lnminh1411/ESP32-PC-Control-System/host/pc_stats/README.md

# ESP32-Helper

Windows service that collects configured PC stats (hardware sensors from [PcHwCtl](#pchwctl-sensors-monitors-process-lasso)'s sensor feed) and streams them to the ESP32-S3 carrier board over a WinUSB bulk pipe (with vendor HID and CDC serial fallbacks).

## Two processes, one exe

`ESP32-Helper.exe` runs as two processes, each with its own worker threads:
- **Service** (`ESP32PcStats`, SYSTEM, session 0): stats, the USB link (WinUSB/HID/serial), the relays to PcHwCtl and LocalAIHost (power actions, screenshots, presence, RGB/fans, monitors, night mode, local AI), shutdown announcements, `@source` and `@claude` polling, text rendering, cover-art streaming. It runs before sign-in and after sign-out, at High CPU priority so the board's frames and replies stay on time while the PC is busy (the user-session half stays Normal).
- **User-session half** (`ESP32-Helper.exe --user`): Antigravity quota, Claude Code token refresh, media session and cover art, input idle and the foreground app. Windows keeps session 0 away from the desktop and the user's media sessions, so this part has to run in the user's session. The service starts it there with the signed-in user's token (normal user rights, not elevated) once someone signs in. It restarts the half if it dies (after 2 s, or 30 s if it died within 15 s of starting) and moves it on a user switch. In `--console` mode it starts the half as the current user (`--no-user` skips it).

The two talk over a pair of anonymous pipes (UTF-8 lines):

| Direction | Line | Meaning |
|---|---|---|
| user half to service | `F <feed> <n>` + n `key=value` lines | feed `agy`, `media` or `idle`, read by `@source <name> helper:<feed> <ms>` |
| user half to service | `A <base64>` | cover art, 144x144 RGB565 big-endian (41,472 bytes) |
| user half to service | `L <text>` | log line, written to `log.txt` as `user: <text>` |

Nothing travels from the service to the user half; that pipe only tells the half the service is alive. The user half exits as soon as the pipes break, so it never outlives the service. A `helper:` source counts as up while the user half is connected.

## Transport

`auto` (the default) tries three links in order, on the ESP32-S3 (Espressif VID `303A`):

1. **WinUSB bulk pipe** (interface 3, endpoints `0x04` OUT / `0x84` IN, device interface GUID `{39531AD1-55E5-4933-869D-123B4E7D172C}`). The board's MS OS 2.0 descriptors make Windows bind WinUSB by itself, with no INF and no driver install. Full-speed bulk moves about 1 MB/s against HID's 63 bytes per 1 ms frame: a cover (41 KB of base64) arrives in 115 ms instead of 690 ms. The board's parser is now the limit, not the wire. The board sends its lines (`!auth`, `!txt`, `!art`, `!power`, `!hw`, `!ai`, `!mon`, `!night`, `!shot`, `!pres`) back on this pipe while the service has sent on it within 3 s, else over HID. The service ignores what it reads in the first 500 ms after opening the pipe: an old request left in the board's buffer is never acted on.
2. **Vendor HID** (UsagePage `0xFF00`, Usage `0x01`, report length 64 bytes): Windows' in-box HID driver.
3. **Serial**: the USB CDC COM port (`@s`, `@t`, `@e` lines), or `--transport serial`.

`--transport winusb` or `--transport hid` uses only that link. With either of the first two, the CDC COM port stays free for flashing and consoles.

**Link challenge**: when `LINK_KEY` is set, the service sends `@auth <nonce>` on each new link and sends no stats and acts on no board line until the board answers `!auth <hex>` (first 16 bytes of HMAC-SHA256(`LINK_KEY`, `esp32-link <nonce>`)). An empty `LINK_KEY` means no challenge. See [docs/helper.md](../../docs/helper.md).

## Build

Run `build.cmd` from Command Prompt:
```cmd
host\pc_stats\build.cmd
```
First `gen_settings.ps1` writes `Settings.g.cs` (gitignored) from the `HOST_*` keys of `firmware\main\settings.h` (defaults in `settings_or_example.h`, `settings_example.h` when there is no `settings.h`), plus the two secrets the helper needs: `LINK_KEY` and `DISCORD_SHOT_WEBHOOK` (as `SHOT_WEBHOOK`). It reads no other key. Because the exe carries those two, `install.ps1` locks the install folder to SYSTEM and Administrators. Then it runs `dotnet publish` on `ESP32-Helper.csproj` and leaves one self-contained, single-file `build\ESP32-Helper.exe` (~56 MB, .NET 10 runtime included, nothing to install on the PC that runs it). Building needs the .NET 10 SDK; packages come from nuget.org through the repo's `nuget.config`.

Hardware sensors come from PcHwCtl (`E:\PC Hardware Controller`, service `PcHwCtl`), the only LibreHardwareMonitor reader on the PC; the helper has no LibreHardwareMonitor or PawnIO dependency of its own. `--list` shows what the feed carries.

## Installation & Removal

Run PowerShell as Administrator:
- **Install**: `.\install.ps1` (or `.\install.ps1 -ForceConfig` to overwrite existing `stats.ini`). An installed `stats.ini` that still has LibreHardwareMonitor rules (`key = Cpu | Temperature | ...`, `@every`) is replaced anyway, the old one kept as `stats.ini.old`.
  Installs files to `C:\Program Files\ESP32 PC Controller\pc_stats\` (ACL: SYSTEM and Administrators only), copies the `HOST_FONT_REGULAR` / `HOST_FONT_BOLD` font files into its `fonts\` folder, and creates/starts service `ESP32PcStats` with automatic restart on failure. Over an install from before the merge, it points the existing service at `ESP32-Helper.exe` and removes the old `ESP32 AGY Quota` scheduled task, the old `esp32-pcstats.exe` / `esp32-agyquota.exe`, and the files they used to pass data through in `C:\ProgramData\ESP32PcStats` (`media.txt`, `media_art.bin`, `shot_request.txt`).
- **Uninstall**: `.\uninstall.ps1`
  Stops and deletes the service and removes the installation directory (preserving `C:\ProgramData\ESP32PcStats\log.txt`). The log rotates at 4 MB into `log.old.txt`, so the two stay under 8 MB together.

## Command-Line Usage

```cmd
ESP32-Helper.exe                     # Run as Windows Service
ESP32-Helper.exe --console           # Run interactively, printing stats each tick (starts the user half too)
ESP32-Helper.exe --console --no-user # Same, without the user half
                                     # (in --console, typed lines starting with ! act as board lines,
                                     #  e.g. "!mon 1 bright all 50", "!night 0")
ESP32-Helper.exe --list              # Print one PcHwCtl sensor feed snapshot and exit
ESP32-Helper.exe --transport auto    # Transport mode: auto (default), winusb, hid, or serial
ESP32-Helper.exe --port COM4         # Manually specify COM port instead of VID_303A auto-detect
ESP32-Helper.exe --claude <dir>      # Test Claude live fetch & local token totals and exit
ESP32-Helper.exe --going             # Print PcHwCtl's `power status` (going, last down, wake, updates) and exit
ESP32-Helper.exe --agy-once          # Poll Antigravity quota once, print the keys and exit
ESP32-Helper.exe --agy-usage         # Run `agy /usage` once, print the panel text and the parsed Gemini windows
ESP32-Helper.exe --media             # Sample media sessions for 5 s, print the keys and exit
ESP32-Helper.exe --render-text <px> <bold> <out.png> <text...>  # Test non-ASCII GDI text rendering
ESP32-Helper.exe --user <in> <out>   # The user-session half (started by the service, not by hand)
```

## stats.ini Format

`stats.ini` lives alongside `ESP32-Helper.exe` and is monitored for changes every tick (hot-reloaded on write):
```ini
# Comments with '#', blank lines allowed. Keys: [a-z0-9_.] max 23 chars.
key = @feed [<feed key>]                     (PcHwCtl sensor feed key, default the same key)
key = @ram load|used|free                    (physical memory: used %, GB, via GlobalMemoryStatusEx)
key = @net down|up <adapter,...>             (bytes/s summed over adapters by name, '*' wildcards)
key = @uptime                                (PC uptime in seconds via GetTickCount64)
key = @drive <letter>: used|free|total|load  (GB, load = used %, via DriveInfo)
key = @cpu_mhz                               (Task Manager's CPU speed, free)
key = @ecore_load                            (average % Processor Time on E-cores)
key = @proc_mb <name>                        (summed WorkingSet64 in MB, 0 if none)
key = @counter <category> | <counter> | <instance> [| scale]   (Windows perf counter)
@interval <ms>                               (sample interval, 200-10000, default 500)
@source <name> <url> <ms>                    (poll HTTP key=value stream on background thread)
@claude <claude_dir> <live_ms>              (poll Claude live usage & scan local token spend)
```
- `@feed`: a key of PcHwCtl's sensor feed (see [below](#pchwctl-sensors-monitors-process-lasso)). Which LibreHardwareMonitor sensor feeds it, and how often, is PcHwCtl's config (`feed.keys`, `feed.every`). A key with no reading, or the feed down, goes out empty (NaN on the board). The old `<hardware> | <sensor type> | <sensor name>` rules and `@every` are gone; such lines are logged and skipped.
- `@net`: the change in the adapters' byte counters (`NetworkInterface.GetIPStatistics`) since the last tick, as LibreHardwareMonitor's Throughput sensors did. Empty on the first tick.
- `@ecore_load`: Average "% Processor Time" across E-core logical processors identified via `GetSystemCpuSetInformation` (lowest `EfficiencyClass` on hybrid CPUs; falls back to overall CPU load on non-hybrid CPUs). Counters created once at startup.
- `@proc_mb <name>`: Summed working set (`WorkingSet64`) in MB across all running processes matching `<name>` (e.g. `@proc_mb llama-server`), or `0` if none are running.
- `@source <name> <url> <ms>`: Spawns a background thread to poll an HTTP or `file:///` endpoint returning `key=value` lines, or a `helper:<feed>` feed from the user-session half (e.g. `@source media helper:media 250`). `file:///` URLs ending in `ESP32PcStats/agy_quota.txt` or `ESP32PcStats/media.txt` (stats.ini from before the merge) are read as `helper:agy` / `helper:media`. Numeric values join the `@s` stream; text values stream as `@t` lines. Generates `<name>.ok` (1 if updated within 3 x interval, 0 on timeout/error, dropping other source keys when down).
- Run `ESP32-Helper.exe --list` to see the feed's keys and current values.

## Claude Usage

The service can stream Claude Code live utilization and local spend totals to the ESP32. Configure it in `stats.ini`:
```ini
@claude <claude_dir> <live_ms>
# e.g.:
@claude C:\Users\lnminh1411\.claude 120000
```

### What It Reads
- **Live Usage**: Reads the OAuth access token from `<claude_dir>\.credentials.json` (`claudeAiOauth.accessToken`) and polls Anthropic's OAuth usage API (`https://api.anthropic.com/api/oauth/usage`). The service only reads the access token (it never refreshes it and never writes the credentials file). If the token is expired (`claudeAiOauth.expiresAt`), polling pauses with error `token_expired`. The user-session half prevents that: when less than 10 minutes are left it refreshes the token itself with the same request Claude Code makes (`https://platform.claude.com/v1/oauth/token`, Claude Code's public client id) and writes only the token fields back into the user's `.claude\.credentials.json` (if another process refreshed meanwhile, that token wins). It waits for the network before trying, retries a lost answer within seconds and other failures after 5 minutes, and logs (`user: claude: ...` in `log.txt`) when the refresh token itself nears expiry (then run `claude auth login`).
- **Local Spend & Token Totals**: Incrementally scans session transcripts in `<claude_dir>\projects\**\*.jsonl` modified in the last 31 days using an in-memory per-file byte cache. Tokens are calculated as `input_tokens + output_tokens + cache_creation_input_tokens + cache_read_input_tokens`, de-duplicated by `message.id`. Cost is estimated at standard list rates (Opus, Sonnet, Haiku).

### Keys Streamed
- **Numeric stats (`@s`)**:
  - `claude.ok`: `1` if live data is fresh (fetched within 3 x `live_ms`), else `0`
  - `claude.stale`: `1` if showing last-known live values after an error
  - `claude.s_pct`: Session (5h) utilization %
  - `claude.s_reset_s`: Seconds until session (5h) window resets
  - `claude.s_pace`: Projected % at session reset (omitted if window too new)
  - `claude.w_pct`: Weekly (7d) utilization %
  - `claude.w_reset_s`: Seconds until weekly reset
  - `claude.w_pace`: Projected weekly % at reset
  - `claude.w_<model>_pct`: Per-model weekly limit % (e.g. `claude.w_sonnet_pct`)
  - `claude.x_pct`: Extra usage % (when enabled)
  - `claude.tok_5h`: Tokens used in the last 5 hours (local logs)
  - `claude.tok_today`: Tokens used since local midnight
  - `claude.tok_7d`: Tokens used in the last 7 days
  - `claude.tok_30d`: Tokens used in the last 30 days
  - `claude.usd_today`: Estimated cost ($) since local midnight
  - `claude.usd_30d`: Estimated cost ($) in the last 30 days
- **Text stats (`@t`)**:
  - `claude.plan`: Subscription / tier plan name (`Claude Pro`, `Claude Max`, `Claude Ultra`; from `subscriptionType`)
  - `claude.s_reset_at`: Local time of session reset (`HH:mm`)
  - `claude.w_reset_at`: Local weekly reset (`ddd dd MMM HH:mm`, InvariantCulture)
  - `claude.s_pace_v`: Session pace verdict (`ok`, `tight`, `over`)
  - `claude.w_pace_v`: Weekly pace verdict (`ok`, `tight`, `over`)
  - `claude.err`: Error status (`""` when fine, else `token_expired`, `not_logged_in`, `rate_limited`, `request_failed`, `no_credentials`)

Usage logic ported from aiusage (MIT, Ahsan Habib Akik).

## Antigravity Quota

The user-session half queries the local language server exposed by running Antigravity clients (the IDE, or an `agy` CLI session for another account) over Connect-JSON API on `127.0.0.1`. It sends quota metrics to the service as the `agy` feed, which the service forwards via directive:
```ini
@source agy helper:agy 5000
```
It also keeps the last values in `C:\ProgramData\ESP32PcStats\agy_quota.txt` (the `output` setting in `agy_quota.ini`) and reloads them on start, so a client that closed keeps its numbers.

### How It Works
- **Running Client Required:** The helper cannot retrieve credentials directly from LocalSystem service context; it discovers running `language_server.exe` (IDE) and `agy.exe` (CLI) processes via WMI, finds their listening localhost TCP ports via `GetExtendedTcpTable`, and queries `GetUserStatus` with the CSRF token extracted from the process command line (tokens are never logged or written). A running Antigravity client logged into an account is required to refresh that account's quota. When a client closes, its last-known quota values are preserved while `age_s` increments.
- **Accounts & Slots:** Mapped in `agy_quota.ini` (`accounts = ...`) to slots `agy1`, `agy2`, etc. Defaults to accounts in `%USERPROFILE%\.gemini\antigravity-cli\accounts\`.
- **Model Families & Regexes:** Models are classified by label (case-insensitive) using regexes configured in `agy_quota.ini`:
  - `exclude = claude|gpt|oss`
  - `flash = flash`
  - `pro = \bpro\b|argon|ultra`
  For each family, the lowest remaining quota fraction and earliest reset time among active models are tracked. A family without quota models omits numeric keys and sends only its display name (e.g. disabled Argon).
- **Who runs it:** the service starts the user-session half in whoever is signed in at the console (see "Two processes, one exe").

### Keys Streamed
- **Global:**
  - `agy.live`: Count of active language server clients answering the poll
  - `agy.updated`: Unix timestamp (seconds) of the poll
  - `agy.active`: Account(s) signed in on a running client right now, comma list, or `none` (`@t`)
- **Per-Slot (`agy1`, `agy2`, ...):**
  - `agyN.email`: Account email address (`@t`)
  - `agyN.plan`: Plan name (e.g. `Pro`) (`@t`)
  - `agyN.live`: `1` while a running client is signed in to this account, else `0`
  - `agyN.age_s`: Elapsed seconds since account data was fetched
  - `agyN.flash_pct`: Remaining Flash quota percentage (`0.0` - `100.0`, 1 decimal)
  - `agyN.flash_reset_s`: Seconds until Flash quota reset (`>= 0`)
  - `agyN.flash_reset_at`: Local time of Flash reset (`ddd HH:mm`, InvariantCulture) (`@t`)
  - `agyN.flash_name`: Flash family display name (`@t`)
  - `agyN.pro_pct`, `agyN.pro_reset_s`, `agyN.pro_reset_at`, `agyN.pro_name`: Same metrics for Pro family
  - `agyN.flash_5h_pct`, `agyN.flash_5h_reset_at` (`HH:mm`), `agyN.flash_5h_reset_ts` (unix s): Gemini 5-hour window, from Google's quota API with agy's stored login (the access token is renewed in memory only)
  - `agyN.flash_wk_pct`, `agyN.flash_wk_reset_at` (`ddd HH:mm`), `agyN.flash_wk_reset_ts`: Gemini weekly window; the weekly figure is overridden by what `agy /usage` shows (read in a ConPTY every 10 min, 1 min after a failed read)

## Media Playback & Cover Art

The user-session half polls `GlobalSystemMediaTransportControlsSessionManager` every 250 ms to read active media sessions (Spotify, browsers, media players). It sends the keys as the `media` feed and the cover art as an `A` line, the art before the feed that names its id.

The service reads the feed via:
```ini
@source media helper:media 250
```

### Keys Streamed
- **Numeric stats (`@s`)**:
  - `media.ok`: `1` if an active media session exists, else `0` (other media keys omitted when `0`)
  - `media.playing`: `1` if playback is active, `0` if paused or stopped
  - `media.pos_s`: Playback position in seconds (extrapolated from `TimelineProperties.LastUpdatedTime` while playing)
  - `media.len_s`: Track duration in seconds
  - `media.art_id`: CRC32 of the 144x144 RGB565 cover art (as the user half sends it) as an unsigned decimal (`0` = no art)
- **Text stats (`@t`)**:
  - `media.title`: Track title (one line, <= 80 chars)
  - `media.artist`: Artist name (one line, <= 80 chars)
  - `media.album`: Album name (one line, <= 80 chars)
  - `media.source`: Friendly app name (`Spotify`, `Chrome`, `Edge`, `Firefox`, `Brave`, `Opera`, `Vivaldi`, `VLC`, `foobar2000`, or executable / AUMID tail)

### Cover Art Push Protocol (`@a`)
When `media.art_id` transitions to a non-zero value and the latest art from the user-session half has a matching CRC32:
1. The user half center-crops the cover to a square, bicubic-scales it to 144x144 and sends it as RGB565 big-endian (41,472 bytes). The panels are 12-bit, so the service packs it to RGB444 (2 pixels in 3 bytes, 31,104 bytes) and Base64-encodes that (41,472 characters).
2. The service streams art across sample ticks:
   - Header: `@a begin <id> 144 144 444`
   - Data lines: `@a d <base64>` in lines of at most 160 base64 chars
   - Terminator: `@a end <id> <crc32 of the packed RGB444 bytes as 8 hex digits>`
3. Chunks are appended after the `@e` line, so regular sensor streaming never stalls. Each tick carries up to 48,000 base64 chars of `@x` text and `@a` art together, text first (up to 12,000).
4. If the ESP32 carrier board requests art retransmission via `!art <id>` (received over whichever link is active), the service immediately restarts streaming that art from the beginning.

### Console Testing
Run `ESP32-Helper.exe --media` to sample media sessions for 5 seconds, print the keys to the console, and save the current cover art decoded back from the RGB565 buffer to `K:\scratch\media_art.png`.

## Wire Protocol

ASCII lines streamed every `@interval` ms (default 500):
```
@s key=value key=value ...
@t key text
@e <seq>
```
- `@s`: Space-separated `key=value` numeric tokens, split into lines of at most 300 characters. Value formatted as float `G7` (InvariantCulture), or empty if no reading (e.g. `gpu1_fan=`).
- `@t <key> <text>`: Text stats encoded in UTF-8 without BOM (rest of line up to 120 UTF-8 bytes, never splitting a character or surrogate pair; newlines/tabs converted to spaces, e.g. for track titles, artist, or system status).
- `@e <seq>`: End of sample packet with an incrementing sequence number.

When transported over the vendor HID interface:
Each packet is chunked into 63-byte pieces; each report starts with Report ID `0x06` followed by up to 63 payload bytes, zero-padded to 64 bytes total. The firmware discards zero bytes and reassembles lines identically.

### Non-ASCII Text Bitmap Push Protocol (`@x`)

When the ESP32 carrier board needs to display a text value containing non-ASCII characters (e.g. Japanese, CJK, Thai, accented characters, emoji) that its built-in ASCII font cannot display, it requests a rendered grayscale bitmap from the host.

#### 1. Inbound Board Request (`!txt`)
Sent from the carrier board over the active link (WinUSB bulk IN, HID INPUT report 6, or serial):
```
!txt <id> <px> <bold> <key> [<base64 text>]
```
- `<id>`: Decimal uint32 CRC32 of the UTF-8 bytes of the text value.
- `<px>`: Font pixel size (em height), integer in range `8`..`64`.
- `<bold>`: `1` for bold, `0` for regular.
- `<key>`: Text metric key (e.g. `media.title`).
- `<base64 text>`: optional; the text itself, when the board has it from somewhere other than an `@t` stat (e.g. the weather place name). The CRC still has to match.

Without it, the host validates the request against its dictionary of last-sent `@t` values under a lock:
- If `<key>` is not found or its CRC32 does not match `<id>`, the request is ignored (the board will ask again with the updated id).
- Requests identical to one served within the last 5 seconds are ignored to avoid duplicate rendering spikes.
- At most 4 pending renders are queued at a time (additional requests dropped when full).
- Each request served or rejected is logged (key, id, w x h; the text itself is never logged for privacy).

#### 2. Host GDI Rendering
- **Fonts**: Looks for `HOST_FONT_REGULAR` and `HOST_FONT_BOLD` (default `ComicShannsMonoNerdFontPropo-Regular.otf` / `-Bold.otf`) in `C:\Windows\Fonts`, then in `<install dir>\fonts\` (where `install.ps1` copies them, so the SYSTEM service never parses a font from a user-writable folder). Loaded once via Win32 `AddFontResourceEx` (`FR_PRIVATE = 0x10`). If unavailable, falls back to `HOST_FONT_FALLBACK` (`Segoe UI`, logged once).
- **Fallback Font Linking**: Rendered using Win32 GDI `CreateFontW` (`ANTIALIASED_QUALITY = 4`, grayscale, no ClearType) and `DrawTextW` on a memory DC, enabling automatic Uniscribe font fallback for non-Latin scripts (Japanese, CJK, etc.).
- **Measurement**: `w = measured width + 2` (capped at 1600), `h = tmHeight` from `GetTextMetricsW`, `ascent = tmAscent`.
- **Drawing**: Rendered white text (`SetTextColor 0xFFFFFF`, `SetBkMode TRANSPARENT`) onto a black, top-down 32-bpp DIB section (`CreateDIBSection`) at `x = 1`, `y = 0` (`DT_SINGLELINE | DT_NOPREFIX | DT_NOCLIP`).
- **Packed 4-Bit Alpha Format**: Alpha of each pixel is `max(R, G, B) >> 4` (0..15). Packed rows top-to-bottom with stride `(w + 1) / 2` bytes (2 pixels per byte, HIGH nibble = left pixel, LOW nibble = right pixel). All GDI objects are freed immediately.

#### 3. Outbound Streaming Protocol (`@x`)
- Header: `@x begin <id> <px> <bold> <w> <h> <ascent>`
- Data lines: `@x d <base64>` in lines of at most 160 base64 chars
- Terminator: `@x end <id> <crc32 of packed bytes as 8 lowercase hex digits>`

Text transfers go first in each tick, up to 12,000 base64 characters; cover art (`@a`) gets the rest of the 48,000-character budget. Only one text transfer runs at a time, completing fully before the next queued transfer begins.

#### 4. Test Mode
Inspect font rendering and Uniscribe fallback directly from the command line:
```cmd
ESP32-Helper.exe --render-text <px> <bold> <out.png> <text...>
```
Example:
```cmd
ESP32-Helper.exe --render-text 20 1 K:\scratch\t.png "Atena ア テ ナ"
```
Renders the text using the identical GDI pipeline, exports a 4x nearest-neighbor scaled PNG with alpha mapped to brightness for visual inspection, and prints:
```
<w> <h> <ascent> <packed_bytes>
```

## Power Control and Wake-on-LAN

The service supports bidirectional power management with the carrier board:

### Protocol
- **Device -> Host (Power Requests)**: Sent on the WinUSB bulk IN pipe, or as HID INPUT reports on report ID 6 (63-byte ASCII payload, zero-padded, `\n`-terminated; also accepted over serial CDC fallback). Format:
  ```
  !power <action> <nonce>
  ```
  where `<action>` is strictly allowlisted to `sleep`, `hibernate`, `restart`, `shutdown`, or `lock`, and `<nonce>` is 1-8 hex digits. Any command not matching this exact format is logged and ignored without acking. Duplicate nonces within 60 seconds are discarded to prevent repeated executions.
- **Who acts**: PcHwCtl, nothing in the helper. The helper sends `power do <action> <delayMs>` on PcHwCtl's pipe (E:\PC Hardware Controller, docs/ipc.md#power-actions-and-events); PcHwCtl accepts or declines at once and carries the action out after the delay, so the ack reaches the board first. The delay is 1500 ms for `restart`, `shutdown` and `lock`. For `sleep` and `hibernate` it is 8000 ms and the helper turns the monitors on first (`display wake`, `display power all on`): a monitor that night mode powered off over DDC/CI would otherwise stay dark after the wake until PcHwCtl's agent is back. A displays-off that arrives before the PC is down is skipped.
- **Host -> Device (Ack)**: Sent in the regular sample stream as a text stat for 10 seconds: `@t power.ack <action> <nonce>` (e.g. `@t power.ack sleep 3f2a`) when PcHwCtl accepted, `@t power.ack error <nonce> <reason>` when it declined, with PcHwCtl's reason (`Hibernation is off.`, `Windows is installing updates.`, `A shutdown is already under way (by X.exe).`, ...). PcHwCtl not running gives `error <nonce> PcHwCtl offline, use Reset`: nothing on the PC can act then, and the board's Reset button (behind its confirm) is the way left. The board posts the reason to Discord.
- **Wake-on-LAN Target**: The host discovers and continuously advertises its primary network adapter MAC address and interface name in every sample:
  ```
  @t pc.mac AA:BB:CC:DD:EE:FF
  @t pc.mac_if Ethernet
  ```
  The adapter is chosen by priority: (1) operational wired Ethernet adapter with an IPv4 gateway, (2) any Ethernet adapter, (3) any up adapter with a gateway (skipping virtual adapters such as Hyper-V, VirtualBox, VMware, TAP, Loopback, Bluetooth, WAN Miniport). Refreshed every 30 seconds.

### Hardware Fallback
When the helper sends no stats, the board's `power sleep` and `power shutdown` fall back to its USB HID System Control keys (Windows applies its own power and sleep button settings). For a hung PC the board pulses the motherboard Reset header through an optocoupler (the Reset button behind its confirm). There is no power-button opto: the board wakes the PC or powers it on with USB remote wakeup and Wake-on-LAN.

### Wake-on-LAN Prerequisites
To wake the PC from sleep or powered-off state (S5) using Magic Packets:
1. **NIC Configuration**: In Windows Device Manager, open the Ethernet adapter Properties -> *Power Management* tab (or *Advanced* tab) and enable **Wake on Magic Packet** and allow the device to wake the computer.
2. **BIOS / UEFI Settings**: Disable **ErP Ready** / **Deep Sleep** (or set to Disabled) and enable **Wake on LAN** / **Power On By PCI-E Device**. If ErP is enabled, the motherboard cuts standby power (+5VSB) to the Ethernet controller when shutdown, preventing the NIC from receiving magic packets.

## Restart / Update Detection

PcHwCtl watches the System event log (1074, Kernel-Power 41/42/109, EventLog 6008, Power-Troubleshooter 1) and the update registry keys; see its docs/ipc.md#power-actions-and-events for every key and how it is derived. The helper carries PcHwCtl's state-file keys to the board under the names the board reads:

- `hw.going`, `hw.going_by`, `hw.going_why`, `hw.going_code`, `hw.going_user`, `hw.going_id` -> `pc.going*` (kinds `restart`, `shutdown`, `update_restart`, `update_shutdown`, `sleep`, `hibernate`, `none`; a new `pc.going_id` is a new announcement).
- `hw.last_down`, `hw.last_down_at`, `hw.last_down_by`, `hw.last_down_why` -> `pc.last_down*` (also `bluescreen`, `power_button`, `unexpected`, `unknown`).
- `hw.update_pending`, `hw.update_pending_by` -> `pc.update_pending*`; `hw.update_running` -> `pc.update` (installing right now).
- `hw.wake_from`, `hw.wake_at`, `hw.wake_by` -> `pc.wake_*`; `hw.power_do`, `hw.power_do_at` -> `pc.power_do*`.

While PcHwCtl is down (`hw.ok=0`) the helper sends `pc.going none`, `pc.going_id=0`, `pc.update_pending=0`, `pc.update=0` and `pc.last_down unknown`, so the board holds no stale announcement.

When Windows suspends (`OnPowerEvent(Suspend)`) or stops the service at shutdown (`OnShutdown()`), the helper re-reads PcHwCtl's state file at once (up to 1.2 s / 1 s, until `hw.going` is set) and pushes a sample before USB goes away.

### Console Verification

```cmd
ESP32-Helper.exe --going
```
Prints PcHwCtl's `power status` JSON (going, last down, wake, updates, last `power do`).

## PcHwCtl: sensors, monitors, Process Lasso

PcHwCtl (`E:\PC Hardware Controller`, github.com/lnminh1411/PC-Hardware-Control-Service) is the PC's fan, RGB, monitor and Process Lasso service. The helper talks to it on its named pipe `\\.\pipe\PcHwCtl` (`HOST_HWCTL_PIPE`; protocol in its `docs/ipc.md`) and reads its state file through `@source hw file:///C:/ProgramData/PcHwCtl/state.txt 1000`.

**Sensor feed** (`Feed.cs`): the service sends `subscribe sensors` and keeps the newest pushed block (`seq=`, `ts=`, then `key=value` lines, an empty line ends it, about every 500 ms). `@feed` rules read from it. No block for 3 s or a broken pipe: every `@feed` key goes out empty, as when a sensor fails, and the reader reconnects with a 1 s back-off doubling to 30 s. The log says `feed: 21 sensors from PcHwCtl` on (re)connect and the reason once per outage.

**Monitors**: the board's `!mon <id> bright <n|all> <0-100>` becomes `display bright <n|all> <pct>`; `!mon <id> power <n|all> off` becomes `display power <n|all> off`, plus `display sleep` (Windows' display off) for `all`; `power ... on` becomes `display wake` (for `all`) then `display power <n|all> on`. PcHwCtl's user-session agent does the DDC/CI, with each model's power method (DDC power for the DELLs, an input switch for the MSI). The answer reaches the board as `monctl.reply` (`<id> ok` or `<id> err <why>`, 30 s). The monitors' state comes from the state file as `hw.mon.*` and goes to the board renamed to `mon.count`, `mon.<n>.name`, `.main`, `.bright`, `.power`, the keys the board's PC Monitor Control panel reads.

**Presence** (`Presence.cs`): the board's `!pres <seconds>` (every 30 s, `0` or 90 s of silence stops) and `!pres now` run PcHwCtl's `presence` on one thread, so checks never overlap. Each answer goes to the board as the text stat `pc.present`, `<n> <yes|no|unknown> <why> <conf %> <zone>` (zone: `desk`, `near`, `room` or `-`), one text so its fields can't arrive apart; `why` is PcHwCtl's, or `pipe` with PcHwCtl unreachable. The rules are the board's (docs/power-and-night.md).

**Screenshots**: the board sends only `!shot <nonce>`. The helper adds its compiled webhook (`DISCORD_SHOT_WEBHOOK`, which never crosses USB) and sends `screenshot <nonce> <webhook>` to PcHwCtl (15 s timeout); its agent captures, shows the border, uploads and later deletes. The helper logs only the outcome (`captured` / `declined: <why>`), never the webhook.

**Night mode** (`Night.cs`): the board decides and owns the sleep / hibernate timers; the helper carries it out. `!night 1` sends `lasso save day` (the normal `prolasso.ini` kept as PcHwCtl profile `day`), then `aff set <exe> <HOST_NIGHT_CORES>` (E-cores 14-17) and `eco on <exe>` (Windows efficiency mode; PcHwCtl sweeps new instances) for every running process and every whole-exe rule outside the keep list: `HOST_NIGHT_KEEP` plus Process Lasso's ProBalance exclusions (`OocExclusions`, read from the ini, since PcHwCtl has no command for them). PcHwCtl writes each rule and pins the running processes at once. Last, `power plan night` switches to PcHwCtl's night power plan. Names with spaces and rules not ending in `.exe` are skipped (`aff set` takes one word ending in `.exe`). Heavy exes are left alone: every 10 s the helper asks PcHwCtl for `proc top 50` (cores per exe, 1.0 = one core busy, summed over instances); an exe averaging `HOST_NIGHT_HEAVY_CORES` (0.8) for `HOST_NIGHT_HEAVY_S` (120 s) is heavy until it averages under `HOST_NIGHT_CALM_CORES` (0.3) for `HOST_NIGHT_CALM_S` (300 s). This runs all night: a pinned exe that turns heavy gets its day rule back (`aff set` with the day's CPUs, else `aff clear`) and `eco off`; a calm one gets pinned. The foreground full-screen app (`pc.fg_full`, `pc.fg_exe` from the user half) is left alone the same way. Exes in `HOST_NIGHT_ALWAYS` stay pinned even while heavy. New process names are pinned within 10 s. `pc.heavy` (how many exes are heavy, kept ones included, `HOST_NIGHT_HEAVY_IGNORE` left out: `svchost` and `msmpeng` by default, since a service host summed over dozens of instances never calms down and real work holds sleep through a power request) and `pc.heavy_by` (the busiest) go to the board all day; it won't sleep or hibernate the PC while `pc.heavy >= 1`. `!night 0` sends `lasso load day` (the normal ini back, every process on its own rule or every CPU; retried every 10 s if it fails), `eco off all` and `power plan day`. Once a minute the helper also asks PcHwCtl for `power caps` and sends `pc.hib` (0 when hibernation is off), which the board uses to hide Hibernate. `night.on` in `C:\ProgramData\ESP32PcStats` marks night engaged and lists the exes pinned and the day's rules, so a restart mid-night restores rather than saving the night config as `day`. After `HOST_NIGHT_NO_WORD_MIN` (5) min without the board's 30 s repeat, the helper sends `lasso load day` itself. A `prolasso.ini.esp32-night` left by the helper's older night code blocks night mode (logged once) until it is copied back over `prolasso.ini` by hand. `pc.disp_req` / `pc.disp_req_by` (a process holds the display awake, so the board holds night mode off), `pc.sys_req` and `pc.exec_req` (each with `_by`; they hold the board's night sleep) are PcHwCtl's `hw.*_req*`, renamed.

The user half still sends the `idle` feed every second (`Idle.cs`, `@source idle helper:idle 1000`): `pc.idle_s`, seconds since the last keyboard or mouse input in the session (`GetLastInputInfo`), for the board's night mode, plus `pc.in_px` (mouse travel) and `pc.in_press` (key and button presses), counters the board uses to tell a real return from a bumped mouse. XInput gamepads count too (Windows' idle time ignores them): a button or trigger is a press, a stick past its dead zone 20 px per 100 ms. `pc.fg_full` = 1 while the foreground app runs full screen (`SHQueryUserNotificationState`), `pc.fg_exe` names the foreground app.

## USB COM Port Notice

When connected over the WinUSB pipe or the vendor HID interface (`auto` uses one of them), the ESP32-S3's USB CDC COM port is completely unused by the service. Firmware can be flashed and serial consoles opened without stopping the service.

If the serial fallback is in use (or forced with `--transport serial` or `--port`), the service holds an open handle on the CDC COM port. In that case, stop the service before flashing:
```cmd
sc.exe stop ESP32PcStats
```
After flashing:
```cmd
sc.exe start ESP32PcStats
```
