lnminh1411/ESP32-PC-Control-System/Scripts.md

# Scripts Summary

### board_config.py
Shared configuration for the board build scripts including revisions, dates, net classes, and tool paths. Used across the KiCad automation chain. Located at `scripts/board_config.py`.

### make_blank_pcb.py
Creates a blank 2-layer KiCad board file with title block metadata. Used to start the board layout from scratch. Located at `scripts/make_blank_pcb.py`.

### sync_netlist_to_board.py
Imports atopile netlists directly into the KiCad PCB file via the pcbnew API. Assigns footprints and pad nets without requiring the GUI. Located at `scripts/sync_netlist_to_board.py`.

### layout_board.py
Places footprints based on measured geometry, creates board outlines, mounting holes, and silkscreen labels. Must be executed on a blank board. Located at `scripts/layout_board.py`.

### add_pours.py
Pours ground planes on bottom copper and sets antenna keepout zones on all copper layers. Ensures keepouts exist before routing. Located at `scripts/add_pours.py`.

### route_spi.py
Hand-routes critical nets including SPI display daisy chains, control lines, power rails, and optocoupler channels. Minimizes layer transitions and avoids T-junctions. Located at `scripts/route_spi.py`.

### route_board.py
Autoroutes remaining signals using Freerouting via Specctra DSN export and SES import. Serves as a fallback for routes not handled by `route_spi.py`. Located at `scripts/route_board.py`.

### chamfer_corners.py
Replaces 90-degree track bends with 45-degree diagonal chamfers while avoiding copper collisions. Improves signal integrity and manufacturing yield. Located at `scripts/chamfer_corners.py`.

### check_spi_topology.py
Verifies SPI display traces remain on top copper with daisy-chain ordering MCU -> display 1 -> 2 -> 3. Ensures no unwanted vias or T-junctions exist. Located at `scripts/check_spi_topology.py`.

### render_board.py
Generates 2D copper/silkscreen renders and slanted 3D perspective previews of the PCB layout. Outputs rendered images to `pcb/build/renders/`. Located at `scripts/render_board.py`.

### export_gerbers.py
Generates manufacturing Gerber files, Excellon drill files, and job definitions packaged in a ZIP archive. Saves output to the configured artifacts directory. Located at `scripts/export_gerbers.py`.

### make_fit_models.py
Generates VRML 3D fit-check models for the boost converter and microcontroller envelopes. Enables visual clearance checking in 3D renders. Located at `scripts/make_fit_models.py`.

### check_pins.py
Validates firmware GPIO definitions against the atopile hardware pin map. Helps catch pin assignment mismatches before flashing. Located at `scripts/check_pins.py`.

### gif_pack.py
Builds `firmware/main/gifs.bin`, the GIF pack for the board's `gifs` partition, from `firmware/gifs/gifs.json` and the GIFs it lists. Run `python scripts/gif_pack.py` after changing them, then flash; it prints the pack and PSRAM sizes. Located at `scripts/gif_pack.py`.

### idf_flash.py
Builds and flashes `firmware` over the native USB port hands-off: stops the ESP32PcStats service (no UAC prompt when it is already stopped), does a 1200-baud touch on COM12, waits for the ROM downloader port, compares each image's MD5 on the board and writes only the changed ones (`--full` = `idf.py flash`). Run it with the ESP-IDF Python (`C:\Espressif\python_env\idf5.5_py3.12_env\Scripts\python.exe scripts\idf_flash.py [--no-build]`). Located at `scripts/idf_flash.py`.

### make_vlw.py
Converts a TTF/OTF font into an anti-aliased LovyanGFX VLW font as a C array (`font_*.cpp` in firmware/main). Usage: `python scripts/make_vlw.py FONT.otf SIZE NAME OUT.cpp [--extra U+F2C9]`. Located at `scripts/make_vlw.py`.
### layout_upload.py
Uploads a dashboard layout JSON (format in docs/layouts.md) to the board without reflashing: serial in base64 chunks (`--port COM12`) or HTTP `PUT /layout` (`--host esp32-pc-control.local`, password from the `OTA_PASS` environment variable, else settings.h). Usage: `python scripts/layout_upload.py FILE.json --port COM12`; the board rejects invalid JSON and keeps the old layout. Located at `scripts/layout_upload.py`.
### settings_doc.py
Regenerates `docs/settings-reference.md` from `firmware/main/settings_or_example.h`: every non-secret key with its default and note, one table per section. Run it after adding or changing a setting: `python scripts/settings_doc.py`. Located at `scripts/settings_doc.py`.

### panel_shot.py
Saves one panel as a PNG: sends `shot <n>` on the board's CDC console and decodes the RGB565 canvas it streams back (GIF faces include the current frame). Usage: `python scripts/panel_shot.py 1 out.png [--port COM12] [--scale 2]`. Located at `scripts/panel_shot.py`.

### readme_shots.py
Captures every face for `docs/images/screens.png` from an elevated shell: stops the helper service, feeds the board made-up stats, cover art and a rendered title, forces each face and grabs it with `shot`, then restores the faces and the service (`--real-media` keeps the playing track). Located at `scripts/readme_shots.py`.
