lnminh1411/ESP32-PC-Control-System/docs/power-and-night.md

# Power control and night mode

How the board turns the PC on and off, and the night mode it runs on its own.
The console side is in [console.md](console.md), the buttons in
[discord.md](discord.md#control-panel).

## Power control

| Action | Path |
|---|---|
| Power on from shutdown, wake from sleep | `wake`: USB remote wakeup when the USB link is suspended, plus a Wake-on-LAN magic packet on the home network when Wi-Fi is up; either one counts. There is no power-button opto |
| Shutdown / sleep / hibernate / restart / lock | `power <sleep\|hibernate\|restart\|shutdown\|lock>`: the board sends `!power <action> <nonce>` over the USB link, the PC helper hands it to PcHwCtl, which accepts or declines at once and acts 1.5 s later (8 s for sleep and hibernate, see [Sleep and hibernate](#sleep-and-hibernate)). With no answer from the helper in 3 s, sleep and shutdown fall back to HID System Control keys |
| Hard reset of a hung PC | RST opto (`reset` command: this resets the PC, not the board) |
| Power cut | BIOS "Always Power On after AC loss" boots the PC when power returns |

What the PC needs for this:
- BIOS: Wake-on-LAN enabled, "Restore on AC power loss" = Power On. The
  ErP / deep-sleep option must be off, or the network card loses power at
  shutdown and WoL cannot work.
- Windows: Fast Startup off (it can stop WoL from working after a shutdown), and the network
  adapter's "Wake on Magic Packet" enabled. Updates sometimes reset these.
- Wired Ethernet: most WiFi adapters can't wake from shutdown.

If the ESP32 itself gets stuck, flipping the PSU switch power-cycles it, and
the AC-loss setting brings the PC back up. See
[recovery-and-physical-access.md](recovery-and-physical-access.md).

Every power action (sleep, hibernate, restart, shutdown, lock) is PcHwCtl's
job: the PC service only forwards it (`power do <action> 1500`, or 8000 for
sleep and hibernate) and acks the board. PcHwCtl can decline ("Hibernation is off.", "Windows is installing
updates.", ...), and the board posts the reason to Discord. With PcHwCtl not
running the answer is "PcHwCtl offline, use Reset": nothing on the PC can act
then, and PC reset (behind its confirm) is what is left. Lock needs this path
too: the board has no keyboard to send Win+L.

## Night mode

**Night mode** (PC Control, console `night`) engages between 22:00 and 06:00
once the PC has had no keyboard or mouse input for 5 minutes (the service's
user-session half reads Windows' idle counter, stat `pc.idle_s`). It sets the
PC's RGB LEDs to 10 %, the board's panels to 10 % on their PC-off screens, and
caps the status LED at 20 %. Past those 5 minutes the camera decides how it goes
([Presence at the desk](#presence-at-the-desk)). It also turns the PC's displays off, and back on when
it ends (or interrupted): a PC asleep or hibernated then gets them on as soon as
it is back, retried every 30 s until the PC service says ok. Input on the
PC puts everything back, and 5 more idle minutes engage it again. At 06:00 the
board side goes back at once, and the LEDs go back as soon as the PC and
PcHwCtl answer. Each change is posted to #pc-announcement. "Night auto" is the
automatic engage; "Start night now" engages it at once, at any hour, until
input on the PC or "End night now".

Both night mode and Low power mode also switch Windows to PcHwCtl's "PcHwCtl
Night" power plan (5 % processor cap, half the cores parked; PcHwCtl
`docs/ipc.md`, "The PcHwCtl Night plan"), and back to PcHwCtl's day plan
(High performance) when they end. The PC Control tab shows the active plan.

## Low power mode

**Low power mode** (PC Control button "Low power", console `night low on|off`)
is the night's power side by hand, at any hour, until turned off: Process
Lasso's night config (E-cores in efficiency mode, heavy exes left alone, the
same `!night 1` night mode sends), PC LEDs 10 %, board panels 10 % with their
normal faces, status LED capped at 20 %. Displays stay on, the PC never sleeps,
and input does not end it. It survives a board restart. On and off are posted
to #pc-announcement and Pushover; a night that ends while it is on leaves it on.

## Evening dim

From 21:00 (`MON_DIM_START_HOUR`) until the night window closes (06:00,
`NIGHT_END_HOUR`), every PC monitor that is on goes 1 % darker each minute
(`MON_DIM_STEP_PCT`), from the brightness it reports over DDC/CI, down to 0.
Raised by hand, it goes down again from there. At 06:00 all of them go to 20 %
(`MON_MORNING_PCT`), once after each evening that dimmed them: owed in NVS
until PcHwCtl answers ok, so a PC that is off or asleep at 06:00 gets it when
it is back, and a board restart later in the day changes nothing.
`MON_DIM_ENABLED 0` turns both off. It runs whether night mode is on or not.

## Guards against false triggers

- **Wake check.** Input during the night ends it at once: the PC's displays
  come back on, with everything else. If the next 10 s show no real return
  (more than 50 px of mouse travel, or 3 key / mouse button presses;
  `pc.in_px`, `pc.in_press` from the user-session half, gamepad buttons and
  sticks count too), a bumped mouse, the night comes straight back, with no
  post, and its sleep clock carries on. A real return keeps it off and posts
  "Back to normal". The wake asks for a camera check at once: someone at the
  desk is a real return whatever the input, and nobody there overrules real
  input (a cat on the keyboard). The camera can only do that once per 2 min
  (`NIGHT_GUARD_VETO_MS`), because a dim room can miss you and you would
  never get the night off. A check that can't tell leaves it to the input.
- **Video.** No automatic start while a process keeps the display on (a video
  playing, a presentation): PcHwCtl reads `powercfg /requests` every 10 s and
  the PC service passes it on (`pc.disp_req`, `pc.disp_req_by`). The PC
  Control tab shows who holds it.

## The night pass on the PC

While engaged, the PC service has PcHwCtl move every non-critical
background process to four E-cores (14-17 on the Core Ultra 7 265K) in Process
Lasso's config (`C:\ProgramData\ProcessLasso\config\prolasso.ini`), pin the
running ones at once and put them in Windows' efficiency mode (`lasso save
day`, then `aff set` and `eco on` per exe; PcHwCtl puts new instances in
efficiency mode too). The kernel and session processes, the desktop shell,
audio, this stack, Process Lasso and its ProBalance exclusions are left alone.
So is a heavy exe: one averaging 0.8 cores or more (1.0 = one core busy,
summed over its instances) for 2 minutes, such as a render or a long
calculation, and the foreground full-screen app (a game can be light on CPU).
The check runs all night: a pinned exe that turns heavy gets its day rule back
and leaves efficiency mode, and an exe left alone is pinned once it stays
under 0.3 cores for 5 minutes. When the night ends, `lasso load day` puts the
normal config back and `eco off all` lifts efficiency mode (a failed `lasso
load day` is retried every 10 s). The PC service only reads `prolasso.ini`
(for the ProBalance exclusions); PcHwCtl writes the rules. If the board stops
confirming the night for 5 minutes, the service does that by itself.

## Presence at the desk

PcHwCtl answers "is someone at the PC?" (`presence`, its `docs/ipc.md`): the
user-session agent opens the camera for 1-2 s, runs YOLO11n on the NPU, and
answers in about 3.5 s. The frame stays in its memory and is zeroed after
inference. The board sets the pace with `!pres <seconds>`, the helper runs the
checks one at a time and reports `pc.present` ("<n> <yes|no|unknown> <why>
<conf %> <zone>"), and `presence.cpp` holds the rules. A check can answer `unknown`:
`dark` (luma under 10, nobody seen), `camera` (in use, unplugged, privacy off),
`agent` (nobody signed in), `pipe` (PcHwCtl down). Unknown never triggers
anything, and never counts as nobody. The PC Control tab shows the last answer
in its Presence field.

`zone` is PcHwCtl's distance class for the person seen, from its depth model:
`desk` (in the chair or right behind it, ~0.5-0.8 m), `near` (~0.8-1.6 m),
`room` (further), `-` (nobody, or too dim to judge the distance). Someone seen
only in `room` counts as **nobody at the desk** for every rule: walking past or
lying in bed doesn't keep the displays on by day, hold the night off, or start
the intruder rule. `desk`, `near` and `-` count as someone, as before. The
status reads `someone in the room, not at the desk`; `presence seen room`
fakes one. A helper without the zone field still works (four fields).

**Presence on/off** (PC Control button, console `presence on|off`, kept in NVS,
on by default) stops the camera checks. While off no answer counts: night mode
goes by input alone, and the desk and intruder rules rest. The phone-away
displays-off doesn't use the camera and still applies.

| When | Check | Rule |
|---|---|---|
| Night window, Night auto on, 5 idle minutes over | every 10 s | Someone there: the night holds off, displays on. After 30 min (`NIGHT_DESK_HOLD_S`), still idle and nothing blocking sleep: night engages, displays off. Nobody (two checks in a row): night engages and the PC sleeps at once, or only the displays go off while something blocks sleep, and it sleeps when that clears. Can't tell: the night engages as it always did, sleep 1 h after the last input |
| Phone beyond 200 m (`PRESENCE_AWAY_KM`) | every 10 s | Someone there: see below |
| At home, Night auto off or outside its window | every 10 s (`PRESENCE_DAY_S`); every 2 s while the displays are off (`PRESENCE_BACK_S`; PcHwCtl's `presence.minIntervalS` must be 2 or less) | Nobody seen at the first check (`PRESENCE_DAY_OFF_S` 0) and no input for 10 s (`PRESENCE_DAY_IDLE_S`), nothing keeping the display on (a playing video's wake lock holds it): Windows' own display off (`display sleep`, no DDC/CI: the monitors keep their power). After 5 min of nobody (`PRESENCE_DAY_LOW_S`; each switch moves every process, too much for a short trip), low power mode on, PC only (Process Lasso night config; PC LEDs, board panels and status LED unchanged; button reads "Low power: PC only", pressing it makes it the full mode), unless something holds sleep (tried again at each check). It stays on while the phone is away. The board panels switch to their PC-off faces and the clock chip reads "AFK" (also while the phone is away and the displays are off). Someone seen, input, the PC going off or the phone coming home: displays on, and low power mode off if this turned it on (one turned on by hand stays) |

The phone going beyond 200 m turns the displays off, at any hour; back within
180 m (`PRESENCE_HOME_KM`, a margin so a fix on the line doesn't flap) turns
them on, unless night mode wants them off. A fix vaguer than 150 m
(`PRESENCE_ACC_M`) switches neither way, and no valid fix counts as home. Input
on the PC while away gives the displays back until 5 min pass without input
(`PRESENCE_AWAY_IDLE_S`): a dead phone must not leave you at a dark screen.

Someone using the PC while the phone is away: two `yes` in a row (the second
is the next 10 s check; PcHwCtl answers a call within 10 s of a check with that
same check) with input on the PC in the last 30 s (`PRESENCE_USE_S`) lock the
PC (again at every further `yes`, so unlocking it doesn't last) and send a red
"Someone at your PC" post to #pc-announcement and
a Pushover emergency alert, which repeats every 60 s for an hour or until
acknowledged. Someone in the room who leaves the PC alone gets nothing (logged
once). After the first alert, staying at the desk is enough: the alert repeats
every 10 min while someone stays (`PRESENCE_ALERT_REPEAT_S`). A phone fix older than 2 min could be you, home
already, so the board first asks the phone for its location
(`reportLocation`) and waits up to 30 s; a fix inside the line cancels the
alert, the lock has already happened.

`presence dry on` (console, not saved) logs the lock, the alert, night posts,
display changes and sleep instead of doing them; `presence away on|off|auto`
fakes the phone and `presence seen yes|no|unknown` fakes a check.

Limits: the camera sees nothing in a dark room with the monitors off, so at
night with the lights out rule one is the old timer and an intruder in the dark
is not detected. The check at the desk can't tell you from anyone else. No
screenshot goes with the alert.

## Sleep and hibernate

Sleep (Windows' own timers off; the board keeps it, in the night window only):
1 hour after the last real input on the PC (false wakes don't count) the board
sleeps the PC, or at once with nobody at the desk (not in a night started by
hand). There is no timed hibernate. It waits, with the displays off,
while an exe is heavy (`pc.heavy`, kept ones included except
`HOST_NIGHT_HEAVY_IGNORE`: `svchost` and `msmpeng` by default, since a service
host summed over dozens of instances never calms down; they are still left
off the E-cores while heavy), a power request keeps the PC up (`pc.disp_req`,
`pc.sys_req`, `pc.exec_req`, minus `NIGHT_REQ_IGNORE`: `claude.exe` always
holds one) or the network averages more than 1 MB/s either way. Real work
still holds sleep through its power request, which the board checks on its
own.

Monitors go back on before the PC sleeps or hibernates. A monitor powered off
over DDC/CI stays off after the wake until PcHwCtl's user-session agent is
back, 20-30 s into the sign-in screen. So for every sleep or hibernate the
helper asks PcHwCtl to act 8 s later instead of 1.5 s, turns the monitors on in
the meantime (`display wake`, `display power all on`), and they come back with
the signal on the wake. The helper log shows `power: monitors on before sleep ->
ok in <n> ms`. Night mode can send its displays-off in the same second as the
sleep (nobody at the desk): the monitors-on runs after it, and a displays-off
that arrives while the sleep is pending is skipped (`mon: ... off skipped, PC
going to sleep`).

Hibernate happens when you leave home: the phone (OwnTracks, the weather
phone engine's location) goes from within 1 km of home to beyond it
(`NIGHT_LEAVE_KM`), at any hour, with Night auto on. A PC night mode put to
sleep is woken and hibernated; a PC that is on is hibernated only if nobody
used it for 5 min (`NIGHT_LEAVE_IDLE_S`), else a post says it was left on. A PC
that is off for another reason is left alone. It needs a home (`weather home`)
and a valid phone fix (12 h, `OWNTRACKS_MAX_AGE_S`). A hibernated PC stays so until it is powered
on. When the PC comes back the board sends its night state at once,
so the day config is back right after power-on. Night mode posts its own
sleep, wake and hibernate messages; for 3.5 min after each of its requests the
generic ones ("wake PC", "PC accepted hibernate", "PC is asleep or off", "PC is
on") are left out of Discord and Pushover.

## Power-on brownout

Some motherboards drag the USB 5 V rail down while the PC powers on from
shutdown: the board browns out and restarts (`boot: last reset: brownout` in
the log). Every wake therefore turns the backlights off while the WoL / USB
wake goes out and for 200 ms after it (`POWER_WAKE_DIM_MS` in settings.h). It
used to be a switch; it is always on since the brownout came back on
2026-10-27 (the author suspects capacitance on the motherboard bleeding off).
Seen on the author's board, both with Wake PC and with the PC's own power
button; waking from sleep is not affected.

It does not cover a power-on from the PC's own power button, which never goes
through the board. The real fix is a supply that the PC's power-on cannot pull
down. The ESP32 board's second USB port is not that supply: its 5 V in and out
are bridged, so feeding 5 V there while the PC's USB also powers the board would
damage it. What would work is an 18650 cell with a 5 V boost converter feeding
the board, plus some way to charge the cell; not worth it on the author's setup,
but an option if your board browns out on every power-on.

The same sag also flipped bits in PSRAM; what the firmware does about that
(PSRAM at 40 MHz with ECC, a second restart after a brownout boot) is in
[firmware.md](firmware.md#psram-hardening).
