lnminh1411/ESP32-PC-Control-System/docs/settings-reference.md

# Settings reference

Generated by `python scripts/settings_doc.py` from
[firmware/main/settings_or_example.h](../firmware/main/settings_or_example.h);
don't edit by hand. Each of these 206 keys can be overridden in `settings.h`.
The secrets are described in [settings.md](settings.md).

## Board pins (rev 3.1 carrier; scripts/check_pins.py checks them against pcb/main.ato)

| Key | Default | Note |
|---|---|---|
| `PIN_SCK` | `12` | panels' shared SCK, via 33R (FSPI IO_MUX pin) |
| `PIN_MOSI` | `11` | panels' shared MOSI, via 33R (FSPI IO_MUX pin) |
| `PIN_DC` | `9` | panels' shared DC |
| `PIN_CS_LIST` | `{8, 18, 17}` | CS of panels 1-3 |
| `PIN_RST_LIST` | `{10, 16, 15}` | RST of panels 1-3 |
| `PIN_BL_LIST` | `{3, 6, 5}` | backlight PWM of panels 1-3 |
| `PIN_DOOR_LIST` | `{39, 40, 41, 42}` | keyfob B1-B4 (opto rows 1-4) |
| `PIN_MOBO_RST` | `1` | motherboard RST header (opto row 5) |
| `PIN_LED` | `2` | status LED (PWM) |
| `ONBOARD_RGB_GPIO` | `48` | the module's own WS2812 (not on the carrier; YD-style boards need the "RGB" jumper bridged), held off |
| `UART_BAUD` | `3000000` | host UART (CH343): console |

## Panels

| Key | Default | Note |
|---|---|---|
| `N_PANELS` | `3` | ST7789 panels on the bus |
| `TFT_W` | `240` | panel width, px |
| `TFT_H` | `320` | panel height, px |
| `SPI_HZ` | `40000000` | shared SPI clock; 80 MHz gave blank panels on the carrier bus |
| `PANEL_MADCTL_LIST` | `{0, 0, 0}` | ST7789 MADCTL (rotation / RGB order) of panels 1-3 |
| `PANEL_INVERT_LIST` | `{true, true, true}` | colour inversion (IPS panels) of panels 1-3 |
| `PANEL_DEFAULT_VIEW_LIST` | `{VIEW_METRICS, VIEW_METRICS, VIEW_METRICS}` | view of panels 1-3 until one is saved (enum View, display.h) |

## Status LED

| Key | Default | Note |
|---|---|---|
| `LED_DUTY_CEIL` | `0.35f` | green LED glares above ~35 % duty; brightness 100 maps here |
| `LED_GAMMA` | `2.2f` | brightness % is perceptual, not linear duty |

## Status LED patterns

| Key | Default | Note |
|---|---|---|
| `LED_RESTART_BLINK_MS` | `400` | PC restarting / updating: blink period (half on) |
| `LED_LOADING_BLINK_MS` | `200` | board booting / stats not fresh: blink period (half on) |
| `LED_BREATHE_MS` | `3000` | PC asleep / off: breathing period |

## Door keyfob and PC reset (optos)

| Key | Default | Note |
|---|---|---|
| `DOOR_PRESS_MS` | `500` | keyfob button press length |
| `DOOR_GAP_MS` | `500` | gap between two presses |
| `MOBO_RST_MS` | `200` | PC reset pulse length |

## PC power state

| Key | Default | Note |
|---|---|---|
| `USB_GUARD_MS` | `30000` | after the USB link comes up, suspends are ignored this long |
| `POWER_ACK_TIMEOUT_MS` | `3000` | wait for the PC helper's power.ack |
| `POWER_WAKE_DIM_MS` | `200` | backlights off this long while the PC powers on (its inrush browns out the board) |

## Network

| Key | Default | Note |
|---|---|---|
| `NET_HOSTNAME` | `"esp32-pc-control"` | Wi-Fi hostname, mDNS name (<name>.local), Discord device name |
| `NET_NTP_SERVER` | `"pool.ntp.org"` | SNTP server |
| `NET_WIFI_PS` | `WIFI_PS_NONE` | Wi-Fi modem power save (esp_wifi_set_ps) |
| `NET_WIFI_TX_DBM` | `8` | Wi-Fi transmit power cap, dBm (2-20); the router sits ~30 cm away, less TX current on the board's supply |

## Wake-on-LAN

| Key | Default | Note |
|---|---|---|
| `WOL_PORT` | `9` | magic packet UDP port |
| `WOL_PORT_ALT` | `7` | second UDP port for the subnet broadcast |
| `WOL_BURSTS` | `3` | magic packet rounds per wake |
| `WOL_BURST_GAP_MS` | `100` | gap between rounds |

## PC stats link

| Key | Default | Note |
|---|---|---|
| `PCSTATS_FRESH_MS` | `3000` | a sample newer than this counts as "PC helper talking" |
| `PCSTATS_STALE_MS` | `5000` | values older than this read as missing (NAN / "") |
| `CONTROL_PANEL_REFRESH_MS` | `5000` | #control panel: edited this often while live (below), when something on it changed |
| `CONTROL_PANEL_LIVE_MS` | `(3 * 60 * 1000)` | live this long after any interaction with the bot; else every 10 min |
| `CONTROL_PANEL_CONFIRM_MS` | `60000` | a confirm button on the panel is left alone this long (no refresh edits) |

## PC warnings (pcwarn.cpp; `pcwarn set` overrides per metric in NVS)

| Key | Default | Note |
|---|---|---|
| `PCWARN_AVG_MS` | `2000` | averaging window before a level triggers |
| `PCWARN_RAM_LOAD_HIGH` | `80.0f` | RAM load %, yellow |
| `PCWARN_RAM_LOAD_CRIT` | `90.0f` | RAM load %, red |
| `PCWARN_CPU_LOAD_HIGH` | `90.0f` | CPU load %, yellow |
| `PCWARN_GPU1_LOAD_HIGH` | `90.0f` | GPU1 (RX 6600) load %, yellow |
| `PCWARN_GPU2_LOAD_HIGH` | `90.0f` | GPU2 (RTX 3050) load %, yellow |
| `PCWARN_GPU1_VRAM_HIGH` | `90.0f` | GPU1 VRAM used %, yellow |
| `PCWARN_CPU_TEMP_CRIT` | `80.0f` | CPU temp C, red |
| `PCWARN_GPU1_TEMP_CRIT` | `80.0f` | GPU1 temp C, red |
| `PCWARN_GPU2_TEMP_CRIT` | `75.0f` | GPU2 temp C, red |
| `PCWARN_RAM_TEMP_CRIT` | `75.0f` | DIMM temp C, red |
| `PCWARN_VRM_TEMP_CRIT` | `75.0f` | VRM temp C, red |

## PC hardware shown on the board

| Key | Default | Note |
|---|---|---|
| `PC_GPU1_LABEL` | `"RX 6600"` | GPU card 1 (stat keys gpu1_*: stats.ini maps them to a sensor) |
| `PC_GPU2_LABEL` | `"RTX 3050"` | GPU card 2 (gpu2_*) |
| `PC_DRIVE_LABEL` | `"C:"` | drive card (c_used / c_total) |
| `PC_DRIVE_WARN_PCT` | `85.0` | drive used %, yellow |
| `PC_DRIVE_BAD_PCT` | `95.0` | drive used %, red |
| `LOCAL_AI_MODEL_NAME` | `"Occamy-1.0"` | local model name on the Local AI face |
| `LOCAL_AI_MODEL_FULL` | `"Occamy-1.0 35B-A3B"` | the same, full, on the working face |

## PC case RGB and fans (PcHwCtl names, Discord RGB / Fan tabs)

| Key | Default | Note |
|---|---|---|
| `HW_RGB_GROUPS` | `{"all", "All"}, {"main", "Motherboard"}, {"ram", "RAM"}` | PcHwCtl RGB groups: {name, label}, ... |
| `HW_FAN_TARGETS` | `{"all", "All fans"}, {"case", "Case fans"}, {"cpu-fans", "CPU fans"}, {"rear-fan", "Rear fan"}, {"front-fans", "Front fans"}, {"gpu-amd", "RX 6600 fan"}, {"gpu-nvidia", "RTX 3050 fan"}` | fan targets {PcHwCtl key, label}; "all" and "case" are PcHwCtl's / the board's groups, gpu-* get a Zero RPM menu |
| `HW_FAN_CASE_KEYS` | `"cpu-fans", "rear-fan", "front-fans"` | what "case" means: one command per key |
| `HW_FAN_SHOWN` | `{"cpu_fans", "CPU fans"}, {"rear_fan", "Rear fan"}, {"front_fans", "Front fans"}, {"water_pump", "Water pump"}, {"gpu_amd", "RX 6600"}, {"gpu_nvidia", "RTX 3050"}` | Fan tab embed rows {state.txt key (_ for -), label} |
| `HW_FAN_HOLD_MIN` | `5, 15, 60` | hold times a manual fan speed cycles through, min |

## Local AI (LocalAIHost)

| Key | Default | Note |
|---|---|---|
| `LOCAL_AI_IDLE_MIN` | `20` | auto-unload minutes the Local Agent tab restores after "off" |

## Quota faces (Claude, Antigravity)

| Key | Default | Note |
|---|---|---|
| `QUOTA_SESSION_WARN_PCT` | `75.0` | 5 h window used %, yellow |
| `QUOTA_SESSION_BAD_PCT` | `90.0` | 5 h window used %, red |
| `QUOTA_WEEKLY_WARN_PCT` | `80.0` | weekly used %, yellow |
| `QUOTA_WEEKLY_BAD_PCT` | `95.0` | weekly used %, red |

## Screens and frame rate

| Key | Default | Note |
|---|---|---|
| `SCREEN_MARQUEE_PX_S` | `30.0f` | media title scroll speed, px/s |
| `SCREEN_MARQUEE_PAUSE_S` | `1.5f` | pause at each end of the title |
| `VIEW_BUS_BUDGET_PCT` | `95` | share of the SPI bus the panels may use (`fps budget` changes it) |
| `VIEW_MIN_FRAME_MS` | `50` | canvas faces: at most 20 fps |
| `VIEW_GIF_MIN_FRAME_MS` | `16` | GIF face: at most ~60 fps (GIF frame times still apply) |
| `GIF_SWITCH_S` | `30` | firmware/gifs/gifs.json with several GIFs: each loops this long, in random order, no GIF twice in a row |
| `VIEW_METRICS_PAGE_MS` | `5000` | metrics face pages through overflow cards this often |

## PC shutdown / restart announcements (pc_going.cpp)

| Key | Default | Note |
|---|---|---|
| `PCGOING_PREOFF_MS` | `(120 * 1000)` | after "restart/shut down" is announced, wait this long for the PC to go off |
| `PCGOING_PREOFF_UPDATE_MS` | `(60 * 60 * 1000)` | same, for an update restart / shutdown |
| `PCGOING_BACK_MS` | `(10 * 60 * 1000)` | after it went off, screens wait this long for it to come back |
| `PCGOING_BACK_UPDATE_MS` | `(2 * 60 * 60 * 1000)` | same, for an update restart (several reboots) |

## Night mode (board side; night.cpp)

| Key | Default | Note |
|---|---|---|
| `NIGHT_START_HOUR` | `22` | local hour the night window opens |
| `NIGHT_END_HOUR` | `6` | local hour it closes |
| `MON_DIM_ENABLED` | `1` | PC monitors dim in the evening, back up at NIGHT_END_HOUR (0 = off) |
| `MON_DIM_START_HOUR` | `21` | local hour the evening dim starts |
| `MON_DIM_STEP_PCT` | `1` | brightness points off each monitor every minute, down to 0 |
| `MON_MORNING_PCT` | `20` | brightness of every monitor at NIGHT_END_HOUR, once a day |
| `NIGHT_IDLE_ENGAGE_S` | `(5 * 60)` | s without keyboard/mouse input on the PC before it engages in the window |
| `NIGHT_PANEL_PCT` | `10` | board panel backlight % while engaged |
| `NIGHT_STATUS_LED_PCT` | `20` | status LED cap % while engaged |
| `NIGHT_RGB_PCT` | `10` | PC case RGB % while engaged (PcHwCtl) |
| `NIGHT_GUARD_MS` | `10000` | input during the night only ends it if this window shows a real return: |
| `NIGHT_GUARD_PX` | `50` | mouse moved more than this many px, |
| `NIGHT_GUARD_PRESSES` | `3` | or this many key / button presses |
| `NIGHT_LASSO_REPEAT_MS` | `30000` | !night state resent to the PC this often (Process Lasso profile) |
| `NIGHT_SLEEP_S` | `(60 * 60)` | s without real input on the PC (false wakes don't count) before night mode sleeps it |
| `NIGHT_LEAVE_KM` | `1.0` | the phone (OwnTracks) going beyond this from home hibernates the PC (woken first if night mode put it to sleep) |
| `NIGHT_LEAVE_IDLE_S` | `(5 * 60)` | ...but a PC that is on only if nobody used it for this long |
| `NIGHT_NET_HOLD_BPS` | `1000000` | sleep / hibernate wait while net_down or net_up averages more than this (bytes/s, ~1 min) |
| `NIGHT_REQ_IGNORE` | `"claude.exe"` | power request holders that don't hold sleep (comma list; claude.exe always holds EXECUTION) |

## Presence at the desk (presence.cpp; camera check in PcHwCtl)

| Key | Default | Note |
|---|---|---|
| `PRESENCE_FAST_S` | `10` | s between checks while you are away and around the night's start |
| `PRESENCE_DAY_S` | `10` | s between checks otherwise |
| `PRESENCE_BACK_S` | `2` | ...and while the desk rule has the displays off, to give them back (PcHwCtl's presence.minIntervalS must allow it) |
| `PRESENCE_AWAY_KM` | `0.20` | phone beyond this from home = you are away |
| `PRESENCE_HOME_KM` | `0.18` | ...and back only under this (a margin: no flapping at the line) |
| `PRESENCE_ACC_M` | `150` | a fix vaguer than this (m) doesn't switch away / back |
| `PRESENCE_FIX_FRESH_S` | `120` | someone at the desk with a fix older than this: ask the phone before alerting |
| `PRESENCE_ASK_WAIT_S` | `30` | ...and alert anyway after this long without an answer |
| `PRESENCE_USE_S` | `30` | away: someone seen alerts only with input on the PC this recent (s) |
| `PRESENCE_ALERT_REPEAT_S` | `(10 * 60)` | alert again this often while someone stays at the desk |
| `PRESENCE_DAY_OFF_S` | `0` | by day: nobody seen this long = displays off (Windows), AFK faces; 0 = at the first check |
| `PRESENCE_DAY_IDLE_S` | `10` | ...and no input this long (someone typing is in the chair, whatever the camera says) |
| `PRESENCE_DAY_LOW_S` | `(5 * 60)` | ...and low power mode (PC only) after nobody this long: each switch moves every process |
| `PRESENCE_AWAY_IDLE_S` | `(5 * 60)` | input while away gives the displays back until this long without input |
| `NIGHT_DESK_HOLD_S` | `(30 * 60)` | someone at the desk past the idle timer holds the night off this long |
| `NIGHT_GUARD_VETO_MS` | `120000` | the camera can overrule real input once this often (a dim room can miss you) |
| `PUSHOVER_EMERGENCY_RETRY_S` | `60` | emergency priority: Pushover repeats the alert this often (minimum 30) |
| `PUSHOVER_EMERGENCY_EXPIRE_S` | `3600` | ...for this long, or until acknowledged |

## Weather (board)

| Key | Default | Note |
|---|---|---|
| `WEATHER_HOME_NAME` | `"Home"` | place name until WEATHER_HOME or `weather home` gives one |
| `WEATHER_RAIN_URGENT_MIN` | `20` | rain ETA at or under this: red banner / red Discord post |
| `WEATHER_ALERT_PRIO` | `1` | Pushover priority of weather warnings (rain, typhoon, OpenWeather alerts); 1 = high, rings through quiet hours |
| `WEATHER_RAIN_SURE_MIN` | `30` | rain one source alone sees: a warning at this ETA or closer (else a quiet watch) |
| `WEATHER_OM_RADAR_KM` | `20` | Open-Meteo alone warns only with a radar echo within 5 km, or moving in within this; else a watch |
| `WEATHER_RAIN_SURE_MMH` | `2.0f` | ...or at this mm/h and up, whatever the other source says |
| `OWM_RAIN_SOLID_MMH` | `0.8f` | OpenWeather alone: needs this peak mm/h... |
| `OWM_RAIN_SOLID_MIN` | `3` | ...or this many rain minutes in a row to be more than a watch |
| `WEATHER_SHOWER_MIN` | `20` | a shower usually lasts this many minutes... |
| `WEATHER_SHOWER_MAX` | `60` | ...to this many (shown when no source has an end) |
| `WEATHER_TSTORM_MIN` | `30` | a thunderstorm's rain: this many minutes... |
| `WEATHER_TSTORM_MAX` | `90` | ...to this many |
| `WEATHER_UPWIND_POLL_MS` | `(10 * 60 * 1000)` | upwind probe (8 Open-Meteo calls) this often while rain is coming or falling at home |
| `WEATHER_TYPHOON_NEAR_S` | `(6 * 3600)` | a typhoon arriving within this shows on the screens and gets per-minute posts |
| `WEATHER_AQI_MODERATE` | `50` | air quality index above this: Moderate |
| `WEATHER_AQI_HIGH` | `100` | above this: High |
| `WEATHER_AQI_DANGEROUS` | `200` | above this: Dangerous |
| `WEATHER_TYPHOON_IMMINENT_S` | `(20 * 60)` | under this: typhoon posts turn red |
| `WEATHER_STORM_GUST_KMH` | `62` | forecast gust at or over this (km/h, Beaufort 8) makes the hour a storm |
| `WEATHER_LIGHT_RAIN_MMH` | `0.5f` | rain under this mm/h is drizzle (its own tier, warned like the rest) |
| `WEATHER_HEAVY_SHOWER_MMH` | `7.6f` | rain at or over this mm/h is a heavy shower |
| `WEATHER_SUMMARY_FIRST_HOUR` | `4` | two-hourly #weather summary from this hour... |
| `WEATHER_SUMMARY_LAST_HOUR` | `20` | ...to this one (even hours) |
| `WEATHER_MORNING_HOUR` | `4` | the 3-day forecast post goes out at this hour |
| `WEATHER_FORECAST_POLL_MS` | `(15 * 60 * 1000)` | Open-Meteo forecast poll (its data changes hourly) |
| `WEATHER_AQI_POLL_MS` | `(30 * 60 * 1000)` | air quality poll |
| `WEATHER_CYCLONE_POLL_MS` | `(30 * 60 * 1000)` | GDACS cyclone list poll |

## Rain nowcast (Open-Meteo 15-min grid, nowcast.cpp)

| Key | Default | Note |
|---|---|---|
| `NOWCAST_RING1_KM` | `10.0f` | inner sample ring radius |
| `NOWCAST_RING2_KM` | `25.0f` | outer sample ring radius |
| `NOWCAST_RAIN_MMH` | `0.3f` | over this mm/h counts as rain (drizzle too: Open-Meteo's smallest step, 0.1 mm per 15 min, is 0.4 mm/h) |
| `NOWCAST_RAIN_END_MMH` | `0.1f` | rain ends under this (hysteresis) |
| `NOWCAST_ALERT_ETA_MIN` | `60` | warn when rain arrives within this |
| `NOWCAST_POLL_RAIN_MS` | `(5 * 60 * 1000)` | poll while warned or raining |
| `NOWCAST_POLL_NEAR_MS` | `(10 * 60 * 1000)` | poll while rain is in the grid |
| `NOWCAST_POLL_DRY_MS` | `(30 * 60 * 1000)` | poll while the grid is dry (hourly model data underneath) |

## OpenWeather One Call 4.0 (owm.cpp; key: OWM_API_KEY)

| Key | Default | Note |
|---|---|---|
| `OWM_CALLS_PER_DAY` | `960` | daily call budget (set the account's own cap to 1000) |
| `OWM_RAIN_MMH` | `0.3f` | minutely precipitation over this counts as rain (drizzle too) |
| `OWM_POLL_RAIN_MS` | `(90 * 1000)` | poll while warned, raining or under an alert |
| `OWM_POLL_MS` | `(120 * 1000)` | poll otherwise |

## Tomorrow.io (tomorrow.cpp; key: TOMORROW_API_KEY)

| Key | Default | Note |
|---|---|---|
| `TOMORROW_CALLS_PER_DAY` | `480` | daily call budget (free tier: 500, and 25 an hour; the board stops at 20) |
| `TOMORROW_RAIN_MMH` | `0.3f` | minutely precipitation over this counts as rain |
| `TOMORROW_POLL_RAIN_MS` | `(3 * 60 * 1000)` | poll while rain is warned, watched, falling or an echo is within 30 km |
| `TOMORROW_POLL_MS` | `(6 * 60 * 1000)` | poll otherwise |

## RainViewer radar (radar.cpp; free, no key)

| Key | Default | Note |
|---|---|---|
| `RADAR_ENABLED` | `1` | 0 = off |
| `RADAR_RAIN_DBZ` | `15` | echo this strong counts as rain (15 dBZ ~ 0.3 mm/h) |
| `RADAR_HERE_KM` | `2.5f` | "at the place": within this radius... |
| `RADAR_HERE_MIN_PX` | `3` | ...on this many pixels (~1.1 km each), not one stray |
| `RADAR_MAX_AGE_S` | `(25 * 60)` | a frame older than this says nothing (they come ~10 min late) |
| `RADAR_POLL_MS` | `(5 * 60 * 1000)` | poll while an echo is within 30 km or rain is warned |
| `RADAR_POLL_DRY_MS` | `(10 * 60 * 1000)` | poll otherwise (a new frame every 10 min) |

## Tropical cyclones (GDACS, cyclone.cpp)

| Key | Default | Note |
|---|---|---|
| `CYCLONE_HOME_KM` | `300.0f` | centre within this distance = "at home" |
| `CYCLONE_FETCH_KM` | `3000.0f` | storms further away are not fetched |

## Phone location (OwnTracks over MQTT; broker in MQTT_URI)

| Key | Default | Note |
|---|---|---|
| `OWNTRACKS_MAX_AGE_S` | `(12 * 3600)` | a fix older than this is ignored (the phone reports on movement: silence = same place) |
| `OWNTRACKS_ASK_AFTER_S` | `(2 * 60 * 60)` | no fix for this long: ask the phone (OwnTracks reportLocation), again as often |
| `OWNTRACKS_HOME_KM` | `1.0` | phone within this of home = at home (one weather engine) |
| `OWNTRACKS_AWAY_KM` | `1.5` | ...and away only past this (a margin: no flapping at the line) |
| `OWNTRACKS_SWITCH_ACC_M` | `500` | a fix vaguer than this (m) doesn't switch home / away |

## PC helper (ESP32-Helper.exe; build.cmd turns HOST_* into C#, the sensor map stays in stats.ini)

| Key | Default | Note |
|---|---|---|
| `HOST_LASSO_INI` | `"C:\\ProgramData\\ProcessLasso\\config\\prolasso.ini"` | Process Lasso config the night profile rewrites (original kept as .esp32-night) |
| `HOST_NIGHT_CORES` | `"14-17"` | cores night mode pins processes to, in efficiency mode (Core Ultra 7 265K E-cores are 2-5, 10-17) |
| `HOST_NIGHT_KEEP` | `"system,idle,registry,secure system,memory compression,smss,csrss,wininit,winlogon,services,lsass,lsaiso,fontdrvhost,dwm,audiodg,explorer,sihost,ctfmon,textinputhost,searchhost,startmenuexperiencehost,shellexperiencehost,logonui,lockapp,esp32-helper,pchwctl,localaihost,llama-server,processgovernor,processlasso,bitsumsessionagent,msmpeng,mpdefendercoreservice"` | processes night mode never pins (comma list) |
| `HOST_NIGHT_NO_WORD_MIN` | `5` | no !night from the board this long: the Process Lasso config goes back |
| `HOST_NIGHT_HEAVY_CORES` | `0.8` | an exe averaging this many cores (1.0 = one core, summed over instances) ... |
| `HOST_NIGHT_HEAVY_S` | `120` | ... for this long is heavy: night mode leaves it unpinned, and the board won't sleep the PC |
| `HOST_NIGHT_CALM_CORES` | `0.3` | a heavy exe averaging less than this ... |
| `HOST_NIGHT_CALM_S` | `300` | ... for this long is calm again (pinned again at night) |
| `HOST_NIGHT_ALWAYS` | `""` | exes night mode keeps pinned even while heavy (comma list, e.g. searchindexer,tiworker); they still hold sleep |
| `HOST_NIGHT_HEAVY_IGNORE` | `"svchost,msmpeng,pchwctl,msedgewebview2"` | heavy exes that don't hold sleep (comma list): service hosts summed over dozens of instances never calm down, PcHwCtl (its camera checks) and WebView2 hosts are always busy; real work holds through a power request |
| `HOST_HWCTL_PIPE` | `"PcHwCtl"` | named pipe of the RGB / fan service (!hw) |
| `HOST_HWCTL_TIMEOUT_MS` | `2000` | its reply timeout |
| `HOST_LOCALAI_PIPE` | `"LocalAIHost"` | named pipe of the local model service (!ai) |
| `HOST_LOCALAI_TIMEOUT_MS` | `20000` | its reply timeout (a forced unload takes ~8 s) |
| `HOST_NIC_SKIP` | `"hyper-v,virtualbox,vmware,tap-,loopback,bluetooth,wan miniport"` | adapters whose description contains one of these are not the PC's MAC for Wake-on-LAN |
| `HOST_LHM_CPU` | `true` | LibreHardwareMonitor hardware groups to open |
| `HOST_LHM_GPU` | `true` | (as above) |
| `HOST_LHM_MEMORY` | `true` | (as above) |
| `HOST_LHM_MOTHERBOARD` | `true` | (as above) |
| `HOST_LHM_STORAGE` | `true` | (as above) |
| `HOST_LHM_NETWORK` | `true` | (as above) |
| `HOST_LHM_CONTROLLER` | `true` | (as above) |
| `HOST_LHM_PSU` | `true` | (as above) |
| `HOST_LHM_BATTERY` | `true` | (as above) |
| `HOST_FONT_REGULAR` | `"ComicShannsMonoNerdFontPropo-Regular.otf"` | font file for text the board can't draw (Windows or per-user Fonts folder) |
| `HOST_FONT_BOLD` | `"ComicShannsMonoNerdFontPropo-Bold.otf"` | (as above) |
| `HOST_FONT_FALLBACK` | `"Segoe UI"` | family when those files are missing |
| `HOST_MON_POLL_MS` | `5000` | monitor DDC/CI state feed (mon.*) period |
| `HOST_MON_DDC_POWER_MODELS` | `"DELL E1715S"` | monitor models (DDC name, comma list) that also get DDC/CI power on/off; the rest only get Windows' display off |
| `HOST_MON_DDC_POWER_OFF` | `4` | VCP 0xD6 value for off on those (4 = DPM off: still answers DDC, wakes on input) |
