lnminh1411/ESP32-PC-Control-System/Scripts/Scripts.md

# Scripts

The `pcbnew` scripts run under KiCad's own bundled Python (has the `pcbnew` module; the system Python doesn't):
`"C:\Program Files\KiCad\10.0\bin\python.exe" <script>`. `make_fit_models.py` and `render_board.py` run under the system Python.

Every script finds the board relative to its own location (`ROOT` = the folder above `Scripts/`), so running the chain from a git worktree only touches that worktree's board, never the main checkout's.

Full rebuild (from the repo root; each step needs the previous one's output):

```bash
cd pcb && PYTHONIOENCODING=utf-8 ato build && cd ..
"C:\Program Files\KiCad\10.0\bin\python.exe" Scripts/make_blank_pcb.py
"C:\Program Files\KiCad\10.0\bin\python.exe" Scripts/sync_netlist_to_board.py
"C:\Program Files\KiCad\10.0\bin\python.exe" Scripts/layout_board.py
"C:\Program Files\KiCad\10.0\bin\python.exe" Scripts/add_pours.py
"C:\Program Files\KiCad\10.0\bin\python.exe" Scripts/route_spi.py
"C:\Program Files\KiCad\10.0\bin\python.exe" Scripts/route_board.py
"C:\Program Files\KiCad\10.0\bin\python.exe" Scripts/chamfer_corners.py
"C:\Program Files\KiCad\10.0\bin\python.exe" Scripts/check_spi_topology.py
"C:\Program Files\KiCad\10.0\bin\kicad-cli.exe" pcb drc --severity-all -o K:/scratch/drc.rpt pcb/layouts/default/default.kicad_pcb
python Scripts/render_board.py
```

## board_config.py

Shared build settings imported by the layout chain: `COPPER_LAYERS` (2 = rev 2.4b/3.0; 4 = the rev 2.4 stackup -- the rev 3 hand routes assume 2), `REVISION`, `DATE`, `TITLE`, and the Power net class values (`POWER_NETS`, track/via sizes -- keep equal to `pcb/layouts/default/default.kicad_pro`). Changing `COPPER_LAYERS` means rebuilding the whole chain from `make_blank_pcb.py`. Not run directly.

## make_blank_pcb.py

Creates a blank `pcb/layouts/default/default.kicad_pcb` with `board_config.COPPER_LAYERS` copper layers (4: inner planes named `GND_Plane`/`Power_Planes`; 2: F.Cu/B.Cu only) and the title block (revision/date/title from `board_config.py`). **Overwrites unconditionally** — only run once before the board exists, or deliberately to start the layout over. Never re-run after real placement/routing has begun.

## sync_netlist_to_board.py

Syncs `pcb/build/default.net` (from `ato build`) onto the real KiCad board file: loads/places every component's real footprint and assigns every pad to its correct net, using only `pcbnew`'s Python API — no GUI automation. Idempotent: re-running it keeps existing footprints' positions (only refreshes their net assignments) and grid-places any newly-added component in open space below whatever's already there. A component removed from `main.ato` is left on the board with a warning, not silently deleted. Run this after every `ato build` that changes `main.ato`'s parts or nets:

```bash
cd pcb && PYTHONIOENCODING=utf-8 ato build && cd ..
"C:\Program Files\KiCad\10.0\bin\python.exe" Scripts/sync_netlist_to_board.py
```

Custom footprints live in `pcb/footprints/ESP32PCC.pretty` (lib name `ESP32PCC` in `main.ato`); the script maps that lib via `LOCAL_LIBS`, everything else loads from KiCad's stock library. Part values (270R/10k/33R) are set from instance names via `INSTANCE_VALUES`, since atopile 0.2 drops `value` and merges identical classes' descriptions.

**Board references are derived from atopile instance names** (`REF_BY_INSTANCE` / `board_ref()`): `mcu.left`=J1, `mcu.right`=J2, `display1-3`=J3-J5, `rst_out`=J6, `keyfob`=J7, `boost`=PS1, `optoN`=UN, `rN`=RN, `led1`=D1. atopile's own refs are declaration-order U-numbers, so removing one part renumbered everything after it (and broke every ref-keyed placement/route downstream). A new instance with no mapping stops the script with an error -- add it to `REF_BY_INSTANCE`.

Exists because neither atopile's own `ato build` nor `kicad-cli` (KiCad's official CLI) nor `kicad_cli` (the third-party pierrechevalier83 GUI-automation tool) actually imports a netlist into a board file — atopile only produces the netlist text, `kicad-cli` has no import command, and `kicad_cli` only runs ERC/DRC on a project that already exists. This script is the missing piece.

## layout_board.py

Real (non-grid) component placement: positions every footprint from real measured geometry (courtyard bounding boxes read live via `pcbnew`, not assumed), fixes the axial resistor footprint's pad pitch to the real measured 8.128mm (stock library part is 10.16mm), handles footprint rotation for the right-angle edge-mounted connectors, places the rev-2.4 layout (module rotated 180° with USB-C at the top edge, boost/optos/axial resistors under the module, RST pair + keyfob + status LED on the west edge, the two 33R bus resistors in the top-right corner (MOSI's on the top row), display column 6.25 mm east of the module, 1x8 sockets at 51.9 mm pitch down the east edge), draws the L-shaped board outline (west RA sockets flush +0.4mm, display sockets overhanging the east edge 1mm with their silk clipped to the board, 0.3mm courtyard margin elsewhere, east strip for displays 2/3) and 4 mounting holes at fixed spots (collision-checked against courtyards, the module body and the L-shape), trims the resistor silkscreen to the shortened pitch, swaps the resistor 3D model to the stock P7.62mm STEP stretched in X to 8.128mm (a shifted P10.16 model left both leads outside their holes), adds per-pin silkscreen labels on every connector, and the assembly markings (module ANTENNA/USB-C ends + 3V3/GND pin 1s, resistor values inside the bodies, PC817 pin-1 dot replacing the notch). Rev 3.0: no west strip -- J6 (RST pair, west edge) and J7 (keyfob, turned 90 deg to face the bottom edge) plus R6/D1 sit below the module past the antenna keepout, J7's face sets the main body's bottom edge, J6's pin column sets the west edge (a 4.4 mm routing channel beside J2), mounting holes top-right + bottom-left. On 2 layers it also turns the optos 180 deg, arranges the resistor bank for planar drive/pull-down/anode lines (east column at XL+14.3) and widens the display strip. Never `fp.Remove()` footprint graphics here — it corrupts later footprints' SWIG wrappers; move items to another layer instead. Run after `sync_netlist_to_board.py`.

**Not idempotent in place** — re-running it on its own output corrupts other live `pcbnew` SWIG object references (same class of bug as the `NETINFO_ITEM` removal issue below). Always rebuild from a fresh blank+synced board first:

```bash
"C:\Program Files\KiCad\10.0\bin\python.exe" "E:\ESP32 PC Controller\Scripts\make_blank_pcb.py"
"C:\Program Files\KiCad\10.0\bin\python.exe" "E:\ESP32 PC Controller\Scripts\sync_netlist_to_board.py"
"C:\Program Files\KiCad\10.0\bin\python.exe" "E:\ESP32 PC Controller\Scripts\layout_board.py"
```

Full chain order: `make_blank_pcb` → `sync_netlist_to_board` → `layout_board` → `add_pours` → `route_spi` → `route_board` → `chamfer_corners` → `check_spi_topology` + `kicad-cli pcb drc` → `render_board`.

## add_pours.py

Pours the planes per `COPPER_LAYERS`: 4 layers -> GND on `In1` (net `gnd`) and 5V on `In2` (net `v5`); 2 layers -> one GND pour on `B.Cu` (0.3 mm pad clearance), 5V routed as a track. Also adds the antenna keepout rule area (all copper layers, no tracks/vias/fill) under the module's PCB antenna; it must exist before `route_board.py` so Freerouting routes around it. Since every component on this board is through-hole, THT pad copper already exists on every layer by default, so these two pours alone fully connect every GND/5V pad with zero explicit traces or vias. Run after `layout_board.py`.

## make_fit_models.py

Writes simple VRML fit-check models into `pcb/footprints/ESP32PCC.3dshapes/`: the BS01 boost on its 4 single male pins (referenced by the `Boost_CKCS_BS01` footprint) and an envelope of the plugged-in ESP32 DevKit at its real height on the sockets (attached to J2 by `layout_board.py`), so renders show what has to fit under the module. Prints the stack heights and clearance. Re-run after changing `BOOST_H`.

```bash
python "E:\ESP32 PC Controller\Scripts\make_fit_models.py"
```

## route_spi.py

Hand-routes the display nets (SCK, MOSI, DC, RST1, CS1-3, plus the two module-to-series-resistor risers) on F.Cu as **locked** tracks: shared lines as a true daisy chain MCU -> display1 -> display2 -> display3 (each segment ends on a pad, no T-junctions, no vias), CS1-3 and RST1 point-to-point, all in 8 lanes at 0.5mm pitch between J1 and the display column. RST2/RST3 are left to Freerouting on 4 layers; on 2 layers this script hand-routes **everything else too** (rev 3): RST2/RST3, BL1-3, display/boost 5V, the 12V collector bus inside the opto corridor, the opto outputs + 12V + LED drive down the west channel into J6/J7/R6/D1, and the resistor bank (GPIO drive, pull-downs, LED anodes) -- all F.Cu except 5 locked short B.Cu jumpers (via + 3.8-8 mm hop). Positions mirror `layout_board.py` constants; change both together. Routes are computed from placement constants (`XL`, `XR`, `XD`, `PITCH`, `C1`, `R33_X`/`R8_Y`/`R9_Y`) that must match `layout_board.py` -- change both together. Freerouting would build trees with mid-trace T-joins and drop most of the bus onto B.Cu. Run after `add_pours.py`, before `route_board.py`.

```bash
"C:\Program Files\KiCad\10.0\bin\python.exe" "E:\ESP32 PC Controller\Scripts\route_spi.py"
```

## chamfer_corners.py

Removes every 90-degree (and sharper) track corner on the board, hand-routed bus and Freerouting tracks alike: both legs are cut back 0.5mm and joined by a 45-degree diagonal. Each diagonal is collision-checked against other-net pads/tracks/vias (pcbnew shape `Collide`, 0.21mm) and halved down to 0.12mm if needed; corners on a pad/via are skipped. Freerouting's nm-long segments at bends are reused as the diagonal rather than deleted (`board.Remove()` corrupts the other SWIG wrappers, and a second `LoadBoard` in the same process fails too). Run after `route_board.py`.

```bash
"C:\Program Files\KiCad\10.0\bin\python.exe" "E:\ESP32 PC Controller\Scripts\chamfer_corners.py"
```

## check_spi_topology.py

Verifies the display bus after routing: F.Cu only, 0 vias, no node with 3+ track ends (T/star), and the chain order MCU -> display 1 -> 2 -> 3 per shared net (SCK, MOSI, DC; RST1 and CS1-3 point-to-point). Run after `route_board.py` or any manual edit to those nets.

## route_board.py

Auto-routes the remaining (low-speed) signal nets around the locked display bus (max 60 passes) with [Freerouting](https://github.com/freerouting/freerouting) (external tool — neither `kicad-cli` nor `pcbnew` include an autorouter; KiCad dropped its own years ago). Cached at `K:\cache\freerouting\freerouting-2.4.1.jar`, not committed to this repo. Pipeline: export Specctra DSN (`pcbnew.ExportSpecctraDSN`) → run Freerouting headless, restricted to `F.Cu`/`B.Cu` (the plane layers are marked non-routable); on 2 layers it runs **two passes** -- F.Cu only, lock the result, then F.Cu+B.Cu for whatever is left (Freerouting ignores per-layer costs in the DSN, so this is what keeps B.Cu to short jumpers; since rev 3 `route_spi.py` routes every net, so this is only a safety net -- Freerouting still prints a few phantom "unrouted" items, trust KiCad's DRC) → import the routed SES back (`pcbnew.ImportSpecctraSES`) → **re-fill the copper zones** (zones filled before routing don't know about the vias routing just added, which DRC catches as a zone/via clearance violation until re-filled).

**Only run against a fresh, unrouted board** (straight out of `add_pours.py`) — re-running it on a board it already routed left a net unrouted in practice (Freerouting tried to reuse existing traces as fixed obstacles and got stuck), where routing fresh hit 0 unrouted both times tried. To reroute after a layout change, rebuild the whole chain from `make_blank_pcb.py` again rather than routing on top of existing traces.

## render_board.py

Refreshes `pcb/build/renders/` (every image carries the board measurements in mm/cm/in, read from Edge.Cuts: the overall size as a caption, dimension lines for main body width/length, strip width and strip length below the main body on the 2D views, a caption box on the 3D view): one PNG per copper layer (F.Cu, In1 GND + In2 5V on 4-layer boards only, B.Cu), top silkscreen over F.Cu, and the slanted 3D overview (also copied to `pcb/build/board_preview.png`) via `kicad-cli` SVG export + pymupdf. Runs under the system Python (needs pymupdf + Pillow); intermediates go to `K:\scratch\pdf`. Run after the full routing chain + DRC pass.

```bash
python "E:\ESP32 PC Controller\Scripts\render_board.py"
```

## gif_stream.py

Streams a GIF to `firmware/s3_gif_stream_test` over the ESP32's USB-UART (3 Mbaud, default COM15) as raw big-endian RGB565: every original frame, scaled to fit 240x320, with a checksum per frame and resend on mismatch. The sketch draws each frame as it arrives, stores it in PSRAM, saves the set to its FAT partition (so it replays on every boot without the PC), then loops the whole GIF at its own frame timing (raw esp_lcd DMA push, ~15 ms/frame at 80 MHz); the script prints the device's FPS / push-time log for `--watch` seconds. Runs under the system Python (needs pyserial, numpy, Pillow).

```bash
python "E:\ESP32 PC Controller\Scripts\gif_stream.py" K:\scratch\neuro_source.gif --port COM15 --watch 15
```

## export_gerbers.py

Writes the fab package to `K:\artifacts\<TITLE>_rev<REVISION>_gerbers\` plus a `.zip` beside it (`TITLE`/`REVISION` from `board_config.py`): Gerbers for copper, mask, paste, silkscreen and Edge.Cuts, Excellon drills split PTH/NPTH with Gerber X2 drill maps, and the `.gbrjob`. Files are renamed from KiCad's `default-*` to `<TITLE>-*` (e.g. `ESP32_PC_Control_System-F_Cu.gtl`), with the `.gbrjob` file list and each Gerber's X2 project id rewritten to match. It plots the zone fill already stored in the board (the one DRC checked) and clears the output folder on every run. Runs under the system Python; run it after the routing chain + DRC pass.

```bash
python "E:\ESP32 PC Controller\Scripts\export_gerbers.py"
```
