lnminh1411/ESP32-PC-Control-System/diagrams/circuit_image.png

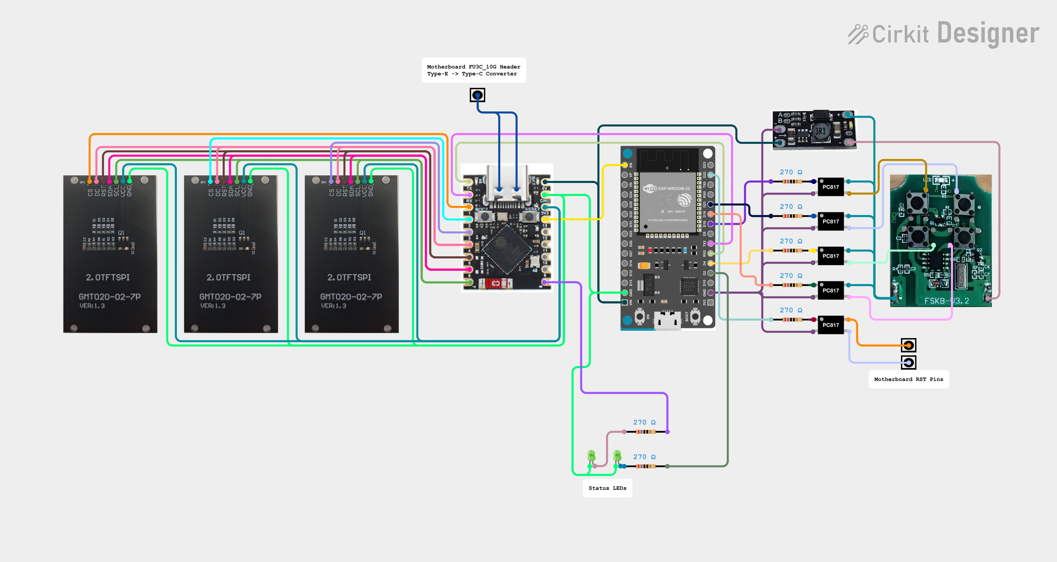
diagrams/circuit_image.png
