lnminh1411/ESP32-PC-Control-System/enclosure/renders/01_iso.png

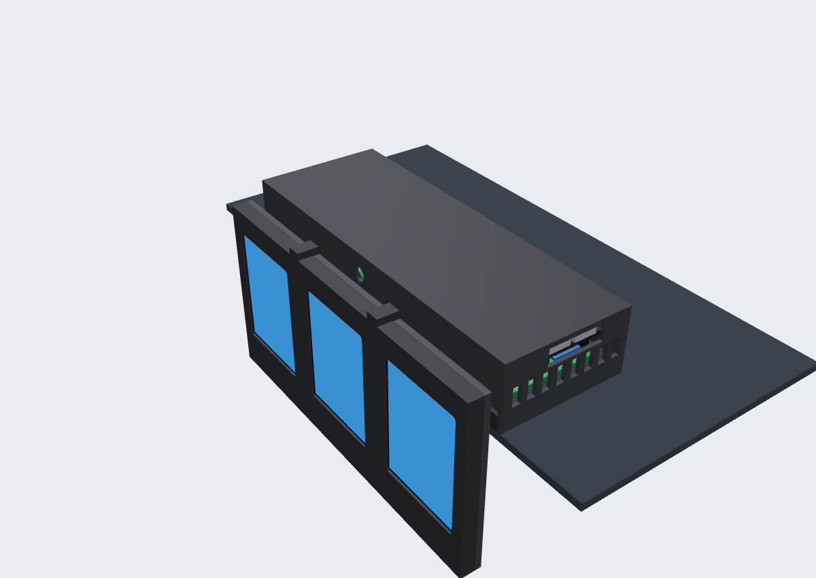
enclosure/renders/01_iso.png
