lnminh1411/ESP32-PC-Control-System/enclosure/renders/02_exploded.png

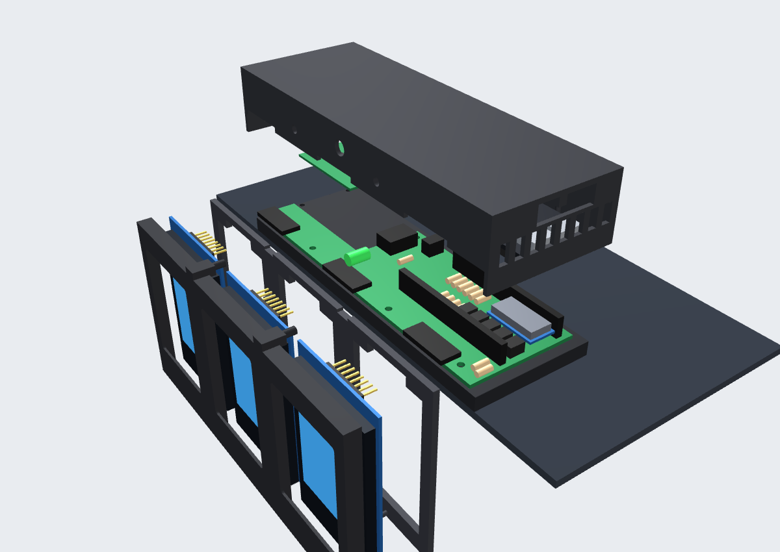
enclosure/renders/02_exploded.png
