lnminh1411/ESP32-PC-Control-System/enclosure/renders/03_glass_side.png

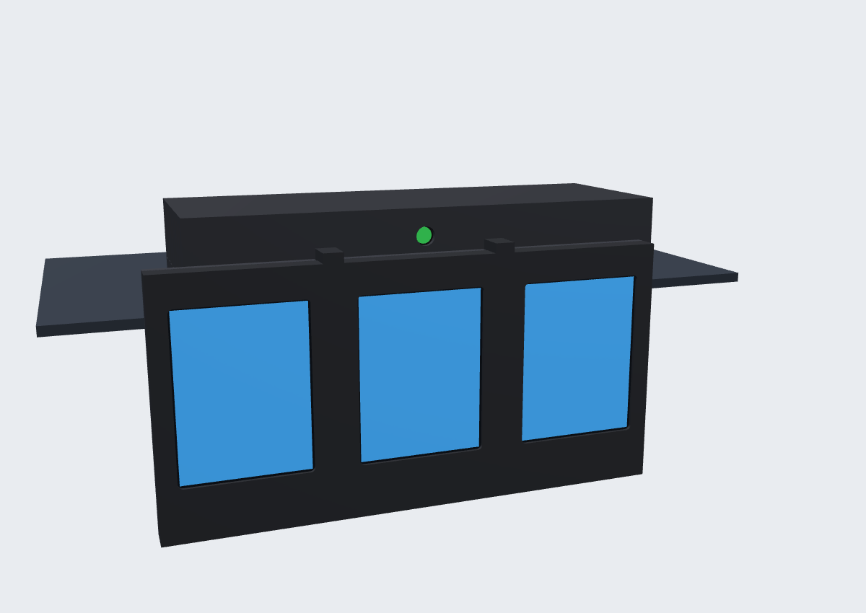
enclosure/renders/03_glass_side.png
