lnminh1411/ESP32-PC-Control-System/enclosure/renders/04_top.png

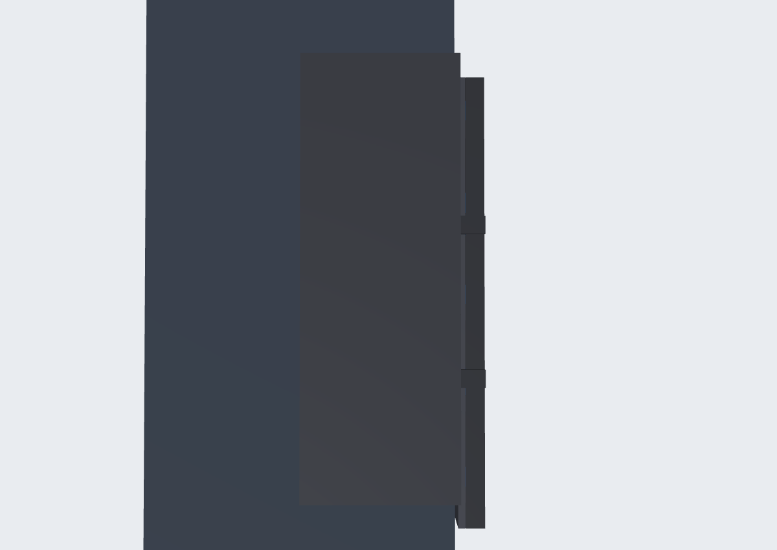
enclosure/renders/04_top.png
