lnminh1411/ESP32-PC-Control-System/enclosure/renders/05_lid_seethrough.png

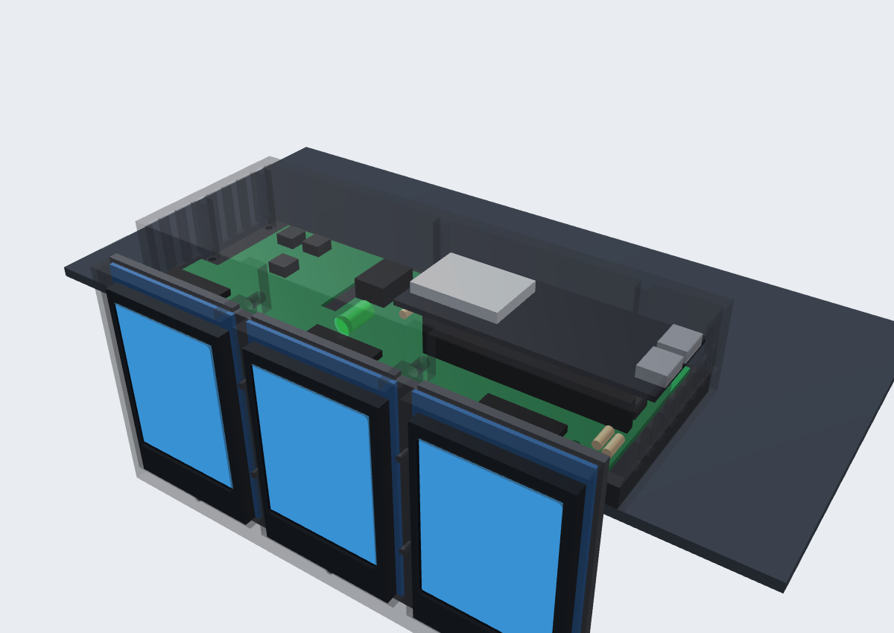
enclosure/renders/05_lid_seethrough.png
