lnminh1411/ESP32-PC-Control-System/enclosure/renders/06_block_only.png

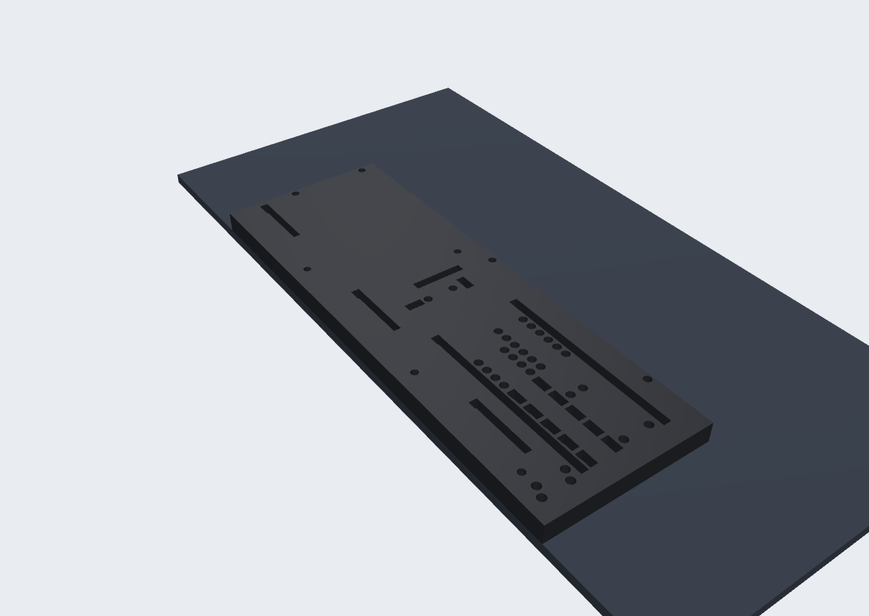
enclosure/renders/06_block_only.png
