lnminh1411/ESP32-PC-Control-System/enclosure/renders/08_usb_end.png

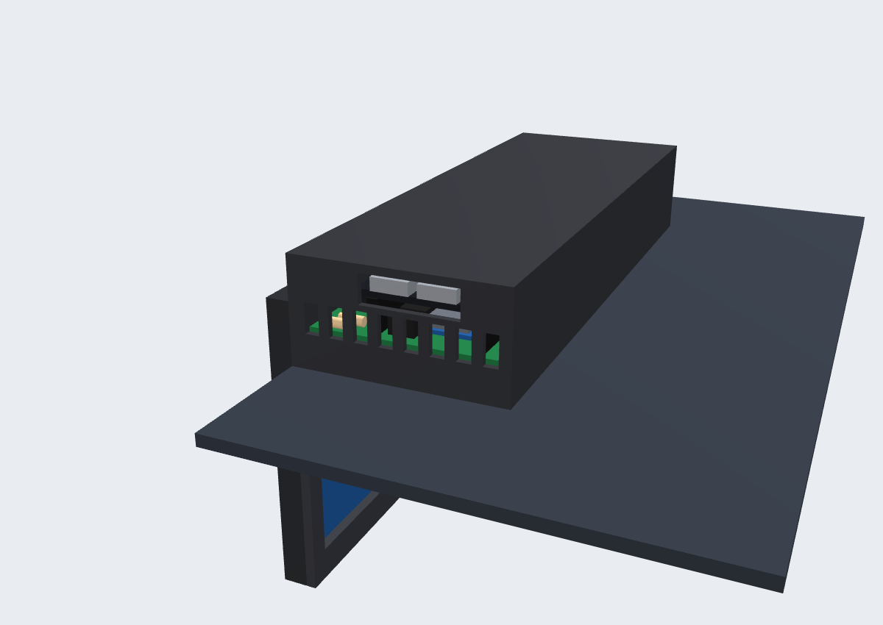
enclosure/renders/08_usb_end.png
