lnminh1411/ESP32-PC-Control-System/enclosure/renders/09_led_closeup.png

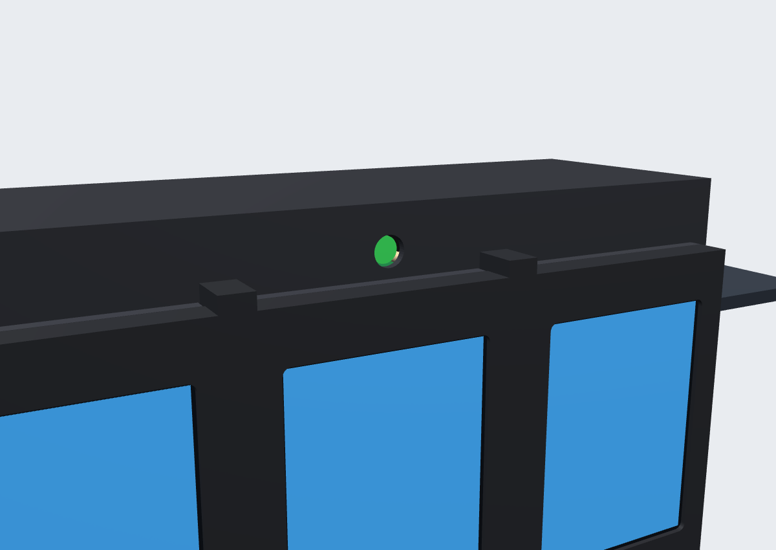
enclosure/renders/09_led_closeup.png
