lnminh1411/ESP32-PC-Control-System/enclosure/renders/10_mask_back.png

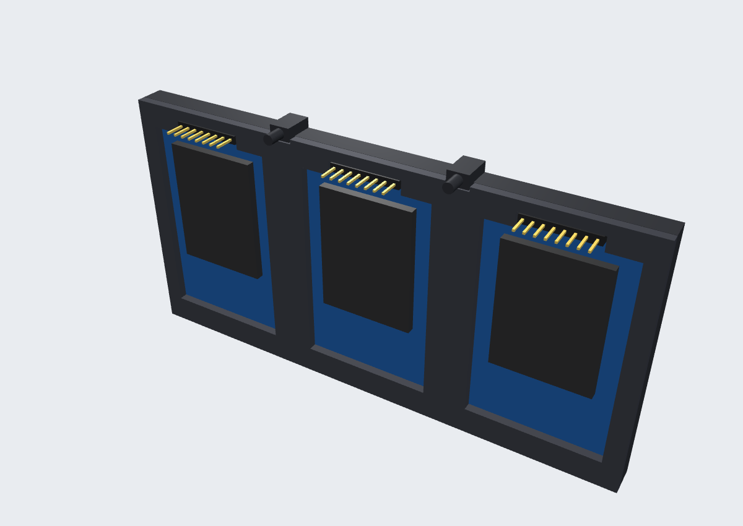
enclosure/renders/10_mask_back.png
