lnminh1411/ESP32-PC-Control-System/enclosure/renders/11_lid_underside.png

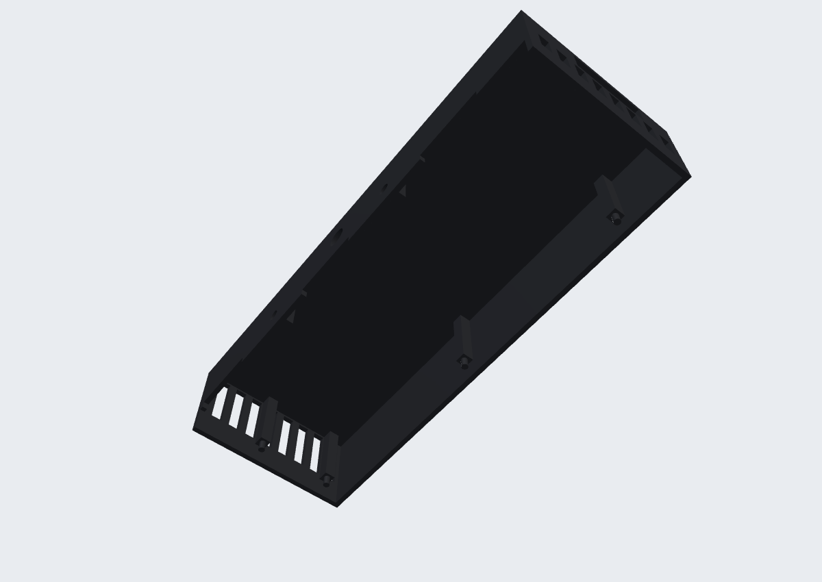
enclosure/renders/11_lid_underside.png
