lnminh1411/ESP32-PC-Control-System/enclosure/renders/12_top_open.png

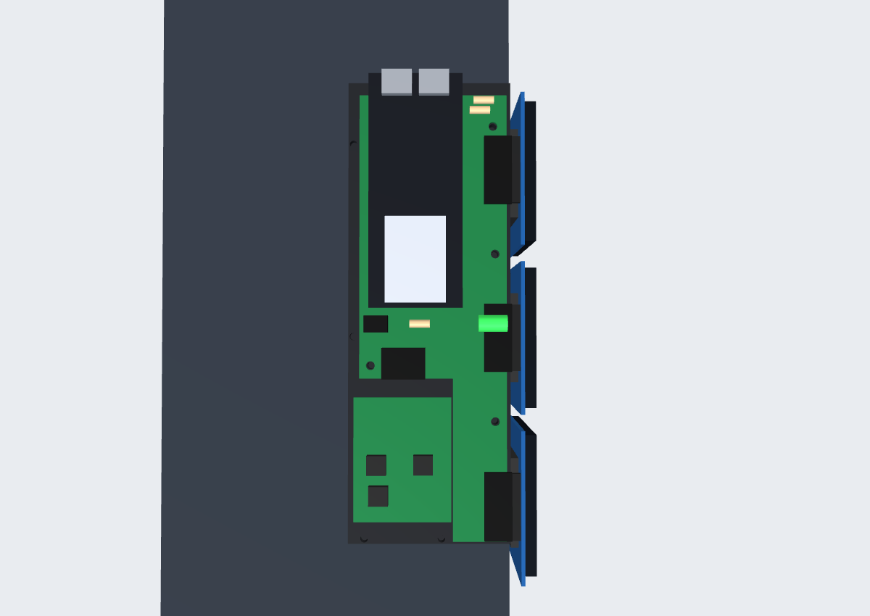
enclosure/renders/12_top_open.png
