lnminh1411/ESP32-PC-Control-System/enclosure/renders/13_screen_stack.png

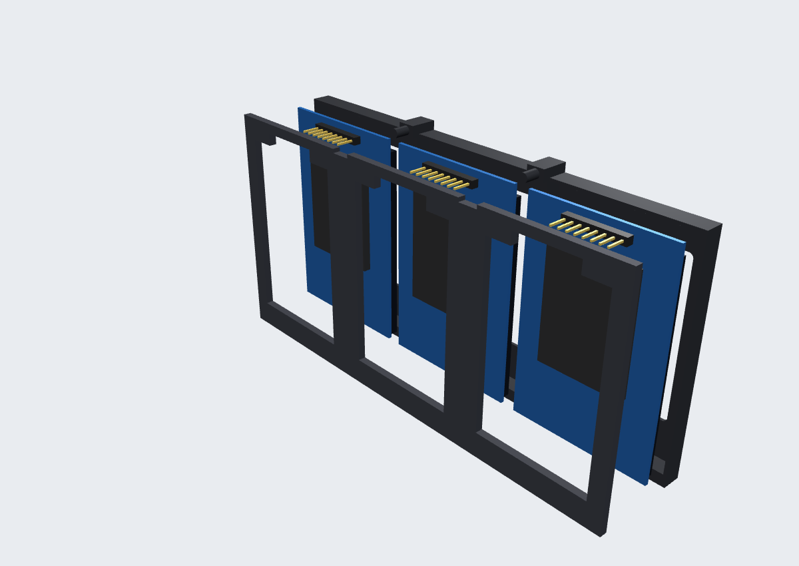
enclosure/renders/13_screen_stack.png
