lnminh1411/ESP32-PC-Control-System/firmware/gifs/bocchi.gif

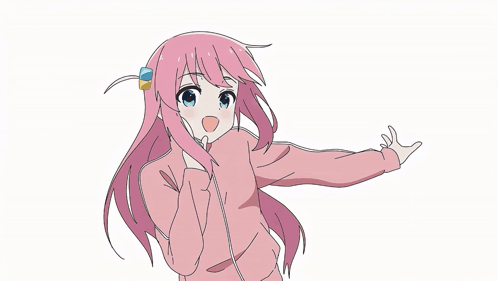
firmware/gifs/bocchi.gif
