lnminh1411/ESP32-PC-Control-System/firmware/gifs/bocchi_20fps.gif

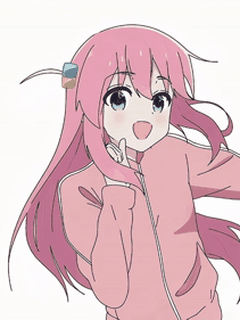
firmware/gifs/bocchi_20fps.gif
