lnminh1411/ESP32-PC-Control-System/firmware/gifs/evil_neuro.gif

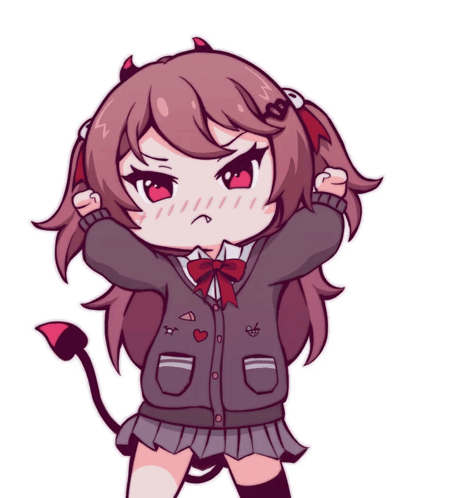
firmware/gifs/evil_neuro.gif
