lnminh1411/ESP32-PC-Control-System/firmware/gifs/filian.gif

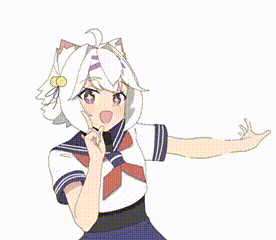
firmware/gifs/filian.gif
