lnminh1411/ESP32-PC-Control-System/firmware/gifs/filian_20fps.gif

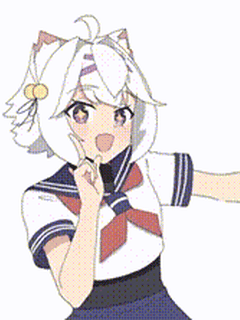
firmware/gifs/filian_20fps.gif
