lnminh1411/ESP32-PC-Control-System/firmware/gifs/firefly2.gif

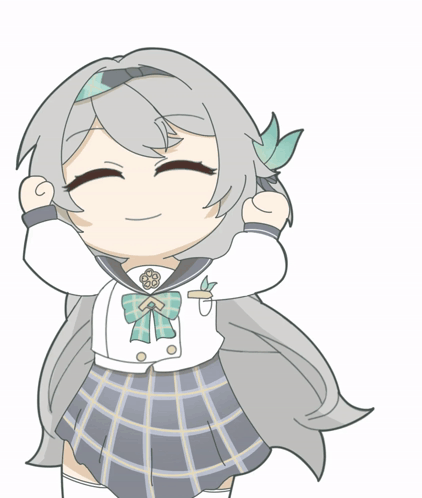
firmware/gifs/firefly2.gif
