lnminh1411/ESP32-PC-Control-System/firmware/gifs/firefly2_20fps.gif

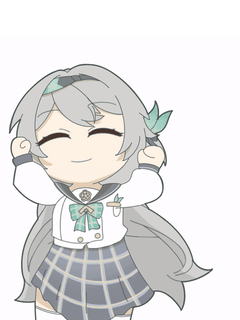
firmware/gifs/firefly2_20fps.gif
