lnminh1411/ESP32-PC-Control-System/firmware/gifs/firefly.gif

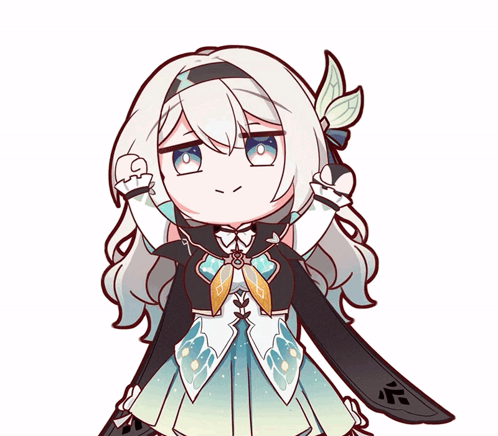
firmware/gifs/firefly.gif
