lnminh1411/ESP32-PC-Control-System/firmware/gifs/herta.gif

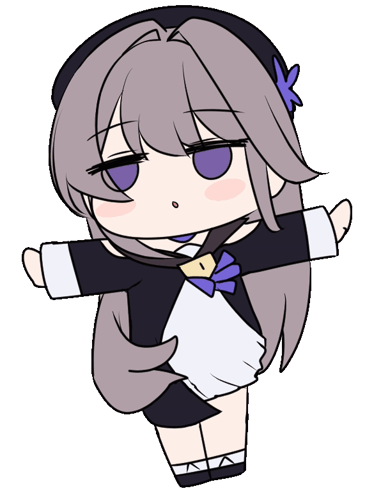
firmware/gifs/herta.gif
