lnminh1411/ESP32-PC-Control-System/firmware/gifs/herta_20fps.gif

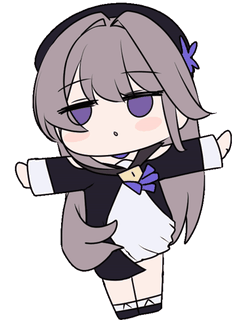
firmware/gifs/herta_20fps.gif
