lnminh1411/ESP32-PC-Control-System/firmware/gifs/kita.gif

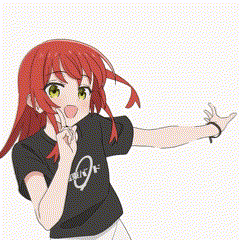
firmware/gifs/kita.gif
