lnminh1411/ESP32-PC-Control-System/firmware/gifs/kita_20fps.gif

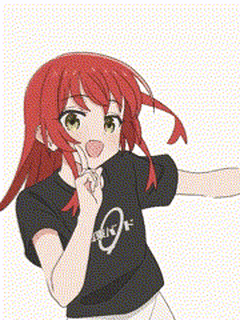
firmware/gifs/kita_20fps.gif
