lnminh1411/ESP32-PC-Control-System/firmware/gifs/march7.gif

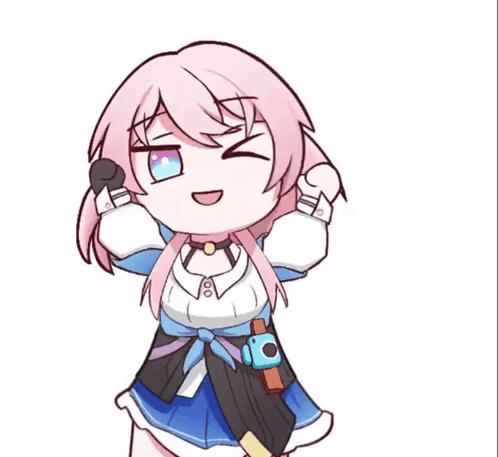
firmware/gifs/march7.gif
