lnminh1411/ESP32-PC-Control-System/firmware/gifs/miku.gif

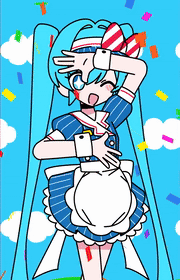
firmware/gifs/miku.gif
