lnminh1411/ESP32-PC-Control-System/firmware/gifs/miku_20fps.gif

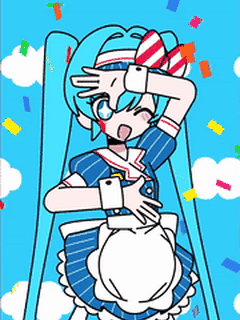
firmware/gifs/miku_20fps.gif
