lnminh1411/ESP32-PC-Control-System/firmware/gifs/miku_player_20fps.gif

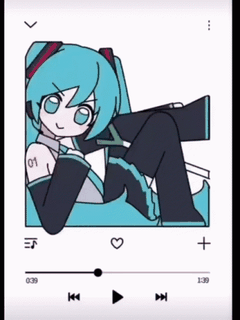
firmware/gifs/miku_player_20fps.gif
