lnminh1411/ESP32-PC-Control-System/firmware/gifs/neuro.gif

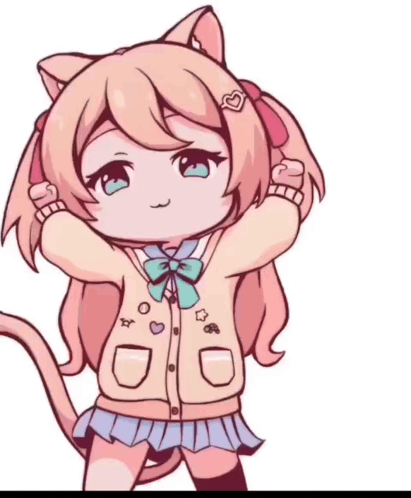
firmware/gifs/neuro.gif
