lnminh1411/ESP32-PC-Control-System/firmware/gifs/teto.gif

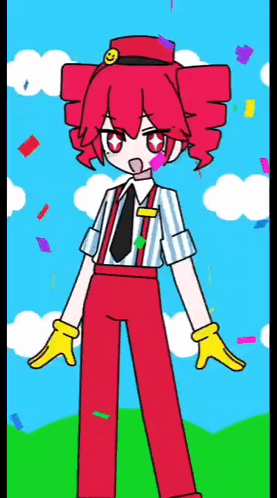
firmware/gifs/teto.gif
