lnminh1411/ESP32-PC-Control-System/firmware/gifs/teto_20fps.gif

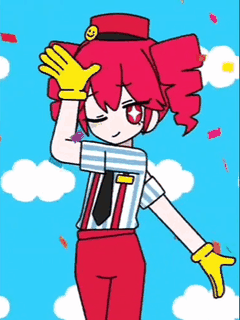
firmware/gifs/teto_20fps.gif
