lnminh1411/ESP32-PC-Control-System/firmware/gifs/teto_pppp.gif

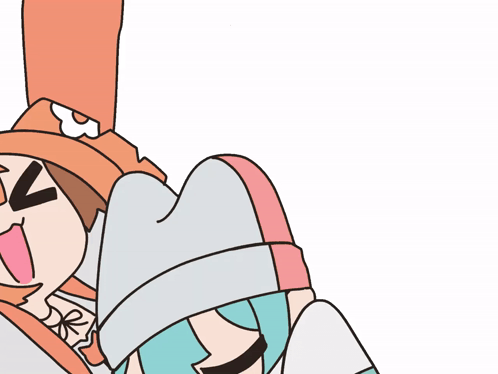
firmware/gifs/teto_pppp.gif
