lnminh1411/ESP32-PC-Control-System/enclosure/out/print/mask.step

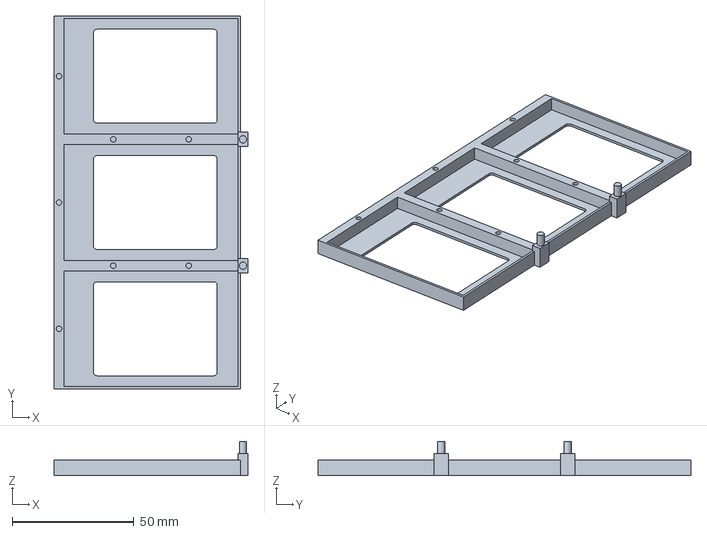
[picture p38: CAD file, 2026-11-06]
enclosure/out/print/mask.step
79.6 x 153.3 x 14.0 mm
