lnminh1411/ESP32-PC-Control-System/enclosure/out/print/backplate.step

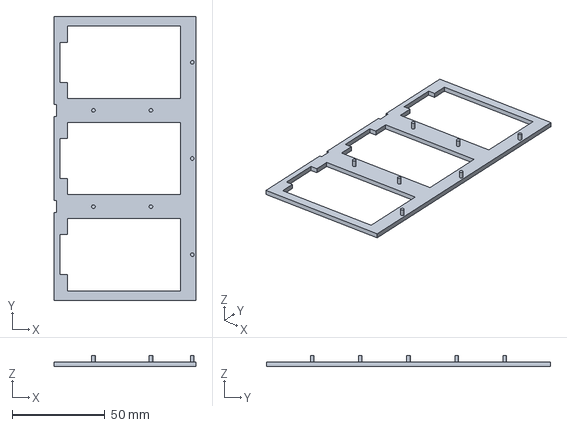
[picture p39: CAD file, 2026-11-06]
enclosure/out/print/backplate.step
76.6 x 153.3 x 6.04 mm
