lnminh1411/ESP32-PC-Control-System/enclosure/out/print/lid.step

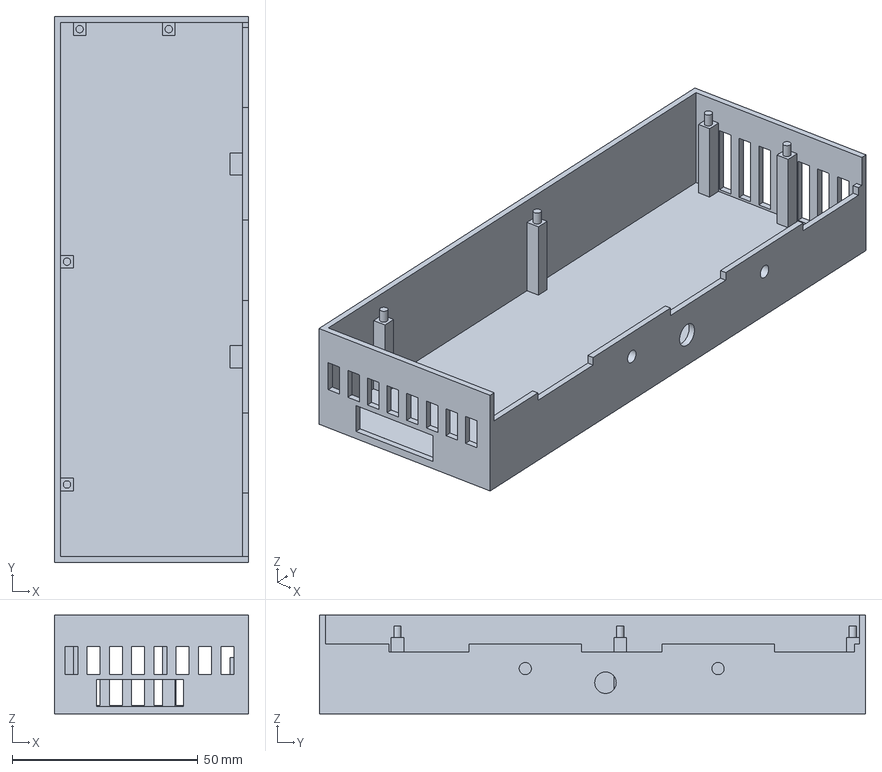
[picture p40: CAD file, 2026-11-06]
enclosure/out/print/lid.step
52.3 x 147.0 x 26.6 mm
