lnminh1411/ESP32-PC-Control-System/enclosure/out/print/block.step

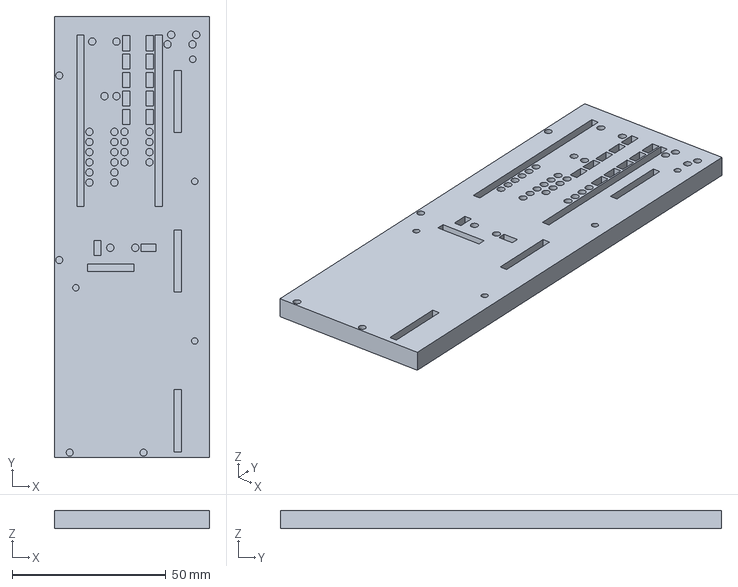
[picture p41: CAD file, 2026-11-06]
enclosure/out/print/block.step
50.5 x 143.4 x 6.00 mm
