lnminh1411/ESP32-PC-Control-System/(list of files, cad)

Other CAD files:
enclosure/out/backplate.stl
enclosure/out/block.stl
enclosure/out/lid.stl
enclosure/out/mask.stl
enclosure/out/print/backplate.stl
enclosure/out/print/block.stl
enclosure/out/print/lid.stl
enclosure/out/print/mask.stl
