lnminh1411/ESP32-PC-Control-System/enclosure/out/print/template_1to1.pdf

### USB-C END

J3

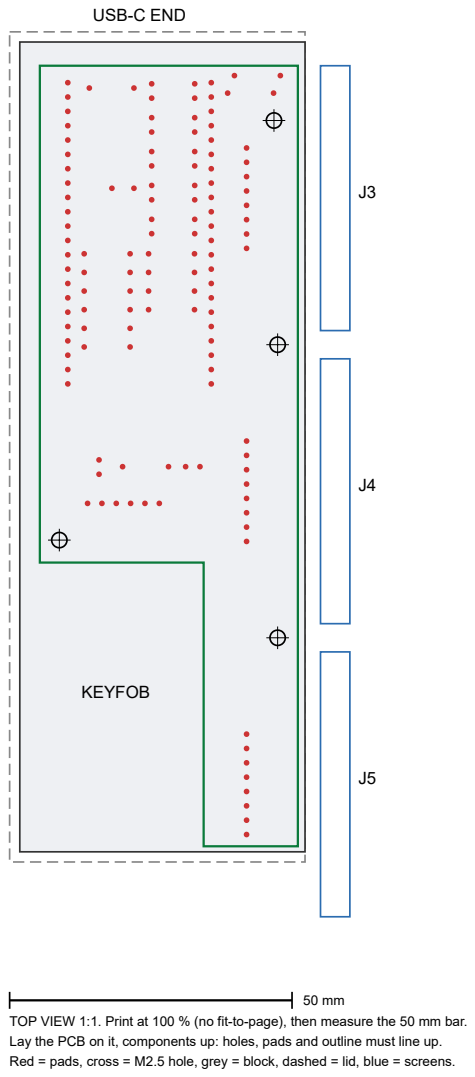
[picture p42: page 1]
KEYFOB

TOP VIEW 1:1. Print at 100 % (no fit-to-page), then measure the 50 mm bar.
Lay the PCB on it, components up: holes, pads and outline must line up.
Red = pads, cross = M2.5 hole, grey = block, dashed = lid, blue = screens.
