lnminh1411/ESP32-PC-Control-System/pcb/layouts/default/default.kicad_pcb

## KiCad design pcb/layouts/default/default.kicad_pcb (2026-10-05)

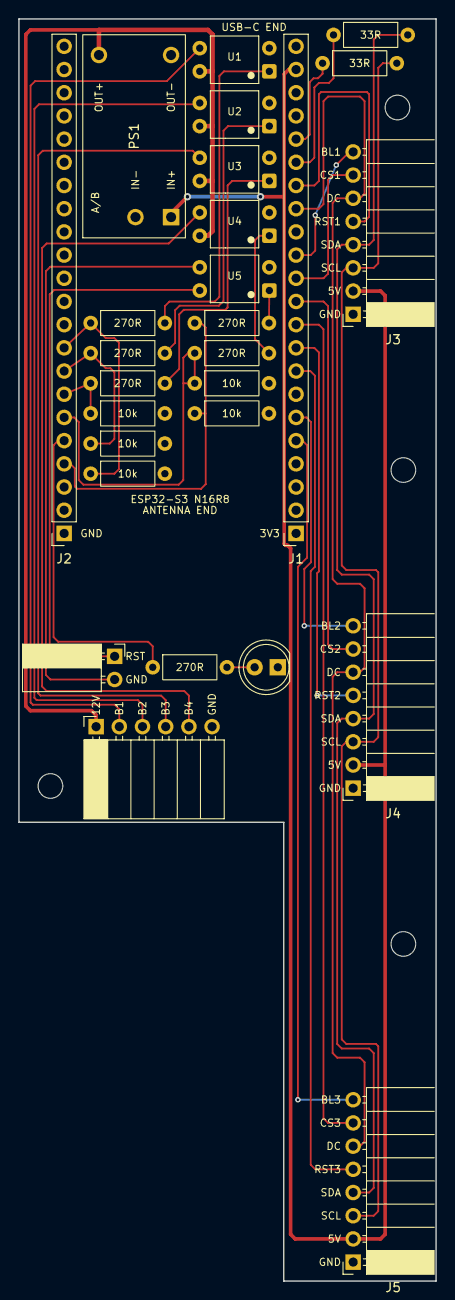
[picture p43: board default.kicad_pcb from above]

Board: 2 copper layers, 45.7 x 138.2 mm, 31 parts (0 on the bottom side), 35 nets.

Parts:
D1: main.ato:StatusLED; LED_D5.0mm
J1, J2: main.ato:Header1x22; PinSocket_1x22_P2.54mm_Vertical
J3, J4, J5: main.ato:DisplaySocket; PinSocket_1x08_P2.54mm_Horizontal
J6: main.ato:IsolatedPair; PinSocket_1x02_P2.54mm_Horizontal
J7: main.ato:KeyfobSocket; PinSocket_1x06_P2.54mm_Horizontal
MH1, MH2, MH3, MH4: MountingHole_2.7mm_M2.5
PS1: main.ato:BoostModuleBS01; Boost_CKCS_BS01
R1, R2, R3, R4, R5, R6: 270R; R_Axial_DIN0207_L6.3mm_D2.5mm_P10.16mm_Horizontal
R7, R10, R11, R12, R13: 10k; R_Axial_DIN0207_L6.3mm_D2.5mm_P10.16mm_Horizontal
R8, R9: 33R; R_Axial_DIN0207_L6.3mm_D2.5mm_P10.16mm_Horizontal
U1, U2, U3, U4, U5: main.ato:Optocoupler; DIP-4_W7.62mm

Connections:
btn1: J7.2, U1.3
btn2: J7.3, U2.3
btn3: J7.4, U3.3
btn4: J7.5, U4.3
disp_bl1: J1.13, J3.8
disp_bl2: J1.6, J4.8
disp_bl3: J1.5, J5.8
disp_dc: J1.15, J3.6, J4.6, J5.6
disp_mosi: J3.4, J4.4, J5.4, R9.2
disp_rst1: J1.16, J3.5
disp_rst2: J1.9, J4.5
disp_rst3: J1.8, J5.5
disp_sck: J3.3, J4.3, J5.3, R8.2
gnd: D1.1, J1.22, J2.1, J2.21, J2.22, J3.1, J4.1, J5.1, J7.6, PS1.2, PS1.4, R7.2, R10.2, R11.2, R12.2, R13.2, U1.2, U2.2, U3.2, U4.2, U5.2
gpio1: J2.4, R5.1, R10.1
gpio2: J2.5, R6.1
gpio8: J1.12, J3.7
gpio11: J1.17, R9.1
gpio12: J1.18, R8.1
gpio17: J1.10, J5.7
gpio18: J1.11, J4.7
gpio39: J2.9, R1.1, R7.1
gpio40: J2.8, R2.1, R13.1
gpio41: J2.7, R3.1, R12.1
gpio42: J2.6, R4.1, R11.1
led_a: D1.2, R6.2
mb_rst: J6.1, U5.4
mb_rst_gnd: J6.2, U5.3
opto1-anode: R1.2, U1.1
opto2-anode: R2.2, U2.1
opto3-anode: R3.2, U3.1
opto4-anode: R4.2, U4.1
opto5-anode: R5.2, U5.1
v5: J1.21, J3.2, J4.2, J5.2, PS1.1
v12: J7.1, PS1.3, U1.4, U2.4, U3.4, U4.4
