lnminh1411/ESP32-PC-Control-System/firmware/main/weather.cpp

#include "weather.h"

#include <cJSON.h>
#include <ctype.h>
#include <esp_crt_bundle.h>
#include <esp_heap_caps.h>
#include <esp_http_client.h>
#include <freertos/FreeRTOS.h>
#include <freertos/semphr.h>
#include <freertos/task.h>
#include <math.h>
#include <new>
#include <nvs.h>
#include <stdio.h>
#include <stdlib.h>
#include <string.h>
#include <time.h>

#include "board_time.h"
#include "cyclone.h"
#include "discord.h"
#include "log.h"
#include "net.h"
#include "nowcast.h"
#include "owm.h"
#include "owntracks.h"
#include "pushover.h"
#include "radar.h"
#include "tomorrow.h"
#include "settings_or_example.h"
#include "sys.h"
#include "views.h"

static WeatherNow now_;
static RainAlert rainHome;
static RainAlert rainPhone;
static Cyclone cyclone_;

// Next hours from the forecast: storm signs and the rain's end past the nowcast
struct HourWx {
  uint32_t unix;   // end of the hour (UTC); its values cover the hour before
  float mm;        // precipitation in that hour
  uint8_t code;    // WMO weather code
  uint8_t gust;    // km/h, capped at 255
};
static HourWx hours_[12];
static int nHours_;
static uint32_t forecastAtMs;   // last good forecast

// Cyclone tracks of storms near home (PSRAM), refreshed per GDACS advisory
static CycloneTrack *tracks_;
static constexpr int MAX_TRACKS = 3;
static int trackShown = -1;     // index in tracks_ behind cyclone_

// `weather demo`: polls leave the demo data alone and nothing is posted
static uint32_t demoUntilMs;
static bool demoOn() { return demoUntilMs && (int32_t)(demoUntilMs - nowMs()) > 0; }
// The real data the demo covers, put back when it ends (before rainWarnTick
// reads it: the demo's shower was posted as real once)
static WeatherNow demoSavedNow;
static RainAlert demoSavedHome;
static Cyclone demoSavedCyclone;
static bool demoSaved;
// `weather clear` from the console: done by the weather task, which owns the
// warning state it resets too
static volatile bool clearReq;
static volatile bool endResetReq;   // `weather end-reset`, done by the weather task
static struct {
  double lat, lon;
  char name[48];
  volatile bool set;
} homeReq;

// Discord colours: approaching > 20 min, close or here, cleared
static constexpr uint32_t COL_YELLOW = 0xF1C40F;
static constexpr uint32_t COL_RED = 0xE74C3C;
static constexpr uint32_t COL_GREEN = 0x2ECC71;
static constexpr uint32_t COL_BLUE = 0x3498DB;

static SemaphoreHandle_t wxMutex;
static TaskHandle_t wxTaskHandle;
static volatile bool wxDirty;

// Location configuration
static double homeLat;
static double homeLon;
static char homeName[48] = WEATHER_HOME_NAME;
static bool homeConfigured;

// Nowcast engines
static NowcastEngine *homeNowcast;     // both in PSRAM (weatherInit), 750 B each
static NowcastEngine *phoneNowcast;

// Budget state (<= 10000 daily, hard cap 9500)
static uint32_t currentUtcDay;
static uint32_t budgetTotalCalls;
static uint32_t budgetHomeCalls;
static uint32_t budgetPhoneCalls;
static uint32_t budgetFcCalls;
static bool homeThrottled;
static bool phoneThrottled;

// Phone notification state (1 message per rain event, re-arm after 60 min dry)

// Error logging masks (log once per kind)
enum ErrMask : uint16_t {
  ERR_FC_HTTP     = 1 << 0,
  ERR_FC_PARSE    = 1 << 1,
  ERR_AQI_HTTP    = 1 << 2,
  ERR_AQI_PARSE   = 1 << 3,
  ERR_HOME_HTTP   = 1 << 4,
  ERR_HOME_PARSE  = 1 << 5,
  ERR_PHONE_HTTP  = 1 << 6,
  ERR_PHONE_PARSE = 1 << 7,
  ERR_TC_HTTP     = 1 << 8,
  ERR_TC_TRACK    = 1 << 9,
  ERR_OWM         = 1 << 10,
  ERR_RADAR       = 1 << 11,
  ERR_TOMORROW    = 1 << 12,
};
static uint16_t loggedErrors;
static char lastError[160];              // shown by `weather show`
static esp_err_t lastHttpErr;
static volatile bool homeChanged;        // new home: poll right away
static volatile bool testAlertPending;   // sent from the weather task: HTTPS must not block the main loop
static volatile bool cycloneRefresh;     // `weather storms`: fetch GDACS again now

static void logErrorOnce(uint16_t mask, const char *msg) {
  snprintf(lastError, sizeof lastError, "%s", msg);
  if (!(loggedErrors & mask)) {
    loggedErrors |= mask;
    logMsg("%s", msg);
  }
}

static void clearError(uint16_t mask) {
  loggedErrors &= ~mask;
}

// Copies under wxMutex: the screens read these while the weather task writes
// them, and a frame could show half of one update
template <typename T> static T wxCopy(const T &v) {
  if (wxMutex) xSemaphoreTake(wxMutex, portMAX_DELAY);
  T c = v;
  if (wxMutex) xSemaphoreGive(wxMutex);
  return c;
}
WeatherNow weatherNow() { return wxCopy(now_); }
RainAlert rainAlertHome() { return wxCopy(rainHome); }
RainAlert rainAlertPhone() { return wxCopy(rainPhone); }

// The forecast sources in a RAIN_SRC_* mask as an index into the name tables
static int modelsOf(uint8_t mask) {
  return (mask & (RAIN_SRC_OPEN_METEO | RAIN_SRC_OPENWEATHER)) | (mask & RAIN_SRC_TOMORROW ? 4 : 0);
}

const char *rainSrcName(const RainAlert &a) {
  static const char *MODELS[8] = {"--", "Open-Meteo", "OpenWeather", "OM+OWM", "Tomorrow", "OM+TIO", "OWM+TIO", "all"};
  static const char *RADAR[8] = {"radar", "radar+OM", "radar+OWM", "radar+2", "radar+TIO", "radar+2", "radar+2", "radar+all"};
  return (a.src & RAIN_SRC_RADAR ? RADAR : MODELS)[modelsOf(a.src)];
}

int rainSrcLine(char *out, int cap, const RainAlert &a) {
  static const char *LONG[8] = {"--", "Open-Meteo", "OpenWeather", "Open-Meteo and OpenWeather", "Tomorrow.io",
                                "Open-Meteo and Tomorrow.io", "OpenWeather and Tomorrow.io",
                                "Open-Meteo, OpenWeather and Tomorrow.io"};
  int s = modelsOf(a.src), dry = modelsOf(a.dry);
  int n;
  if (a.src & RAIN_SRC_RADAR)
    n = snprintf(out, cap, "On the radar now%s%s", s ? ", and in " : " (the forecasts missed it)", s ? LONG[s] : "");
  else if (s && dry)
    n = snprintf(out, cap, "Seen by %s%s (%s: dry)", LONG[s], s & (s - 1) ? "" : " only", LONG[dry]);
  else n = snprintf(out, cap, "Seen by %s", LONG[s]);
  return n < cap ? n : cap - 1;
}

const char *rainEndSrcName(uint8_t src) {
  static const char *N[RAIN_END_N] = {"--", "nowcast", "OpenWeather", "upwind", "hourly", "range", "Tomorrow"};
  return src < RAIN_END_N ? N[src] : "--";
}

bool rainKindRange(uint8_t kind, int *loMin, int *hiMin) {
  if (kind == RAIN_KIND_SHOWER) { *loMin = WEATHER_SHOWER_MIN; *hiMin = WEATHER_SHOWER_MAX; return true; }
  if (kind == RAIN_KIND_THUNDER) { *loMin = WEATHER_TSTORM_MIN; *hiMin = WEATHER_TSTORM_MAX; return true; }
  return false;
}

// Open-Meteo's own nowcast results; rainHome / rainPhone are these merged
// with OpenWeather's and Tomorrow.io's minute-by-minute hours (owm.h,
// tomorrow.h) for the place they cover
static RainAlert omHome, omPhone;
static OwmMinutely owmLast;          // the last good OpenWeather hour
static bool owmOnPhone;              // ...for the phone, not home
static uint32_t omHomeAt, omPhoneAt; // when each Open-Meteo nowcast came in (UTC)
static uint8_t omHomeWet, omPhoneWet;  // nowcasts in a row that saw rain
static uint8_t owmWet;               // OpenWeather hours in a row that saw rain (its place)
static uint32_t owmEndLast;          // the rain end in OpenWeather's last hour (0 = none)
static bool owmEndOk;                // ...within 5 min of the one before: steady enough to use
static OwmMinutely tioLast;          // the last good Tomorrow.io hour
static bool tioOnPhone;              // ...for the phone, not home
static uint8_t tioWet;               // Tomorrow.io hours in a row that saw rain (its place)
static uint32_t tioEndLast;          // the rain end in Tomorrow.io's last hour (0 = none)
static bool tioEndOk;                // ...within 5 min of the one before: steady enough to use
static uint32_t upwindEnd, upwindAt; // home rain end from the upwind probe (0 = none); when it ran
static bool upwindBeyond;            // the probe's last point (2 h out) still had rain
static char owmSeen[8][40];          // alert IDs already posted
static uint8_t owmSeenNext;
Cyclone weatherCyclone() { return wxCopy(cyclone_); }

const char *wxTierName(WxTier t) {
  switch (t) {
    case TIER_DRIZZLE: return "Drizzle";
    case TIER_LIGHT_RAIN: return "Light Rain";
    case TIER_HEAVY_SHOWER: return "Heavy Shower";
    case TIER_STORM: return "Storm";
    case TIER_TYPHOON: return "Typhoon";
    case TIER_SUPER_TYPHOON: return "Super Typhoon";
    default: return "Rain";
  }
}

// newlib has no timegm
int64_t utcMkTime(const struct tm *t) {
  int y = t->tm_year + 1900, m = t->tm_mon + 1;
  y -= m <= 2;
  int64_t era = (y >= 0 ? y : y - 399) / 400;
  int64_t yoe = y - era * 400;
  int64_t doy = (153 * (m + (m > 2 ? -3 : 9)) + 2) / 5 + t->tm_mday - 1;
  int64_t days = era * 146097 + yoe * 365 + yoe / 4 - yoe / 100 + doy - 719468;
  return days * 86400 + t->tm_hour * 3600 + t->tm_min * 60 + t->tm_sec;
}

static bool clockValid(time_t *now) {
  *now = time(nullptr);
  return *now >= 1700000000;
}

int rainEtaMin(const RainAlert &a) {
  if (!a.active && !a.raining) return -1;
  if (a.raining) return 0;
  time_t now;
  if (!a.startUnix || !clockValid(&now)) return a.etaMin;
  long d = ((long)a.startUnix - (long)now + 59) / 60;
  return d > 0 ? (int)d : 0;
}

int rainLeftMin(const RainAlert &a) {
  time_t now;
  if (!a.endUnix || !clockValid(&now)) return -1;
  long d = ((long)a.endUnix - (long)now + 59) / 60;
  return d > 0 ? (int)d : 0;
}

static WxIcon wmoToWxIcon(int code) {
  if (code <= 1) return WX_CLEAR;
  if (code == 2) return WX_PARTLY;
  if (code == 3) return WX_CLOUDY;
  if (code == 45 || code == 48) return WX_FOG;
  if (code >= 51 && code <= 57) return WX_DRIZZLE;
  if (code >= 61 && code <= 67) return WX_RAIN;
  if (code >= 71 && code <= 77) return WX_SNOW;
  if (code >= 80 && code <= 82) return WX_SHOWERS;
  if (code >= 85 && code <= 86) return WX_SNOW;
  if (code >= 95 && code <= 99) return WX_STORM;
  return WX_CLOUDY;
}

static const char *calcDayName(int y, int m, int d) {
  static const char *names[] = {"Sun", "Mon", "Tue", "Wed", "Thu", "Fri", "Sat"};
  static const int t[] = {0, 3, 2, 5, 0, 3, 5, 1, 4, 6, 2, 4};
  if (m < 1 || m > 12 || y < 1 || d < 1 || d > 31) return "---";   // a malformed date from the server
  if (m < 3) y -= 1;
  int dow = (y + y / 4 - y / 100 + y / 400 + t[m - 1] + d) % 7;
  return names[dow];
}

// mode: 0 dry, 1 heavy shower in 25 min, 2 typhoon at home
static void loadDemo(int mode) {
  WeatherNow w = {};
  w.valid = true;
  // a made-up place: demo screenshots go public, and the home's name places you
  strcpy(w.place, "Demo City");
  strcpy(w.updated, "21:40");
  w.temp = 29.0f;
  w.tmax = 33;
  w.tmin = 25;
  w.icon = WX_RAIN;
  w.isDay = true;
  w.windKmh = 12.0f;
  w.windFromDeg = 225;
  w.aqi = 42;
  const WeatherDay days[3] = {{"Mon", WX_RAIN, 33, 24}, {"Tue", WX_CLEAR, 33, 24}, {"Wed", WX_SHOWERS, 31, 24}};
  memcpy(w.days, days, sizeof days);

  if (wxMutex) xSemaphoreTake(wxMutex, portMAX_DELAY);
  if (!demoSaved) {
    demoSavedNow = now_;
    demoSavedHome = rainHome;
    demoSavedCyclone = cyclone_;
    demoSaved = true;
  }
  now_ = w;
  rainHome = {};
  cyclone_ = {};
  time_t now;
  bool clock = clockValid(&now);
  if (mode == 1) {
    rainHome.active = true;
    rainHome.etaMin = 25;
    rainHome.startUnix = clock ? (uint32_t)now + 25 * 60 : 0;
    rainHome.endUnix = clock ? (uint32_t)now + 95 * 60 : 0;
    rainHome.mmh = 9.2f;
    rainHome.tier = TIER_HEAVY_SHOWER;
    rainHome.src = RAIN_SRC_OPEN_METEO | RAIN_SRC_OPENWEATHER;
    strcpy(rainHome.from, "NW");
  } else if (mode == 2) {
    cyclone_.tracked = cyclone_.active = true;
    strcpy(cyclone_.name, "KAJIKI");
    cyclone_.distKm = 80;
    cyclone_.closestKm = 45;
    cyclone_.windKmh = 150;
  } else {
    rainHome.dryKm = 40;
  }
  if (wxMutex) xSemaphoreGive(wxMutex);
  wxDirty = true;
}

// HTTP buffer in PSRAM
struct HttpBuffer {
  char *buf;
  size_t cap;
  size_t len;
};

static esp_err_t httpEventCb(esp_http_client_event_t *evt) {
  if (evt->event_id == HTTP_EVENT_ON_DATA) {
    HttpBuffer *hb = (HttpBuffer *)evt->user_data;
    if (hb && hb->buf && hb->len + 1 < hb->cap) {
      size_t copyLen = evt->data_len;
      if (hb->len + copyLen >= hb->cap) {
        copyLen = hb->cap - 1 - hb->len;
      }
      memcpy(hb->buf + hb->len, evt->data, copyLen);
      hb->len += copyLen;
      hb->buf[hb->len] = '\0';
    }
  }
  return ESP_OK;
}

// timeoutMs: GDACS can take over 10 s to start sending a large track
static bool httpGet(const char *url, char *buf, size_t cap, int *outStatus, int timeoutMs = 10000) {
  HttpBuffer hb = {buf, cap, 0};
  buf[0] = '\0';

  esp_http_client_config_t cfg = {};
  cfg.url = url;
  cfg.crt_bundle_attach = esp_crt_bundle_attach;
  cfg.timeout_ms = timeoutMs;
  cfg.buffer_size_tx = 1024;   // the nowcast's 17-point URL is ~550 bytes
  cfg.event_handler = httpEventCb;
  cfg.user_data = &hb;

  esp_http_client_handle_t client = esp_http_client_init(&cfg);
  if (!client) return false;

  esp_err_t err = esp_http_client_perform(client);
  lastHttpErr = err;
  int status = esp_http_client_get_status_code(client);
  if (outStatus) *outStatus = status;
  esp_http_client_cleanup(client);
  if (err == ESP_OK && status > 0) netNoteTraffic();

  return (err == ESP_OK && status >= 200 && status < 300 && hb.len > 0);
}

static void saveBudgetNvs() {
  time_t now = time(nullptr);
  if (now < 1700000000) return;
  uint32_t curDay = (uint32_t)(now / 86400);

  nvs_handle_t h;
  if (nvs_open("wx", NVS_READWRITE, &h) == ESP_OK) {
    nvs_set_u32(h, "b_day", curDay);
    nvs_set_u32(h, "b_tot", budgetTotalCalls);
    nvs_set_u32(h, "b_home", budgetHomeCalls);
    nvs_set_u32(h, "b_phone", budgetPhoneCalls);
    nvs_set_u32(h, "b_fc", budgetFcCalls);
    nvs_commit(h);
    nvs_close(h);
  }
}

static bool checkBudgetNowcast(bool isPhoneEngine) {
  time_t now = time(nullptr);
  uint32_t curDay = (now >= 1700000000) ? (uint32_t)(now / 86400) : 0;

  if (curDay != 0 && curDay != currentUtcDay) {
    currentUtcDay = curDay;
    budgetTotalCalls = 0;
    budgetHomeCalls = 0;
    budgetPhoneCalls = 0;
    budgetFcCalls = 0;
    homeThrottled = false;
    phoneThrottled = false;
    saveBudgetNvs();
  }

  if (budgetTotalCalls + 17 > 9500) {
    return false;
  }

  double share = 0.0;
  bool merged = owntracksIsMerged(homeLat, homeLon);
  if (merged) {
    share = isPhoneEngine ? 0.0 : 1.0;
  } else {
    share = isPhoneEngine ? 0.65 : 0.35;
  }

  if (share <= 0.0) return false;

  double elapsedFraction = 1.0;
  if (now >= 1700000000) {
    uint32_t secToday = (uint32_t)(now % 86400);
    elapsedFraction = (double)secToday / 86400.0;
  }

  uint32_t usedByEngine = isPhoneEngine ? budgetPhoneCalls : budgetHomeCalls;
  double allowed = share * (elapsedFraction * 9100.0 + 300.0);

  if ((double)(usedByEngine + 17) <= allowed) {
    if (isPhoneEngine) phoneThrottled = false;
    else homeThrottled = false;
    return true;
  }

  if (isPhoneEngine) {
    if (!phoneThrottled) {
      phoneThrottled = true;
      logMsg("weather: phone engine throttled by budget (%u used)", (unsigned)budgetPhoneCalls);
    }
  } else {
    if (!homeThrottled) {
      homeThrottled = true;
      logMsg("weather: home engine throttled by budget (%u used)", (unsigned)budgetHomeCalls);
    }
  }
  return false;
}

static bool checkBudgetForecast() {
  if (budgetTotalCalls + 1 > 9500) return false;
  return true;
}

// Open-Meteo "current" + "daily" into a WeatherNow (no AQI: -1)
static bool parseNow(cJSON *root, const char *place, WeatherNow *out) {
  cJSON *curr = cJSON_GetObjectItem(root, "current");
  cJSON *daily = cJSON_GetObjectItem(root, "daily");

  if (!curr || !daily) return false;
  {
    WeatherNow &w = *out;
    w = {};
    w.valid = true;
    w.aqi = -1;
    snprintf(w.place, sizeof(w.place), "%s", place);

    struct tm tmNow;
    if (boardLocalTime(&tmNow)) {
      snprintf(w.updated, sizeof(w.updated), "%02d:%02d", tmNow.tm_hour, tmNow.tm_min);
    } else {
      strcpy(w.updated, "--:--");
    }

    cJSON *temp = cJSON_GetObjectItem(curr, "temperature_2m");
    cJSON *wcode = cJSON_GetObjectItem(curr, "weather_code");
    cJSON *isDay = cJSON_GetObjectItem(curr, "is_day");
    cJSON *wspd = cJSON_GetObjectItem(curr, "wind_speed_10m");
    cJSON *wdir = cJSON_GetObjectItem(curr, "wind_direction_10m");

    w.temp = temp ? (float)temp->valuedouble : 0.0f;
    w.icon = wcode ? wmoToWxIcon(wcode->valueint) : WX_CLEAR;
    w.isDay = isDay ? (isDay->valueint == 1) : true;
    w.windKmh = wspd ? (float)wspd->valuedouble : 0.0f;
    w.windFromDeg = wdir ? (uint16_t)wdir->valuedouble : 0;

    cJSON *tmaxArr = cJSON_GetObjectItem(daily, "temperature_2m_max");
    cJSON *tminArr = cJSON_GetObjectItem(daily, "temperature_2m_min");
    cJSON *codeArr = cJSON_GetObjectItem(daily, "weather_code");
    cJSON *timeArr = cJSON_GetObjectItem(daily, "time");

    if (tmaxArr && cJSON_GetArraySize(tmaxArr) > 0) {
      w.tmax = (int8_t)round(cJSON_GetArrayItem(tmaxArr, 0)->valuedouble);
    }
    if (tminArr && cJSON_GetArraySize(tminArr) > 0) {
      w.tmin = (int8_t)round(cJSON_GetArrayItem(tminArr, 0)->valuedouble);
    }

    for (int i = 0; i < 3; i++) {
      int idx = i + 1;
      if (timeArr && idx < cJSON_GetArraySize(timeArr)) {
        const char *ts = cJSON_GetArrayItem(timeArr, idx)->valuestring;
        int y = 0, m = 0, d = 0;
        if (ts && sscanf(ts, "%d-%d-%d", &y, &m, &d) == 3) {
          snprintf(w.days[i].name, sizeof(w.days[i].name), "%s", calcDayName(y, m, d));
        }
      }
      if (codeArr && idx < cJSON_GetArraySize(codeArr)) {
        w.days[i].icon = wmoToWxIcon(cJSON_GetArrayItem(codeArr, idx)->valueint);
      }
      if (tmaxArr && idx < cJSON_GetArraySize(tmaxArr)) {
        w.days[i].tmax = (int8_t)round(cJSON_GetArrayItem(tmaxArr, idx)->valuedouble);
      }
      if (tminArr && idx < cJSON_GetArraySize(tminArr)) {
        w.days[i].tmin = (int8_t)round(cJSON_GetArrayItem(tminArr, idx)->valuedouble);
      }
    }
  }
  return true;
}

// The weather now (and the next days) at the phone's location, for the
// 2-hourly update while you are away: one forecast call
static bool fetchNowAt(double lat, double lon, char *buf, size_t cap, WeatherNow *w) {
  if (!buf || !checkBudgetForecast()) return false;
  char url[256];
  snprintf(url, sizeof(url),
           "https://api.open-meteo.com/v1/forecast?latitude=%.5f&longitude=%.5f"
           "&current=temperature_2m,weather_code,is_day,wind_speed_10m,wind_direction_10m"
           "&daily=weather_code,temperature_2m_max,temperature_2m_min&timezone=auto&forecast_days=4",
           lat, lon);
  int status = 0;
  if (!httpGet(url, buf, cap, &status)) {
    logMsg("weather: phone update: HTTP failed (%d)", status);
    return false;
  }
  budgetTotalCalls++;
  budgetFcCalls++;
  cJSON *root = cJSON_Parse(buf);
  if (!root) return false;
  bool ok = parseNow(root, "where you are", w);
  cJSON_Delete(root);
  return ok;
}

static void fetchForecast(char *buf, size_t cap) {
  char url[320];
  snprintf(url, sizeof(url),
           "https://api.open-meteo.com/v1/forecast?latitude=%.5f&longitude=%.5f"
           "&current=temperature_2m,weather_code,is_day,wind_speed_10m,wind_direction_10m"
           "&daily=weather_code,temperature_2m_max,temperature_2m_min"
           "&hourly=precipitation,weather_code,wind_gusts_10m&forecast_hours=12"
           "&timezone=auto&forecast_days=4",
           homeLat, homeLon);

  int status = 0;
  if (!httpGet(url, buf, cap, &status)) {
    char err[80];
    snprintf(err, sizeof(err), "weather: forecast HTTP failed (%d, %s)", status, esp_err_to_name(lastHttpErr));
    logErrorOnce(ERR_FC_HTTP, err);
    return;
  }
  clearError(ERR_FC_HTTP);
  budgetTotalCalls++;
  budgetFcCalls++;

  cJSON *root = cJSON_Parse(buf);
  if (!root) {
    logErrorOnce(ERR_FC_PARSE, "weather: forecast JSON parse failed");
    return;
  }
  clearError(ERR_FC_PARSE);

  cJSON *tzSec = cJSON_GetObjectItem(root, "utc_offset_seconds");
  int32_t utcOffset = 0;
  if (tzSec && cJSON_IsNumber(tzSec)) {
    utcOffset = tzSec->valueint;
    boardTimeSetUtcOffset(utcOffset);
  }

  // hourly: local "YYYY-MM-DDTHH:MM" stamps, each value covering the hour before
  cJSON *hourly = cJSON_GetObjectItem(root, "hourly");
  if (hourly) {
    cJSON *ht = cJSON_GetObjectItem(hourly, "time");
    cJSON *hp = cJSON_GetObjectItem(hourly, "precipitation");
    cJSON *hc = cJSON_GetObjectItem(hourly, "weather_code");
    cJSON *hg = cJSON_GetObjectItem(hourly, "wind_gusts_10m");
    int n = ht ? cJSON_GetArraySize(ht) : 0;
    HourWx hw[12] = {};
    int k = 0;
    for (int i = 0; i < n && k < 12; i++) {
      const char *ts = cJSON_GetArrayItem(ht, i)->valuestring;
      int y, mo, d, h, mi;
      if (!ts || sscanf(ts, "%d-%d-%dT%d:%d", &y, &mo, &d, &h, &mi) != 5) continue;
      struct tm t = {};
      t.tm_year = y - 1900;
      t.tm_mon = mo - 1;
      t.tm_mday = d;
      t.tm_hour = h;
      t.tm_min = mi;
      // the stamps are local: read them as UTC, then take the zone off
      cJSON *p = hp ? cJSON_GetArrayItem(hp, i) : nullptr;
      cJSON *c = hc ? cJSON_GetArrayItem(hc, i) : nullptr;
      cJSON *g = hg ? cJSON_GetArrayItem(hg, i) : nullptr;
      hw[k].unix = (uint32_t)(utcMkTime(&t) - utcOffset);
      hw[k].mm = (p && cJSON_IsNumber(p)) ? (float)p->valuedouble : 0.0f;
      hw[k].code = (c && cJSON_IsNumber(c)) ? (uint8_t)c->valueint : 0;
      double gv = (g && cJSON_IsNumber(g)) ? g->valuedouble : 0.0;
      hw[k].gust = (uint8_t)(gv > 255 ? 255 : gv < 0 ? 0 : gv);
      k++;
    }
    if (wxMutex) xSemaphoreTake(wxMutex, portMAX_DELAY);
    memcpy(hours_, hw, sizeof hw);
    nHours_ = k;
    if (wxMutex) xSemaphoreGive(wxMutex);
  }

  // zeroed: the screens read now_ without the lock, and a copy torn midway
  // still finds place[] terminated
  WeatherNow w = {};
  if (parseNow(root, homeName, &w)) {
    if (wxMutex) xSemaphoreTake(wxMutex, portMAX_DELAY);
    w.aqi = now_.aqi; // preserve existing AQI until AQI call completes
    now_ = w;
    if (wxMutex) xSemaphoreGive(wxMutex);
    forecastAtMs = nowMs();
    wxDirty = true;
  }

  cJSON_Delete(root);
}

static void fetchAirQuality(char *buf, size_t cap) {
  char url[160];
  snprintf(url, sizeof(url),
           "https://air-quality-api.open-meteo.com/v1/air-quality?latitude=%.5f&longitude=%.5f&current=us_aqi",
           homeLat, homeLon);

  int status = 0;
  if (!httpGet(url, buf, cap, &status)) {
    char err[64];
    snprintf(err, sizeof(err), "weather: AQI HTTP failed (%d)", status);
    logErrorOnce(ERR_AQI_HTTP, err);
    return;
  }
  clearError(ERR_AQI_HTTP);
  budgetTotalCalls++;
  budgetFcCalls++;

  cJSON *root = cJSON_Parse(buf);
  if (!root) {
    logErrorOnce(ERR_AQI_PARSE, "weather: AQI JSON parse failed");
    return;
  }
  clearError(ERR_AQI_PARSE);

  cJSON *curr = cJSON_GetObjectItem(root, "current");
  if (curr) {
    cJSON *aqiVal = cJSON_GetObjectItem(curr, "us_aqi");
    if (aqiVal && cJSON_IsNumber(aqiVal)) {
      if (wxMutex) xSemaphoreTake(wxMutex, portMAX_DELAY);
      now_.aqi = (int16_t)aqiVal->valueint;
      if (wxMutex) xSemaphoreGive(wxMutex);
      wxDirty = true;
    }
  }

  cJSON_Delete(root);
}


// The hourly forecast has rain (0.2 mm+) in the hour holding t or the next
static bool hourlyWetNear(uint32_t t) {
  for (int i = 0; i < nHours_; i++) {
    uint32_t hEnd = hours_[i].unix;
    if (hEnd > t && hEnd - 3600 <= t + 3600 && hours_[i].mm >= 0.2f) return true;
  }
  return false;
}

// Past the nowcast's ~105 min the rain's end comes from the hourly forecast:
// the first dry hour (under 0.2 mm) starting 30+ min after the rain does.
// Only when the hourly forecast has that rain at all: a shower it misses gets
// no made-up length (endUnknown)
static uint32_t endFromHourly(uint32_t start) {
  if (!hourlyWetNear(start)) return 0;
  for (int i = 0; i < nHours_; i++) {
    uint32_t hStart = hours_[i].unix - 3600;
    if (hStart >= start + 30 * 60 && hours_[i].mm < 0.2f) return hStart;
  }
  return 0;
}

// Kind of rain from the hourly weather codes for the hour holding start and
// the next: thunder anywhere wins; steady rain only when the forecast has it
// and no showers. Rain the forecast misses altogether is a passing shower.
static uint8_t rainKind(uint32_t start) {
  bool shower = false, steady = false;
  for (int i = 0; i < nHours_; i++) {
    uint32_t hEnd = hours_[i].unix;
    if (hEnd <= start || hEnd - 3600 > start + 3600) continue;
    uint8_t c = hours_[i].code;
    if (c >= 95) return RAIN_KIND_THUNDER;
    if (c >= 80 && c <= 82) shower = true;
    else if (c >= 51 && c <= 67) steady = true;
  }
  return (steady && !shower) ? RAIN_KIND_STEADY : RAIN_KIND_SHOWER;
}

// Drizzle / Light Rain / Heavy Shower by intensity alone (the phone: home's
// hourly forecast says nothing about where you are)
static WxTier rainTierMm(float mm) {
  if (mm >= WEATHER_HEAVY_SHOWER_MMH) return TIER_HEAVY_SHOWER;
  return mm >= WEATHER_LIGHT_RAIN_MMH ? TIER_LIGHT_RAIN : TIER_DRIZZLE;
}

// Drizzle / Light Rain / Heavy Shower by intensity (under WEATHER_LIGHT_RAIN_MMH;
// 7.6 mm/h is "heavy rain"); Storm
// when the forecast has thunder or 62+ km/h gusts (Beaufort 8) while it rains
static WxTier rainTier(const RainAlert &a) {
  uint32_t from = a.startUnix, to = a.endUnix ? a.endUnix : a.startUnix + 2 * 3600;
  float mm = a.mmh;
  for (int i = 0; i < nHours_; i++) {
    uint32_t hEnd = hours_[i].unix, hStart = hEnd - 3600;
    if (from ? (hEnd <= from || hStart >= to) : i > 1) continue;   // no clock: the next two hours
    if (hours_[i].code >= 95 || hours_[i].gust >= WEATHER_STORM_GUST_KMH) return TIER_STORM;
    if (hours_[i].mm > mm) mm = hours_[i].mm;
  }
  return rainTierMm(mm);
}

// OpenWeather's hour counts for 5 min after it was fetched, for its place only
// After a failed answer (OpenWeather's empty minute list comes in spells of
// up to ~10 min) the last good hour counts for up to 15 min, while its minutes
// still reach 30 min ahead: a blank spell doesn't read as dry
static uint32_t owmFailUnix;   // last failed fetch
static bool owmFresh(bool phone, uint32_t now) {
  if (!owmLast.valid || owmOnPhone != phone) return false;
  uint32_t age = now - owmLast.fetchedUnix;
  if (age < 5 * 60) return true;
  uint32_t coversUntil = owmLast.dt0 + (uint32_t)owmLast.n * 60;
  return owmFailUnix > owmLast.fetchedUnix && age < 15 * 60 && coversUntil > now + 30 * 60;
}

// Tomorrow.io's hour counts for 8 min after it was fetched (it polls every 6
// at most), for its place only
static bool tioFresh(bool phone, uint32_t now) {
  return tioLast.valid && tioOnPhone == phone && now - tioLast.fetchedUnix < 8 * 60;
}

// Open-Meteo's nowcast counts while its slowest cadence (15 min) could still be running
static bool omFresh(bool phone, uint32_t now) {
  uint32_t at = phone ? omPhoneAt : omHomeAt;
  return at && now - at < 20 * 60;
}

// A minute-by-minute source for the merge: its hour (null = none fresh), its
// polls in a row with rain, and whether two of its hours agree on the end
struct MinuteSrc {
  const OwmMinutely *m;
  uint8_t held;
  bool endOk;
};

// Open-Meteo's nowcast (in *a), OpenWeather's hour and Tomorrow.io's hour
// weighed into one call. Two or more see rain: a warning, from the earliest
// minute-by-minute start, at the highest intensity. One alone: a warning when
// it is heavy (WEATHER_RAIN_SURE_MMH); else, if another source is fresh and
// dry over that time, only once it rains and has held 3 polls; else when it
// is close (WEATHER_RAIN_SURE_MIN) or has held 2 polls. A minute-by-minute
// source alone also needs more than a sprinkle (OWM_RAIN_SOLID_*). Anything
// less is a watch: on the screens, never posted. *held: each source's polls
// in a row with rain. The end: the latest of the three, a minute-by-minute
// one only once two of its hours agree on it (endOk).
static void mergeModels(RainAlert *a, bool phone, uint8_t omHeld, const MinuteSrc &owm, const MinuteSrc &tio) {
  uint32_t now = (uint32_t)time(nullptr);
  bool omWet = a->active || a->raining;
  a->src = omWet ? RAIN_SRC_OPEN_METEO : 0;
  a->dry = (!omWet && omFresh(phone, now)) ? RAIN_SRC_OPEN_METEO : 0;
  a->watch = false;
  a->endUnknown = false;
  a->endSrc = (omWet && a->endUnix) ? RAIN_END_NOWCAST : RAIN_END_NONE;
  a->kind = RAIN_KIND_STEADY;
  OwmRain o = {}, t = {};
  bool owmOk = owm.m && owmRainSummary(*owm.m, now, &o);
  bool tioOk = tio.m && owmRainSummary(*tio.m, now, &t, TOMORROW_RAIN_MMH);
  if (owmOk && !o.sees) a->dry |= RAIN_SRC_OPENWEATHER;
  if (tioOk && !t.sees) a->dry |= RAIN_SRC_TOMORROW;
  if (o.sees) a->src |= RAIN_SRC_OPENWEATHER;
  if (t.sees) a->src |= RAIN_SRC_TOMORROW;
  if (o.sees || t.sees) {
    const OwmRain &first = !t.sees || (o.sees && o.startUnix <= t.startUnix) ? o : t;   // rain now starts at now
    float peak = o.peak > t.peak ? o.peak : t.peak;
    if (peak > a->mmh) a->mmh = peak;
    if (first.rainingNow) {
      if (!a->raining) a->startUnix = first.startUnix;
      a->raining = true;
      a->active = false;
    } else if (!a->raining) {
      a->active = true;
      a->startUnix = first.startUnix;   // the minute-by-minute start wins
      a->etaMin = (uint16_t)((first.startUnix - now + 30) / 60);
    }
    if (!omWet) {   // Open-Meteo's start and end, if any, are of later rain
      a->endUnix = 0;
      a->endSrc = RAIN_END_NONE;
    }
    if (o.endUnix && owm.endOk && o.endUnix > a->endUnix) {
      a->endUnix = o.endUnix;
      a->endSrc = RAIN_END_OWM;
    }
    if (t.endUnix && tio.endOk && t.endUnix > a->endUnix) {
      a->endUnix = t.endUnix;
      a->endSrc = RAIN_END_TOMORROW;
    }
  }
  if (!a->src || (a->src & (a->src - 1))) return;   // nobody, or two or more

  bool omOnly = a->src == RAIN_SRC_OPEN_METEO, owmOnly = a->src == RAIN_SRC_OPENWEATHER;
  const OwmRain &lone = owmOnly ? o : t;
  bool contradicted = (a->dry & RAIN_SRC_OPEN_METEO) || ((a->dry & RAIN_SRC_OPENWEATHER) && a->startUnix < o.coversUntil) ||
                      ((a->dry & RAIN_SRC_TOMORROW) && a->startUnix < t.coversUntil);
  int eta = a->raining ? 0 : (a->startUnix > now ? (int)((a->startUnix - now) / 60) : a->etaMin);
  uint8_t held = omOnly ? omHeld : owmOnly ? owm.held : tio.held;
  bool warnIt;
  if (a->mmh >= WEATHER_RAIN_SURE_MMH) warnIt = true;
  else if (!omOnly && lone.peak < OWM_RAIN_SOLID_MMH && lone.run < OWM_RAIN_SOLID_MIN) warnIt = false;
  else if (contradicted) warnIt = a->raining && held >= 3;
  else warnIt = eta <= WEATHER_RAIN_SURE_MIN || held >= 2;
  if (warnIt) return;
  a->watch = true;
  a->active = a->raining = false;
}

// The radar's newest frame for one place (radarTick: the phone while away, else home)
static RadarObs radarLast;
static bool radarOnPhone;
static bool radarWasWet;   // for the log line when the place turns wet or dry
static bool radarApproaching;   // the nearest echo came 2+ km closer since the last frame
static bool radarFresh(bool phone, uint32_t now) {
  return radarLast.valid && radarOnPhone == phone && now - radarLast.fetchedUnix < 20 * 60 &&
         now - radarLast.frameUnix < RADAR_MAX_AGE_S;
}

// The models' call, then the radar's: rain on the radar at the place is
// falling now, so it is a warning whatever the models say (they missed the
// 05:00 drizzle of 10-29). Open-Meteo alone, with the radar dry at the place,
// is a watch unless an echo is within 5 km or moving in within
// WEATHER_OM_RADAR_KM: its 15-min field is interpolated from hourly runs here,
// and nine in ten of its lone warnings were wrong (2026-11). Rain that does
// come shows on the radar and warns then.
static void mergeRain(RainAlert *a, bool phone, uint8_t omHeld, const MinuteSrc &owm, const MinuteSrc &tio) {
  static bool omVetoed[2];
  mergeModels(a, phone, omHeld, owm, tio);
  uint32_t now = (uint32_t)time(nullptr);
  if (!radarFresh(phone, now)) return;
  if (!radarRainingHere(radarLast)) {
    a->dry |= RAIN_SRC_RADAR;
    int near = radarLast.nearKm;
    bool backed = near >= 0 && (near <= 5 || (radarApproaching && near <= WEATHER_OM_RADAR_KM));
    bool veto = a->src == RAIN_SRC_OPEN_METEO && (a->active || a->raining) && !backed;
    if (veto != omVetoed[phone]) {
      omVetoed[phone] = veto;
      char what[40] = "no echo on the tile";
      if (near >= 0) snprintf(what, sizeof what, "nearest echo %d km, %s", near, radarApproaching ? "moving in" : "not moving in");
      if (veto) logMsg("weather: %s: Open-Meteo alone sees rain, radar dry (%s): a watch", phone ? "phone" : "home", what);
    }
    if (veto) {
      a->watch = true;
      a->active = a->raining = false;
    }
    return;
  }
  omVetoed[phone] = false;
  a->src |= RAIN_SRC_RADAR;
  if (!a->raining) {
    a->startUnix = radarLast.frameUnix;
    if (a->endUnix && a->endUnix <= now) {
      a->endUnix = 0;
      a->endSrc = RAIN_END_NONE;
    }
  }
  a->raining = true;
  a->active = a->watch = false;
  a->etaMin = 0;
  if (radarLast.mmhHere > a->mmh) a->mmh = radarLast.mmhHere;
}

static void mergeSources(RainAlert *a, bool phone) {
  uint32_t now = (uint32_t)time(nullptr);
  MinuteSrc owm = {owmFresh(phone, now) ? &owmLast : nullptr, owmWet, owmEndOk};
  MinuteSrc tio = {tioFresh(phone, now) ? &tioLast : nullptr, tioWet, tioEndOk};
  mergeRain(a, phone, phone ? omPhoneWet : omHomeWet, owm, tio);
}

// The upwind probe's answer counts for 15 min (it runs every 10 while it matters)
static bool upwindFresh(uint32_t now) {
  return upwindAt && now - upwindAt < 15 * 60;
}

// Rain end when the nowcasts have none: the upwind probe (home only), else the
// hourly forecast when it has the rain. The kind of rain either way.
static void fillEnd(RainAlert *a, bool home) {
  if (!(a->active || a->raining || a->watch) || !a->startUnix) return;
  a->kind = rainKind(a->startUnix);
  if (a->endUnix) return;
  uint32_t now = (uint32_t)time(nullptr);
  if (home && upwindFresh(now) && upwindEnd > a->startUnix && upwindEnd > now) {
    a->endUnix = upwindEnd;
    a->endSrc = RAIN_END_UPWIND;
    return;
  }
  a->endUnix = endFromHourly(a->startUnix);
  if (a->endUnix) a->endSrc = RAIN_END_HOURLY;
  a->endUnknown = !a->endUnix && !hourlyWetNear(a->startUnix);
}

static void fmtClock(char *out, size_t cap, uint32_t unixT, bool withDay);

// Rain-end tracker (home): each source's first end estimate for a rain, held
// against the time the rain was seen to stop: the first poll in which no
// source saw rain at that minute, once it has stayed so for 10 min. Error
// stats per source persist in NVS ("wx"/"endst"); `weather show` prints them.
struct EndStat {
  uint16_t n;          // rains scored
  int32_t sumAbs;      // minutes off, summed
  int32_t sumErr;      // signed: + = guessed too late
  int32_t sumLead;     // how long before the end the first guess came
};
static EndStat endStats[RAIN_END_N];
static uint32_t endEst[RAIN_END_N];   // the current estimates (0 = none)
static struct {
  bool open, rained;
  uint32_t rainFrom;                  // first poll with rain
  uint32_t dryAt;                     // first poll without rain since
  uint32_t first[RAIN_END_N], firstAt[RAIN_END_N];
} endTrk;
static struct {
  uint32_t from, to;
  bool has[RAIN_END_N];
  int16_t err[RAIN_END_N];            // minutes, + = guessed too late
} lastRain;

static void saveEndStats() {
  nvs_handle_t h;
  if (nvs_open("wx", NVS_READWRITE, &h) != ESP_OK) return;
  nvs_set_blob(h, "endst", endStats, sizeof endStats);
  nvs_commit(h);
  nvs_close(h);
}

static void trackEnd(const RainAlert &a, const uint32_t est[RAIN_END_N], uint32_t now) {
  if (now < 1700000000) return;
  bool wetNow = a.raining || (a.watch && a.startUnix && a.startUnix <= now);
  bool coming = a.active || a.watch;
  if (!endTrk.open) {
    if (!wetNow && !coming) return;
    endTrk = {};
    endTrk.open = true;
  }
  if (wetNow || coming) {
    for (int s = 1; s < RAIN_END_N; s++) {
      if (!endTrk.first[s] && est[s] > now) {
        endTrk.first[s] = est[s];
        endTrk.firstAt[s] = now;
      }
    }
  }
  if (wetNow) {
    if (!endTrk.rained) endTrk.rainFrom = now;
    endTrk.rained = true;
    endTrk.dryAt = 0;
    return;
  }
  if (!endTrk.rained) {   // warned, no rain yet: nothing to score
    if (!coming) endTrk.open = false;
    return;
  }
  if (!endTrk.dryAt) endTrk.dryAt = now;
  if (now - endTrk.dryAt < 10 * 60) return;

  lastRain = {};
  lastRain.from = endTrk.rainFrom;
  lastRain.to = endTrk.dryAt;
  char line[160];
  int n = 0;
  for (int s = 1; s < RAIN_END_N; s++) {
    if (!endTrk.first[s]) continue;
    int err = (int)(((long)endTrk.first[s] - (long)endTrk.dryAt) / 60);
    int lead = endTrk.dryAt > endTrk.firstAt[s] ? (int)((endTrk.dryAt - endTrk.firstAt[s]) / 60) : 0;
    EndStat &st = endStats[s];
    if (st.n < 60000) {
      st.n++;
      st.sumAbs += abs(err);
      st.sumErr += err;
      st.sumLead += lead;
    }
    lastRain.has[s] = true;
    lastRain.err[s] = (int16_t)err;
    if (n < (int)sizeof line) n += snprintf(line + n, sizeof line - n, "%s%s %+d", n ? ", " : "", rainEndSrcName(s), err);
  }
  saveEndStats();
  endTrk.open = false;
  char c1[16], c2[16];
  fmtClock(c1, sizeof c1, lastRain.from, false);
  fmtClock(c2, sizeof c2, lastRain.to, false);
  logMsg("weather: rain %s-%s over; first end guesses off by (min): %s", c1, c2, n ? line : "no guesses");
}

// rainHome from Open-Meteo's nowcast and the minute-by-minute hours, after any
static void publishHome() {
  RainAlert a = omHome;
  mergeSources(&a, false);
  uint32_t now = (uint32_t)time(nullptr);
  // while it rains the nowcast's start is "now": keep the rain's real start
  if (a.raining && endTrk.open && endTrk.rained && endTrk.rainFrom < a.startUnix) a.startUnix = endTrk.rainFrom;
  fillEnd(&a, true);
  if (a.active || a.raining || a.watch) a.tier = rainTier(a);
  if (demoOn()) return;

  // every source's own end, for the tracker
  uint32_t est[RAIN_END_N] = {};
  if (a.active || a.raining || a.watch) {
    if (omHome.active || omHome.raining) est[RAIN_END_NOWCAST] = omHome.endUnix;
    if (owmFresh(false, now) && owmEndOk) est[RAIN_END_OWM] = owmEndLast;
    if (tioFresh(false, now) && tioEndOk) est[RAIN_END_TOMORROW] = tioEndLast;
    if (upwindFresh(now)) est[RAIN_END_UPWIND] = upwindEnd;
    if (a.startUnix) {
      est[RAIN_END_HOURLY] = endFromHourly(a.startUnix);
      int lo, hi;
      if (rainKindRange(a.kind, &lo, &hi)) est[RAIN_END_RANGE] = a.startUnix + (uint32_t)(lo + hi) * 30;
    }
  }
  memcpy(endEst, est, sizeof endEst);
  trackEnd(a, est, now);

  if (wxMutex) xSemaphoreTake(wxMutex, portMAX_DELAY);
  rainHome = a;
  if (wxMutex) xSemaphoreGive(wxMutex);
  wxDirty = true;
}

// Upwind probe: where the rain reaching home in the next 2 h is now
static void runUpwindProbe(char *buf, size_t cap) {
  char url[640];
  if (!homeNowcast->buildProbeUrl(url, sizeof url)) return;
  int status = 0;
  if (!httpGet(url, buf, cap, &status)) {
    char err[64];
    snprintf(err, sizeof err, "weather: upwind probe HTTP failed (%d)", status);
    logErrorOnce(ERR_HOME_HTTP, err);
    return;
  }
  budgetTotalCalls += NowcastEngine::N_PROBE;
  budgetHomeCalls += NowcastEngine::N_PROBE;
  uint32_t now = (uint32_t)time(nullptr), end = 0;
  int r = homeNowcast->processProbe(buf, now, rainHome.raining, &end);
  if (r == NowcastEngine::PROBE_BAD) {
    logErrorOnce(ERR_HOME_PARSE, "weather: upwind probe answer unusable");
    return;
  }
  upwindEnd = r == NowcastEngine::PROBE_END ? end : 0;
  upwindBeyond = r == NowcastEngine::PROBE_BEYOND;
  upwindAt = now;
  publishHome();
}

static void runHomeNowcast(char *buf, size_t cap) {
  char url[1024];
  homeNowcast->setLocation(homeLat, homeLon);
  if (!homeNowcast->buildUrl(url, sizeof(url))) return;

  int status = 0;
  if (!httpGet(url, buf, cap, &status)) {
    char err[64];
    snprintf(err, sizeof(err), "weather: home nowcast HTTP failed (%d)", status);
    logErrorOnce(ERR_HOME_HTTP, err);
    return;
  }
  clearError(ERR_HOME_HTTP);
  budgetTotalCalls += 17;
  budgetHomeCalls += 17;

  RainAlert alert = {};
  uint32_t cadence = 0;
  if (!homeNowcast->processResponse(buf, &alert, &cadence)) {
    logErrorOnce(ERR_HOME_PARSE, "weather: home nowcast process failed");
    return;
  }
  clearError(ERR_HOME_PARSE);
  // a hold counts only when the rain moved in the data: the same hourly
  // model fetched again every 5 min confirms nothing
  bool same = alert.startUnix == omHome.startUnix && alert.endUnix == omHome.endUnix && alert.mmh == omHome.mmh;
  omHome = alert;
  omHomeAt = (uint32_t)time(nullptr);
  if (!(alert.active || alert.raining)) omHomeWet = 0;
  else if (!same || !omHomeWet) omHomeWet = (uint8_t)(omHomeWet < 99 ? omHomeWet + 1 : 99);
  publishHome();
}

// "35 min", "1 h 10 min", "2 h"
static void fmtDur(char *out, size_t cap, long min) {
  if (min < 60) snprintf(out, cap, "%ld min", min);
  else if (min % 60 == 0 || min >= 600) snprintf(out, cap, "%ld h", (min + 30) / 60);
  else snprintf(out, cap, "%ld h %ld min", min / 60, min % 60);
}

// "2 d 6 h" for a day or more, else fmtDur
static void fmtLong(char *out, size_t cap, long sec) {
  long min = sec / 60;
  if (min < 24 * 60) fmtDur(out, cap, min);
  else snprintf(out, cap, "%ld d %ld h", min / 1440, (min % 1440) / 60);
}

// local "16:40", or "Tue 16:40"
static void fmtClock(char *out, size_t cap, uint32_t unixT, bool withDay) {
  static const char *DAYS[] = {"Sun", "Mon", "Tue", "Wed", "Thu", "Fri", "Sat"};
  struct tm t;
  if (!unixT || !boardLocalTimeAt((time_t)unixT, &t)) snprintf(out, cap, "--:--");
  else if (withDay) snprintf(out, cap, "%s %02d:%02d", DAYS[t.tm_wday], t.tm_hour, t.tm_min);
  else snprintf(out, cap, "%02d:%02d", t.tm_hour, t.tm_min);
}

// The rain's length for a post: "Lasts ~35 min (until ~14:40, upwind)",
// "Until ~14:40 (~25 min left, OpenWeather)", "Shower, usually 20-60 min
// (until ~14:20-15:00)", "Steady rain, no end in the 12 h forecast"
static int fmtLength(char *out, int cap, const RainAlert &a) {
  char dur[24], c1[16], c2[16];
  int lo, hi, n;
  uint32_t now = (uint32_t)time(nullptr);
  if (a.startUnix && a.endUnix) {
    fmtClock(c1, sizeof c1, a.endUnix, false);
    if (a.raining) {
      int left = rainLeftMin(a);
      fmtDur(dur, sizeof dur, left > 0 ? left : 0);
      n = snprintf(out, cap, "Until ~%s (~%s left, %s)", c1, dur, rainEndSrcName(a.endSrc));
    } else {
      fmtDur(dur, sizeof dur, (long)(a.endUnix - a.startUnix) / 60);
      n = snprintf(out, cap, "Lasts ~%s (until ~%s, %s)", dur, c1, rainEndSrcName(a.endSrc));
    }
  } else if (!a.startUnix) {
    n = snprintf(out, cap, "Length unknown (no clock yet)");
  } else if (rainKindRange(a.kind, &lo, &hi)) {
    const char *what = a.kind == RAIN_KIND_THUNDER ? "Thunderstorm" : "Shower";
    uint32_t e1 = a.startUnix + (uint32_t)lo * 60, e2 = a.startUnix + (uint32_t)hi * 60;
    if (e2 <= now) {
      n = snprintf(out, cap, "%s lasting longer than the usual %d-%d min; no end in sight", what, lo, hi);
    } else {
      fmtClock(c1, sizeof c1, e1 > now ? e1 : now, false);
      fmtClock(c2, sizeof c2, e2, false);
      n = snprintf(out, cap, "%s, usually %d-%d min (until ~%s-%s)", what, lo, hi, c1, c2);
    }
  } else {
    n = snprintf(out, cap, "Steady rain, no end in the 12 h forecast");
  }
  return n < cap ? n : cap - 1;
}

// Rain warnings to #weather-announcement (a watch posts nothing). Ringing
// (the place's priority, WEATHER_ALERT_PRIO through quiet hours): the first
// warning, the rain starting, the tier going up, and the ETA dropping inside
// WEATHER_RAIN_URGENT_MIN (one heads-up). Follow-ups (the start or end moving
// 20+ min, at most one per 30 min) go quietly: Pushover 0 by day, -1 from 22
// to 06. Cleared after 20 min with neither a warning nor a watch, so a source
// going blank for a while doesn't clear and re-warn. While you are away the
// warnings follow the phone; home's go out at -1 until you are back, when a
// home warning still out is posted again, ringing. Kept in NVS for 3 h: a
// restart doesn't post the same warning again.
struct RainWarn {
  WxTier tier;          // tier of the last post; NONE = no warning out
  bool raining;         // the last post said it rains now
  bool urgentPosted;    // the last post was inside WEATHER_RAIN_URGENT_MIN
  uint32_t startPosted; // rain start in that post
  uint32_t endPosted;   // rain end in that post
  uint32_t followUnix;  // last follow-up post
  uint32_t quietSince;  // first check with neither a warning nor a watch; 0 = one of them
};
static RainWarn warnHome, warnPhone;
static const uint32_t WARN_SHIFT_S = 20 * 60, WARN_FOLLOW_GAP_S = 30 * 60, WARN_CLEAR_S = 20 * 60;

// Follow-ups and all-clears: normal by day, quiet at night; a place already
// quiet (home while away) stays so
static int followPrio(int prio) {
  if (prio < 0) return prio;
  struct tm t;
  return boardLocalTime(&t) && (t.tm_hour >= 22 || t.tm_hour < 6) ? -1 : 0;
}

static void postRain(const char *title, const char *desc, uint32_t color, int prio) {
  discordPost(DC_WEATHER, title, desc, color, prio);
  logMsg("weather: warning posted: %s%s", title, prio < 0 ? " (quiet)" : prio == 0 ? " (no ring)" : "");
}

// true when warn changed (to save)
static bool rainWarnPlace(RainWarn &warn, const RainAlert &a, const char *place, int prio) {
  uint32_t now = (uint32_t)time(nullptr);
  if (a.active || a.raining || a.watch) warn.quietSince = 0;
  else if (!warn.quietSince) warn.quietSince = now;

  char title[112], desc[320];
  if (a.active) {
    int eta = rainEtaMin(a);
    bool urgent = eta <= WEATHER_RAIN_URGENT_MIN;
    bool fresh = warn.tier == TIER_NONE || warn.raining;   // nothing out, or new rain after the last
    bool rings = fresh || a.tier > warn.tier || (urgent && !warn.urgentPosted);
    if (!rings) {
      bool moved = a.startUnix && warn.startPosted &&
                   (uint32_t)labs((long)a.startUnix - (long)warn.startPosted) >= WARN_SHIFT_S;
      if (!moved || now - warn.followUnix < WARN_FOLLOW_GAP_S) return false;
      warn.followUnix = now;
    }
    snprintf(title, sizeof title, "%s in ~%d min | %s", wxTierName(a.tier), eta, place);
    int n = fmtLength(desc, sizeof desc, a);
    n += snprintf(desc + n, sizeof desc - n, "\n%.1f mm/h%s%s\n", a.mmh, a.from[0] ? ", moving in from " : "", a.from);
    if (n >= (int)sizeof desc) n = sizeof desc - 1;   // full: rainSrcLine gets 1 byte, not a wrapped size
    rainSrcLine(desc + n, sizeof desc - n, a);
    postRain(title, desc, urgent ? COL_RED : COL_YELLOW, rings ? prio : followPrio(prio));
    warn.tier = a.tier;
    warn.raining = false;
    warn.urgentPosted = urgent;
    warn.startPosted = a.startUnix;
    return true;
  }
  if (a.raining) {
    bool rings = !warn.raining || a.tier > warn.tier;
    if (!rings) {
      uint32_t shift = (uint32_t)labs((long)a.endUnix - (long)warn.endPosted);
      bool endKnownChanged = (a.endUnix == 0) != (warn.endPosted == 0);
      if ((!endKnownChanged && shift < WARN_SHIFT_S) || now - warn.followUnix < WARN_FOLLOW_GAP_S) return false;
      warn.followUnix = now;
    }
    snprintf(title, sizeof title, "%s now | %s", wxTierName(a.tier), place);
    int n = fmtLength(desc, sizeof desc, a);
    n += snprintf(desc + n, sizeof desc - n, "\n%.1f mm/h\n", a.mmh);
    if (n >= (int)sizeof desc) n = sizeof desc - 1;
    rainSrcLine(desc + n, sizeof desc - n, a);
    postRain(title, desc, COL_RED, rings ? prio : followPrio(prio));
    warn.tier = a.tier;
    warn.raining = true;
    warn.endPosted = a.endUnix;
    return true;
  }
  if (warn.tier != TIER_NONE && warn.quietSince && now - warn.quietSince >= WARN_CLEAR_S) {
    snprintf(title, sizeof title, "Weather Warning Cleared | %s", place);
    snprintf(desc, sizeof desc, "%s", warn.raining ? "The rain is over." : "The rain is no longer expected.");
    discordPost(DC_WEATHER, title, desc, COL_GREEN, followPrio(prio));
    logMsg("weather: warning cleared (%s)", place);
    warn = {};
    return true;
  }
  return false;
}

static bool phoneAway() {
  return owntracksEnabled() && owntracksValid() && !owntracksIsMerged(homeLat, homeLon);
}

static void loadWarnState();
static void saveWarnState();

static void rainWarnTick() {
  if (demoOn()) return;
  static bool loaded, wasAway;
  if (!loaded) {   // the saved state needs the clock to judge its age
    time_t t;
    if (!clockValid(&t)) return;
    loadWarnState();
    loaded = true;
  }
  bool away = phoneAway();   // this task is the only writer of rainHome / rainPhone
  bool changed = false;
  if (away) {
    changed |= rainWarnPlace(warnPhone, rainPhone, "where you are", WEATHER_ALERT_PRIO);
  } else if (warnPhone.tier != TIER_NONE || warnPhone.quietSince) {
    warnPhone = {};   // back home: home's warnings take over
    changed = true;
  }
  if (wasAway && !away && warnHome.tier != TIER_NONE) {
    warnHome = {};    // posted quietly while away: once more, ringing
    changed = true;
  }
  wasAway = away;
  if (!cyclone_.active)   // a storm here: its own posts cover home
    changed |= rainWarnPlace(warnHome, rainHome, homeName, away ? -1 : WEATHER_ALERT_PRIO);
  if (changed) saveWarnState();
}

// Storm posts (typhoon, or tropical storm at follow-up priority): one per GDACS
// advisory while it is more than 6 h out; in the last 6 h one on entering,
// one on turning imminent, else every 30 min or when the arrival moves 30+
// min; hourly while it is here; "cleared" after. A typhoon's first post and
// its imminent one ring, the rest follow quietly (followPrio).
struct StormWarn {
  uint32_t eventId;        // storm the posts are about
  char name[20];
  bool storm;              // a tropical storm, not a typhoon
  uint32_t episodePosted;  // advisory of the last "heading here" post
  uint32_t nearPostUnix, nearArrivePosted, activePostUnix;
  bool warned, activePosted, nearPosted, imminentPosted;
};
static StormWarn ty;

struct WarnSave {
  uint32_t version, at;
  RainWarn home, phone;
  StormWarn storm;
};

static void saveWarnState() {
  WarnSave w = {};
  w.version = sizeof(WarnSave);
  w.at = (uint32_t)time(nullptr);
  w.home = warnHome;
  w.phone = warnPhone;
  w.storm = ty;
  nvs_handle_t h;
  if (nvs_open("wx", NVS_READWRITE, &h) != ESP_OK) return;
  nvs_set_blob(h, "warn", &w, sizeof w);
  nvs_commit(h);
  nvs_close(h);
}

static void loadWarnState() {
  WarnSave w = {};
  size_t len = sizeof w;
  nvs_handle_t h;
  if (nvs_open("wx", NVS_READONLY, &h) != ESP_OK) return;
  esp_err_t e = nvs_get_blob(h, "warn", &w, &len);
  nvs_close(h);
  uint32_t now = (uint32_t)time(nullptr);
  if (e != ESP_OK || len != sizeof w || w.version != sizeof w || now - w.at > 3 * 3600) return;
  warnHome = w.home;
  warnPhone = w.phone;
  ty = w.storm;
  if (warnHome.tier != TIER_NONE || warnPhone.tier != TIER_NONE || ty.warned)
    logMsg("weather: warnings out before the restart kept (no second post)");
}

static void cycloneTick() {
  time_t now;
  if (!tracks_ || !clockValid(&now) || demoOn()) return;
  Cyclone best = {};
  int bestIdx = -1;
  for (int i = 0; i < MAX_TRACKS; i++) {
    if (!tracks_[i].n) continue;
    Cyclone c;
    cycloneJudge(tracks_[i], homeLat, homeLon, now, &c);
    if (!c.tracked) continue;
    bool better = bestIdx < 0 || (c.active && !best.active) ||
                  (!c.active && !best.active && c.arriveUnix < best.arriveUnix);
    if (better) {
      best = c;
      bestIdx = i;
    }
  }
  bool changed = best.tracked != cyclone_.tracked || best.active != cyclone_.active;
  if (wxMutex) xSemaphoreTake(wxMutex, portMAX_DELAY);
  cyclone_ = best;
  trackShown = bestIdx;
  if (wxMutex) xSemaphoreGive(wxMutex);
  if (changed) wxDirty = true;

  char title[112], desc[200], when[24], clk[24];
  uint32_t nowU = (uint32_t)now;
  const char *kind = best.superTyphoon ? "Super Typhoon" : best.tropicalStorm ? "Tropical Storm" : "Typhoon";
  int ring = best.tropicalStorm ? followPrio(0) : WEATHER_ALERT_PRIO;
  if (bestIdx >= 0) {
    const CycloneTrack &tr = tracks_[bestIdx];
    if (ty.eventId != tr.eventId) {
      ty = {};
      ty.eventId = tr.eventId;
      snprintf(ty.name, sizeof ty.name, "%s", tr.name);
    }
    ty.storm = best.tropicalStorm;
    if (best.active) {
      if (ty.activePosted && nowU - ty.activePostUnix < 3600) return;
      snprintf(title, sizeof title, "%s %s Active | %s", kind, best.name, homeName);
      snprintf(desc, sizeof desc, "Centre ~%u km away, peak wind %u km/h", best.distKm, best.windKmh);
      discordPost(DC_WEATHER, title, desc, COL_RED, ty.activePosted ? followPrio(0) : ring);
      ty.activePosted = ty.warned = true;
      ty.activePostUnix = nowU;
    } else {
      long left = (long)best.arriveUnix - (long)now;
      fmtLong(when, sizeof when, left > 0 ? left : 0);
      fmtClock(clk, sizeof clk, best.arriveUnix, true);
      if (left <= WEATHER_TYPHOON_NEAR_S) {
        bool imminent = left <= WEATHER_TYPHOON_IMMINENT_S;
        bool rings = !ty.nearPosted || (imminent && !ty.imminentPosted);
        bool moved = (uint32_t)labs((long)best.arriveUnix - (long)ty.nearArrivePosted) >= 30 * 60;
        if (!rings && !moved && nowU - ty.nearPostUnix < 30 * 60) return;
        snprintf(title, sizeof title, "%s %.19s in ~%s | %.40s", kind, best.name, when, homeName);
        snprintf(desc, sizeof desc, "Arrives ~%s, closest ~%u km\nPeak wind %u km/h", clk, best.closestKm, best.windKmh);
        discordPost(DC_WEATHER, title, desc, imminent ? COL_RED : COL_YELLOW, rings ? ring : followPrio(0));
        ty.nearPosted = true;
        ty.imminentPosted |= imminent;
        ty.nearPostUnix = nowU;
        ty.nearArrivePosted = best.arriveUnix;
      } else {
        if (ty.episodePosted == tr.episodeId) return;
        snprintf(title, sizeof title, "%s %s heading for %s", kind, best.name, homeName);
        snprintf(desc, sizeof desc, "Arrives ~%s (in ~%s), closest ~%u km\nPeak wind %u km/h (GDACS advisory %u)", clk,
                 when, best.closestKm, best.windKmh, (unsigned)tr.episodeId);
        discordPost(DC_WEATHER, title, desc, COL_YELLOW, ty.warned ? followPrio(0) : ring);
        ty.episodePosted = tr.episodeId;
        logMsg("weather: %s", title);
      }
      ty.warned = true;
    }
    saveWarnState();
  } else if (ty.warned) {
    snprintf(title, sizeof title, "Weather Warning Cleared | %s", homeName);
    snprintf(desc, sizeof desc, ty.activePosted ? "%s %s has passed." : "%s %s is no longer heading here.",
             ty.storm ? "Tropical storm" : "Typhoon", ty.name);
    discordPost(DC_WEATHER, title, desc, COL_GREEN, followPrio(0));
    logMsg("weather: storm %s cleared", ty.name);
    ty = {};
    saveWarnState();
  }
}

// Current cyclones from GDACS; a nearby storm's track is fetched again only
// when GDACS publishes a new advisory for it (about every 6 h)
static void pollCyclones(char *buf, size_t cap) {
  time_t now;
  if (!clockValid(&now)) return;
  if (!tracks_) tracks_ = (CycloneTrack *)heap_caps_calloc(MAX_TRACKS, sizeof(CycloneTrack), MALLOC_CAP_SPIRAM);
  if (!tracks_) return;

  char url[200];
  cycloneListUrl(url, sizeof url, now);
  int status = 0;
  if (!httpGet(url, buf, cap, &status)) {
    char err[64];
    snprintf(err, sizeof err, "weather: GDACS list HTTP failed (%d)", status);
    logErrorOnce(ERR_TC_HTTP, err);
    return;
  }
  clearError(ERR_TC_HTTP);
  CycloneCandidate cand[MAX_TRACKS];
  int n = cycloneParseList(buf, homeLat, homeLon, cand, MAX_TRACKS);

  // tracks_ changes under wxMutex: `weather show` reads it on the main loop
  if (wxMutex) xSemaphoreTake(wxMutex, portMAX_DELAY);
  for (int i = 0; i < MAX_TRACKS; i++) {   // storms no longer listed (or no longer near)
    bool listed = false;
    for (int k = 0; k < n; k++) listed |= tracks_[i].eventId == cand[k].eventId;
    if (!listed) memset(&tracks_[i], 0, sizeof(CycloneTrack));
  }
  if (wxMutex) xSemaphoreGive(wxMutex);
  for (int k = 0; k < n; k++) {
    int slot = -1, freeSlot = -1;
    for (int i = 0; i < MAX_TRACKS; i++) {
      if (tracks_[i].eventId == cand[k].eventId) slot = i;
      else if (!tracks_[i].eventId && freeSlot < 0) freeSlot = i;
    }
    if (slot >= 0 && tracks_[slot].episodeId == cand[k].episodeId) continue;   // have this advisory
    int dst = slot >= 0 ? slot : freeSlot;
    if (dst < 0) continue;
    // ~350 KB of GeoJSON: a PSRAM buffer just for this fetch, the parsed track after it
    const size_t bigCap = 1024 * 1024;
    char *big = (char *)heap_caps_malloc(bigCap + sizeof(CycloneTrack), MALLOC_CAP_SPIRAM);
    if (!big) continue;
    CycloneTrack *fresh = (CycloneTrack *)(big + bigCap);
    cycloneTrackUrl(url, sizeof url, cand[k].eventId, cand[k].episodeId);
    bool got = httpGet(url, big, bigCap, &status, 30000);
    size_t len = strlen(big);
    // outside wxMutex: the scan takes long enough to hold the main loop's frames up.
    // A failed parse leaves the old track, and the next poll tries this advisory again
    bool parsed = got && cycloneParseTrack(big, len, cand[k], now, fresh);
    if (parsed) {
      if (wxMutex) xSemaphoreTake(wxMutex, portMAX_DELAY);
      tracks_[dst] = *fresh;
      if (wxMutex) xSemaphoreGive(wxMutex);
      clearError(ERR_TC_TRACK);
      logMsg("weather: cyclone %s: %d track points from %u KB, advisory %u, %.0f km away", tracks_[dst].name,
             tracks_[dst].n, (unsigned)(len / 1024), (unsigned)cand[k].episodeId,
             cycloneDistKm(homeLat, homeLon, cand[k].lat, cand[k].lon));
    } else {
      char err[96];
      snprintf(err, sizeof err, "weather: GDACS track for %s failed (HTTP %d, %s, %u KB)", cand[k].name, status,
               esp_err_to_name(lastHttpErr), (unsigned)(len / 1024));
      logErrorOnce(ERR_TC_TRACK, err);
    }
    heap_caps_free(big);
  }
}

static const char *iconWord(WxIcon i) {
  switch (i) {
    case WX_CLEAR: return "clear";
    case WX_PARTLY: return "partly cloudy";
    case WX_CLOUDY: return "cloudy";
    case WX_FOG: return "fog";
    case WX_DRIZZLE: return "drizzle";
    case WX_RAIN: return "rain";
    case WX_SHOWERS: return "showers";
    case WX_SNOW: return "snow";
    case WX_STORM: return "thunderstorms";
  }
  return "";
}

// Weather update to #weather-announcement every 2 h from 06:00 to 20:00; the
// 06:00 one adds the 3-day forecast. The slot is kept in NVS so a reboot in
// the same hour does not post it twice.
static void postWeatherUpdate(char *buf, size_t cap) {
  struct tm t;
  if (!now_.valid || !boardLocalTime(&t)) return;
  if (t.tm_hour < WEATHER_SUMMARY_FIRST_HOUR || t.tm_hour > WEATHER_SUMMARY_LAST_HOUR || (t.tm_hour & 1)) return;
  if (!forecastAtMs || nowMs() - forecastAtMs > 10 * 60 * 1000) return;   // wait for fresh data
  uint32_t slot = (uint32_t)(t.tm_year + 1900) * 10000 + t.tm_yday * 24 + t.tm_hour;
  static uint32_t posted;
  nvs_handle_t h;
  if (!posted && nvs_open("wx", NVS_READONLY, &h) == ESP_OK) {
    nvs_get_u32(h, "upd_slot", &posted);
    nvs_close(h);
  }
  if (posted == slot) return;
  posted = slot;
  if (nvs_open("wx", NVS_READWRITE, &h) == ESP_OK) {
    nvs_set_u32(h, "upd_slot", slot);
    nvs_commit(h);
    nvs_close(h);
  }

  // where you are: the phone's location while it is away from home (a valid
  // OwnTracks fix), else home
  WeatherNow w = {};
  bool onPhone = false;
  if (owntracksEnabled() && owntracksValid() && !owntracksIsMerged(homeLat, homeLon)) {
    double pLat, pLon;
    owntracksGetLocation(&pLat, &pLon, nullptr, nullptr);
    onPhone = fetchNowAt(pLat, pLon, buf, cap, &w);
    if (!onPhone) logMsg("weather: 2-hourly update: phone forecast failed, home instead");
  }
  if (!onPhone) {
    if (wxMutex) xSemaphoreTake(wxMutex, portMAX_DELAY);
    w = now_;
    if (wxMutex) xSemaphoreGive(wxMutex);
  }
  char desc[480], clk[16];
  int n = snprintf(desc, sizeof desc, "%.0f\u00b0 (%d\u00b0 / %d\u00b0), %s\nWind %.0f km/h", (double)w.temp, w.tmax, w.tmin,
                   iconWord(w.icon), w.windKmh);
  if (w.aqi >= 0 && n < (int)sizeof desc) n += snprintf(desc + n, sizeof desc - n, ", AQI %d", w.aqi);
  if (n >= (int)sizeof desc) n = sizeof desc - 1;   // a wild API number (%.0f of 1e300): cut, never past desc
  const RainAlert &r = onPhone ? rainPhone : rainHome;
  if (r.raining) {
    fmtClock(clk, sizeof clk, r.endUnix, false);
    n += snprintf(desc + n, sizeof desc - n, r.endUnix ? "\n%s now, until ~%s" : "\n%s now", wxTierName(r.tier), clk);
  } else if (r.active) {
    n += snprintf(desc + n, sizeof desc - n, "\n%s in ~%d min", wxTierName(r.tier), rainEtaMin(r));
  } else if (r.watch) {
    // one source alone, light or far off: said, not warned about
    fmtClock(clk, sizeof clk, r.startUnix, false);
    if (r.startUnix <= (uint32_t)time(nullptr) + 60) strcpy(clk, "now");
    n += snprintf(desc + n, sizeof desc - n, "\n%s possible %s%s (%s only)", wxTierName(r.tier),
                  strcmp(clk, "now") ? "from ~" : "", clk, rainSrcName(r));
  } else {
    n += snprintf(desc + n, sizeof desc - n, "\nNo rain in the next hour and a half");
  }
  if (cyclone_.tracked && n < (int)sizeof desc) {
    if (cyclone_.active) {
      n += snprintf(desc + n, sizeof desc - n, "\n%s %s active", cyclone_.tropicalStorm ? "Tropical storm" : "Typhoon", cyclone_.name);
    } else {
      fmtClock(clk, sizeof clk, cyclone_.arriveUnix, true);
      n += snprintf(desc + n, sizeof desc - n, "\n%s %s expected ~%s", cyclone_.tropicalStorm ? "Tropical storm" : "Typhoon", cyclone_.name, clk);
    }
  }
  if (t.tm_hour == WEATHER_MORNING_HOUR) {
    for (int i = 0; i < 3 && n < (int)sizeof desc; i++)
      if (w.days[i].name[0])
        n += snprintf(desc + n, sizeof desc - n, "\n%s: %d\u00b0 / %d\u00b0, %s", w.days[i].name, w.days[i].tmax,
                      w.days[i].tmin, iconWord(w.days[i].icon));
  }
  char title[96];
  if (onPhone)
    snprintf(title, sizeof title, "Currently where you are (%.0f km from home) | %02d:%02d",
             owntracksDistanceTo(homeLat, homeLon), t.tm_hour, t.tm_min);
  else
    snprintf(title, sizeof title, "Currently in %s | %02d:%02d", w.place[0] ? w.place : WEATHER_HOME_NAME, t.tm_hour, t.tm_min);
  discordPost(DC_WEATHER, title, desc, COL_BLUE, -1);   // routine: quiet on the phone
  logMsg("weather: update posted (%02d:%02d)", t.tm_hour, t.tm_min);
}

static void publishPhone();

static void runPhoneNowcast(char *buf, size_t cap) {
  char url[1024];
  if (!phoneNowcast->buildUrl(url, sizeof(url))) return;

  int status = 0;
  if (!httpGet(url, buf, cap, &status)) {
    char err[64];
    snprintf(err, sizeof(err), "weather: phone nowcast HTTP failed (%d)", status);
    logErrorOnce(ERR_PHONE_HTTP, err);
    return;
  }
  clearError(ERR_PHONE_HTTP);
  budgetTotalCalls += 17;
  budgetPhoneCalls += 17;

  RainAlert alert = {};
  uint32_t cadence = 0;
  if (!phoneNowcast->processResponse(buf, &alert, &cadence)) {
    logErrorOnce(ERR_PHONE_PARSE, "weather: phone nowcast process failed");
    return;
  }
  clearError(ERR_PHONE_PARSE);
  bool same = alert.startUnix == omPhone.startUnix && alert.endUnix == omPhone.endUnix && alert.mmh == omPhone.mmh;
  omPhone = alert;
  omPhoneAt = (uint32_t)time(nullptr);
  if (!(alert.active || alert.raining)) omPhoneWet = 0;
  else if (!same || !omPhoneWet) omPhoneWet = (uint8_t)(omPhoneWet < 99 ? omPhoneWet + 1 : 99);
  publishPhone();
}

// rainPhone from both sources (rainWarnTick warns for it while you are away)
static void publishPhone() {
  RainAlert alert = omPhone;
  mergeSources(&alert, true);
  fillEnd(&alert, false);
  if (alert.active || alert.raining || alert.watch) alert.tier = rainTierMm(alert.mmh);
  if (wxMutex) xSemaphoreTake(wxMutex, portMAX_DELAY);
  rainPhone = alert;
  if (wxMutex) xSemaphoreGive(wxMutex);

}

bool weatherHomeLocation(double *lat, double *lon) {
  if (!homeConfigured) return false;
  *lat = homeLat;
  *lon = homeLon;
  return true;
}

static void setHomeLocation(double lat, double lon, const char *name) {
  homeLat = lat;
  homeLon = lon;
  snprintf(homeName, sizeof(homeName), "%s", name ? name : WEATHER_HOME_NAME);
  homeConfigured = true;

  nvs_handle_t h;
  if (nvs_open("wx", NVS_READWRITE, &h) == ESP_OK) {
    char latStr[24], lonStr[24];
    snprintf(latStr, sizeof(latStr), "%.5f", lat);
    snprintf(lonStr, sizeof(lonStr), "%.5f", lon);
    nvs_set_str(h, "home_lat", latStr);
    nvs_set_str(h, "home_lon", lonStr);
    nvs_set_str(h, "home_name", homeName);
    nvs_commit(h);
    nvs_close(h);
  }

  homeChanged = true;
  if (wxTaskHandle) xTaskNotifyGive(wxTaskHandle);
}

static void loadNvsConfig() {
  nvs_handle_t h;
  if (nvs_open("wx", NVS_READONLY, &h) == ESP_OK) {
    char latStr[24] = {0}, lonStr[24] = {0}, nameStr[48] = {0};
    size_t len = sizeof(latStr);
    if (nvs_get_str(h, "home_lat", latStr, &len) == ESP_OK) {
      len = sizeof(lonStr);
      if (nvs_get_str(h, "home_lon", lonStr, &len) == ESP_OK) {
        homeLat = strtod(latStr, nullptr);
        homeLon = strtod(lonStr, nullptr);
        homeConfigured = true;
        len = sizeof(nameStr);
        if (nvs_get_str(h, "home_name", nameStr, &len) == ESP_OK) {
          snprintf(homeName, sizeof(homeName), "%s", nameStr);
        }
      }
    }

    // the clock is usually unset at boot: restore the saved day's counts and
    // let the day check in checkBudgetNowcast reset them if the day moved on
    uint32_t savedDay = 0;
    if (nvs_get_u32(h, "b_day", &savedDay) == ESP_OK) {
      currentUtcDay = savedDay;
      nvs_get_u32(h, "b_tot", &budgetTotalCalls);
      nvs_get_u32(h, "b_home", &budgetHomeCalls);
      nvs_get_u32(h, "b_phone", &budgetPhoneCalls);
      nvs_get_u32(h, "b_fc", &budgetFcCalls);
    }
    size_t esLen = sizeof endStats;
    // a shorter blob is from before a slot was added at the end: the rest stay 0
    if (nvs_get_blob(h, "endst", endStats, &esLen) != ESP_OK || esLen % sizeof(EndStat)) memset(endStats, 0, sizeof endStats);
    nvs_close(h);
  }
}

// A weather alert OpenWeather names for the first time: its details once, to
// #weather-announcement (one alert call per poll at most)
static void owmAlertsTick(char *buf, size_t cap) {
  for (int i = 0; i < owmLast.nAlerts; i++) {
    const char *id = owmLast.alerts[i];
    bool seen = false;
    for (auto &s : owmSeen) seen = seen || !strcmp(s, id);
    if (seen) continue;
    OwmAlert al;
    if (!owmFetchAlert(id, buf, cap, &al)) return;   // budget or error: next poll
    snprintf(owmSeen[owmSeenNext], sizeof owmSeen[0], "%s", id);
    owmSeenNext = (owmSeenNext + 1) % 8;
    char title[112], desc[320], s[24], e[24];
    fmtClock(s, sizeof s, al.startUnix, true);
    fmtClock(e, sizeof e, al.endUnix, true);
    snprintf(title, sizeof title, "%.60s | %s", al.event, owmOnPhone ? "where you are" : homeName);
    snprintf(desc, sizeof desc, "%s to %s%s%.48s\n%.200s", s, e, al.sender[0] ? ", from " : "", al.sender, al.text);
    discordPost(DC_WEATHER, title, desc, COL_RED, WEATHER_ALERT_PRIO);
    logMsg("weather: OpenWeather alert posted: %s", al.event);
    return;
  }
}

static void owmTick(char *buf, size_t cap, bool force, uint32_t *lastMs, uint32_t curMs) {
  bool onPhone = owntracksEnabled() && owntracksValid() && !owntracksIsMerged(homeLat, homeLon);
  double lat = homeLat, lon = homeLon;
  if (onPhone) owntracksGetLocation(&lat, &lon, nullptr, nullptr);
  const RainAlert &t = onPhone ? rainPhone : rainHome;
  uint32_t now = (uint32_t)time(nullptr);
  bool alertNow = owmLast.valid && owmLast.nAlerts && now - owmLast.fetchedUnix < 10 * 60;
  uint32_t every = (t.active || t.raining || t.watch || alertNow) ? OWM_POLL_RAIN_MS : OWM_POLL_MS;
  // moved: the new place right away, once. A failed fetch there leaves owmOnPhone
  // as it was, so without owmTriedPhone every pass forced another counted call
  // and the day's budget was gone by noon
  static int8_t owmTriedPhone = -1;
  if (onPhone != owmOnPhone && owmTriedPhone != (int8_t)onPhone) force = true;
  if (!force && *lastMs && curMs - *lastMs < every) return;
  if (!owmBudgetLeft()) return;
  *lastMs = curMs;
  owmTriedPhone = (int8_t)onPhone;
  OwmMinutely m;
  static bool retried;   // one quick retry per failure spell
  if (!owmFetchMinutely(lat, lon, buf, cap, &m)) {
    char err[160];
    snprintf(err, sizeof err, "weather: OpenWeather: %s", owmLastError());
    logErrorOnce(ERR_OWM, err);
    owmFailUnix = (uint32_t)time(nullptr);
    if (!retried) {   // the empty spells are often one answer long: again in 30 s
      retried = true;
      *lastMs = curMs - every + 30 * 1000;
    }
    return;
  }
  retried = false;
  clearError(ERR_OWM);
  bool moved = onPhone != owmOnPhone;
  OwmRain o;
  bool sees = owmRainSummary(m, (uint32_t)time(nullptr), &o) && o.sees;
  owmWet = !sees ? 0 : moved ? 1 : (uint8_t)(owmWet < 99 ? owmWet + 1 : 99);
  uint32_t prevEnd = moved ? 0 : owmEndLast;
  owmEndLast = sees ? o.endUnix : 0;
  owmEndOk = owmEndLast && prevEnd && labs((long)owmEndLast - (long)prevEnd) <= 5 * 60;
  owmLast = m;
  owmOnPhone = onPhone;
  publishHome();                        // home gains or loses OpenWeather
  if (onPhone || moved) publishPhone();
  owmAlertsTick(buf, cap);
}

// RainViewer's newest frame for the same place as OpenWeather's. Every 10 min
// (a frame's cadence), every 5 while an echo is within 30 km or rain is near
static void radarTick(char *buf, size_t cap, bool force, uint32_t *lastMs, uint32_t curMs) {
  bool onPhone = owntracksEnabled() && owntracksValid() && !owntracksIsMerged(homeLat, homeLon);
  double lat = homeLat, lon = homeLon;
  if (onPhone) owntracksGetLocation(&lat, &lon, nullptr, nullptr);
  const RainAlert &t = onPhone ? rainPhone : rainHome;
  bool near = radarLast.valid && radarLast.nearKm >= 0 && radarLast.nearKm <= 30;
  uint32_t every = (t.active || t.raining || t.watch || near) ? RADAR_POLL_MS : RADAR_POLL_DRY_MS;
  if (onPhone != radarOnPhone) force = true;
  if (!force && *lastMs && curMs - *lastMs < every) return;
  *lastMs = curMs;
  RadarObs o;
  if (!radarFetch(lat, lon, buf, cap, &o)) {
    char err[96];
    snprintf(err, sizeof err, "weather: radar: %s", radarLastError());
    logErrorOnce(ERR_RADAR, err);
    *lastMs = curMs - every + 60 * 1000;   // again in a minute
    if (onPhone != radarOnPhone) radarLast.valid = false;   // the old place's frame says nothing here
    return;
  }
  clearError(ERR_RADAR);
  bool moved = onPhone != radarOnPhone;
  // the nearest echo closer than on the last frame: rain moving in, not a
  // standing echo (ground clutter sat at 14 km for hours, 2026-11-02)
  if (moved || !radarLast.valid) radarApproaching = false;
  else if (o.frameUnix != radarLast.frameUnix)
    radarApproaching = o.nearKm >= 0 && radarLast.nearKm >= 0 && o.nearKm <= radarLast.nearKm - 2;
  radarLast = o;
  radarOnPhone = onPhone;
  bool wet = radarRainingHere(o);
  if (wet != radarWasWet || moved) {
    char clk[16];
    fmtClock(clk, sizeof clk, o.frameUnix, false);
    if (wet)
      logMsg("weather: radar: rain at %s, %d dBZ (~%.1f mm/h) on %u px, frame %s", onPhone ? "the phone" : "home",
             o.dbzHere, o.mmhHere, (unsigned)o.pxHere, clk);
    else if (radarWasWet && !moved)
      logMsg("weather: radar: dry at %s again, frame %s", onPhone ? "the phone" : "home", clk);
    radarWasWet = wet;
  }
  publishHome();
  if (onPhone || moved) publishPhone();
}

// Tomorrow.io's hour for the same place as OpenWeather's: every 6 min, every 3
// while rain is near or falling there. 240 calls a dry day, 480 at most
static void tioTick(char *buf, size_t cap, bool force, uint32_t *lastMs, uint32_t curMs) {
  bool onPhone = owntracksEnabled() && owntracksValid() && !owntracksIsMerged(homeLat, homeLon);
  double lat = homeLat, lon = homeLon;
  if (onPhone) owntracksGetLocation(&lat, &lon, nullptr, nullptr);
  const RainAlert &t = onPhone ? rainPhone : rainHome;
  bool near = radarLast.valid && radarLast.nearKm >= 0 && radarLast.nearKm <= 30;
  uint32_t every = (t.active || t.raining || t.watch || near) ? TOMORROW_POLL_RAIN_MS : TOMORROW_POLL_MS;
  // moved: the new place right away, once (owmTick has the why)
  static int8_t tioTriedPhone = -1;
  if (onPhone != tioOnPhone && tioTriedPhone != (int8_t)onPhone) force = true;
  if (!force && *lastMs && curMs - *lastMs < every) return;
  if (!tioBudgetLeft()) return;
  *lastMs = curMs;
  tioTriedPhone = (int8_t)onPhone;
  OwmMinutely m;
  static bool retried;   // one quick retry per failure spell
  if (!tioFetchMinutely(lat, lon, buf, cap, &m)) {
    char err[96];
    snprintf(err, sizeof err, "weather: Tomorrow.io: %s", tioLastError());
    logErrorOnce(ERR_TOMORROW, err);
    if (!retried) {   // again in a minute, inside tioFresh's window
      retried = true;
      *lastMs = curMs - every + 60 * 1000;
    }
    return;
  }
  retried = false;
  clearError(ERR_TOMORROW);
  bool moved = onPhone != tioOnPhone;
  OwmRain o;
  bool sees = owmRainSummary(m, (uint32_t)time(nullptr), &o, TOMORROW_RAIN_MMH) && o.sees;
  tioWet = !sees ? 0 : moved ? 1 : (uint8_t)(tioWet < 99 ? tioWet + 1 : 99);
  uint32_t prevEnd = moved ? 0 : tioEndLast;
  tioEndLast = sees ? o.endUnix : 0;
  tioEndOk = tioEndLast && prevEnd && labs((long)tioEndLast - (long)prevEnd) <= 5 * 60;
  tioLast = m;
  tioOnPhone = onPhone;
  publishHome();
  if (onPhone || moved) publishPhone();
}

// The demo's end, `weather clear` and `weather home`, in the task that owns
// the data and the warnings
static void weatherTaskHousekeeping() {
  if (homeReq.set) {
    homeReq.set = false;
    setHomeLocation(homeReq.lat, homeReq.lon, homeReq.name);
  }
  if (endResetReq) {
    endResetReq = false;
    memset(endStats, 0, sizeof endStats);
    saveEndStats();
    logMsg("weather: rain-end accuracy stats cleared");
  }
  if (demoSaved && !demoOn()) {
    if (wxMutex) xSemaphoreTake(wxMutex, portMAX_DELAY);
    now_ = demoSavedNow;
    rainHome = demoSavedHome;
    cyclone_ = demoSavedCyclone;
    demoSaved = false;
    if (wxMutex) xSemaphoreGive(wxMutex);
    wxDirty = true;
    logMsg("weather: demo over, real data back");
  }
  if (clearReq) {
    clearReq = false;
    if (wxMutex) xSemaphoreTake(wxMutex, portMAX_DELAY);
    now_ = {};
    rainHome = {};
    rainPhone = {};
    cyclone_ = {};
    demoUntilMs = 0;
    demoSaved = false;
    if (wxMutex) xSemaphoreGive(wxMutex);
    warnHome = {};   // no "Cleared" post for a warning nobody saw end
    warnPhone = {};
    wxDirty = true;
    logMsg("weather: cleared");
  }
}

static void weatherTask(void *) {
  size_t httpBufCap = 48 * 1024;
  char *httpBuf = (char *)heap_caps_malloc(httpBufCap, MALLOC_CAP_SPIRAM | MALLOC_CAP_8BIT);
  if (!httpBuf) {
    httpBufCap = 32 * 1024;
    httpBuf = (char *)malloc(httpBufCap);
  }

  uint32_t lastForecastMs = 0;
  uint32_t lastAqiMs = 0;
  uint32_t lastCycloneMs = 0;
  uint32_t lastJudgeMs = 0;
  uint32_t lastHomeNowcastMs = 0;
  uint32_t lastPhoneNowcastMs = 0;
  uint32_t lastOwmMs = 0;
  uint32_t lastRadarMs = 0;
  uint32_t lastTioMs = 0;
  uint32_t lastUpwindMs = 0;
  uint32_t lastNvsSaveMs = nowMs();
  bool prevNetUp = false;
  uint32_t netUpMs = 0;
  bool forceImmediate = false;

  for (;;) {
    ulTaskNotifyTake(pdTRUE, pdMS_TO_TICKS(1000));

    bool currentNet = netUp();
    if ((currentNet && !prevNetUp) || homeChanged) {
      homeChanged = false;
      forceImmediate = true;
    }
    if (currentNet && !prevNetUp) netUpMs = nowMs();
    prevNetUp = currentNet;

    // After Wi-Fi comes up, let Discord's TLS handshakes finish first (or
    // 30 s): handshakes running side by side left ~3 KB internal RAM at boot
    if (currentNet && !discordUp() && nowMs() - netUpMs < 30000) continue;

    if (currentNet && testAlertPending) {
      testAlertPending = false;
      const char *testMsg = "Rain at your location in ~25 min (2.5 mm/h, from NW) [TEST]";
      discordPost(DC_WEATHER, "Rain soon where you are", testMsg, 0x3498DB, WEATHER_ALERT_PRIO);
      logMsg("weather: test-alert sent");
    }
    if (currentNet) pushoverService();
    // before the check below: the first `weather home` is what sets homeConfigured
    weatherTaskHousekeeping();

    if (!currentNet || !homeConfigured || !httpBuf) {
      continue;
    }

    uint32_t curMs = nowMs();

    // 1. Forecast every 5 min, air quality every 30, both at once on Wi-Fi
    // connect or a home change
    if (forceImmediate || lastForecastMs == 0 || (curMs - lastForecastMs >= WEATHER_FORECAST_POLL_MS)) {
      if (checkBudgetForecast()) fetchForecast(httpBuf, httpBufCap);
      lastForecastMs = curMs;
      // failed: try again in a minute
      if (loggedErrors & (ERR_FC_HTTP | ERR_FC_PARSE)) lastForecastMs = curMs - 4 * 60 * 1000;
    }
    if (forceImmediate || lastAqiMs == 0 || (curMs - lastAqiMs >= WEATHER_AQI_POLL_MS)) {
      if (checkBudgetForecast()) fetchAirQuality(httpBuf, httpBufCap);
      lastAqiMs = curMs;
    }

    // 1b. Cyclones near home: GDACS list every 30 min (5 after a failure)
    if (forceImmediate || cycloneRefresh || lastCycloneMs == 0 || (curMs - lastCycloneMs >= WEATHER_CYCLONE_POLL_MS)) {
      if (cycloneRefresh && tracks_) {   // refetch the tracks too
        if (wxMutex) xSemaphoreTake(wxMutex, portMAX_DELAY);
        memset(tracks_, 0, MAX_TRACKS * sizeof(CycloneTrack));
        if (wxMutex) xSemaphoreGive(wxMutex);
      }
      cycloneRefresh = false;
      clearError(ERR_TC_HTTP | ERR_TC_TRACK);   // log this round's errors again
      pollCyclones(httpBuf, httpBufCap);
      lastCycloneMs = curMs;
      if (loggedErrors & ERR_TC_HTTP) lastCycloneMs = curMs - 25 * 60 * 1000;
      lastJudgeMs = 0;
    }

    // 2. Home Nowcast engine
    uint32_t homeCadence = homeNowcast->cadenceMs();
    if (forceImmediate || lastHomeNowcastMs == 0 || (curMs - lastHomeNowcastMs >= homeCadence)) {
      if (checkBudgetNowcast(false)) {
        runHomeNowcast(httpBuf, httpBufCap);
        lastHomeNowcastMs = curMs;
      }
    }

    // 2b. Upwind probe while rain is coming to or falling at home, for its end
    const RainAlert &rh = rainHome;
    if ((rh.active || rh.raining || rh.watch) && homeNowcast->canProbe() &&
        (lastUpwindMs == 0 || curMs - lastUpwindMs >= WEATHER_UPWIND_POLL_MS) &&
        budgetTotalCalls + NowcastEngine::N_PROBE <= 9500) {
      lastUpwindMs = curMs;
      runUpwindProbe(httpBuf, httpBufCap);
    }

    // 3. Phone Nowcast engine (only while away, not merged)
    if (owntracksEnabled() && owntracksValid() && !owntracksIsMerged(homeLat, homeLon)) {
      double pLat = 0.0, pLon = 0.0;
      owntracksGetLocation(&pLat, &pLon, nullptr, nullptr);
      phoneNowcast->setLocation(pLat, pLon);

      uint32_t phoneCadence = phoneNowcast->cadenceMs();
      if (lastPhoneNowcastMs == 0 || (curMs - lastPhoneNowcastMs >= phoneCadence)) {
        if (checkBudgetNowcast(true)) {
          runPhoneNowcast(httpBuf, httpBufCap);
          lastPhoneNowcastMs = curMs;
        }
      }
    }

    // 3b. OpenWeather's minute-by-minute hour for one place: the phone while
    // it is away and reported in the last 30 min, else home. Every 2 min,
    // every 90 s while rain or a weather alert is near; 960 calls a day.
    if (owmEnabled()) owmTick(httpBuf, httpBufCap, forceImmediate, &lastOwmMs, curMs);

    // 3c. The radar for the same place: rain falling now, which the models can miss
    if (RADAR_ENABLED) radarTick(httpBuf, httpBufCap, forceImmediate, &lastRadarMs, curMs);

    // 3d. Tomorrow.io's minute-by-minute hour for the same place
    if (tioEnabled()) tioTick(httpBuf, httpBufCap, forceImmediate, &lastTioMs, curMs);

    forceImmediate = false;

    // 4. Warnings and the 2-hourly update; storms re-judged every 30 s
    if (!lastJudgeMs || curMs - lastJudgeMs >= 30 * 1000) {
      cycloneTick();
      lastJudgeMs = curMs;
    }
    rainWarnTick();
    postWeatherUpdate(httpBuf, httpBufCap);

    // 5. Budget persistence every 15 min
    if (curMs - lastNvsSaveMs >= 15 * 60 * 1000) {
      saveBudgetNvs();
      owmSaveCount();
      tioSaveCount();
      lastNvsSaveMs = curMs;
    }
  }
}

// WEATHER_HOME from settings.h ("lat,lon[,name]"), when set, wins at boot.
// The name is everything after the second comma (commas allowed), trimmed,
// with one pair of surrounding ' or " quotes removed.
static void applyConfiguredHome() {
  const char *cfg = WEATHER_HOME;
  if (!cfg[0]) return;
  char *end;
  double lat = strtod(cfg, &end);
  bool ok = end != cfg && *end == ',';
  const char *p = end + 1;
  double lon = ok ? strtod(p, &end) : 0;
  ok = ok && end != p && (*end == ',' || *end == 0 || isspace((unsigned char)*end));
  char name[48] = WEATHER_HOME_NAME;
  if (ok) {
    while (isspace((unsigned char)*end)) end++;
    if (*end == ',') {
      const char *s = end + 1;
      while (isspace((unsigned char)*s)) s++;
      size_t n = strlen(s);
      while (n && isspace((unsigned char)s[n - 1])) n--;
      if (n >= 2 && (s[0] == '\'' || s[0] == '"') && s[n - 1] == s[0]) { s++; n -= 2; }
      if (n >= sizeof name) n = sizeof name - 1;
      if (n) { memcpy(name, s, n); name[n] = 0; }
    } else if (*end) {
      ok = false;
    }
  }
  if (!ok || !(fabs(lat) <= 90.0 && fabs(lon) <= 180.0)) {
    logMsg("weather: WEATHER_HOME in settings.h is not \"lat,lon[,name]\"; ignored");
    return;
  }
  if (homeConfigured && fabs(homeLat - lat) < 1e-5 && fabs(homeLon - lon) < 1e-5 && !strcmp(homeName, name)) return;
  setHomeLocation(lat, lon, name);
  logMsg("weather: home from settings.h (%s)", homeName);
}

void weatherInit() {
  void *homeMem = psramCalloc(sizeof(NowcastEngine)), *phoneMem = psramCalloc(sizeof(NowcastEngine));
  if (!homeMem || !phoneMem) {   // no task then: nothing below runs without the engines
    logMsg("weather: off (no memory)");
    return;
  }
  homeNowcast = new (homeMem) NowcastEngine();
  phoneNowcast = new (phoneMem) NowcastEngine();
  wxMutex = xSemaphoreCreateMutex();
  loadNvsConfig();
  owmInit();
  tioInit();
  applyConfiguredHome();
  owntracksInit();
  pushoverInit();

  xTaskCreatePinnedToCore(weatherTask, "weather", 9216, nullptr, 1, &wxTaskHandle, 0);
  logMsg("weather: service initialized%s", homeConfigured ? "" : " (no home set; use `weather home <lat>,<lon> [name]`)");
}

void weatherPoll() {
  if (netUp()) {
    boardTimeStartSntp();
    owntracksStart();
    // last seen at home: no asking; the phone reports by itself once it moves away
    double hLat, hLon;
    double d = weatherHomeLocation(&hLat, &hLon) ? owntracksDistanceTo(hLat, hLon) : -1.0;
    if (!(d >= 0.0 && d < OWNTRACKS_HOME_KM)) owntracksAskIfStale();
  }

  // live countdowns: redraw once a minute while a warning is up
  static uint32_t lastMinute;
  time_t now;
  if ((rainHome.active || rainHome.raining || cyclone_.tracked) && clockValid(&now) && (uint32_t)(now / 60) != lastMinute) {
    lastMinute = (uint32_t)(now / 60);
    wxDirty = true;
  }

  if (wxDirty) {
    wxDirty = false;
    viewsMarkDirty(-1);
  }
}

void weatherCommand(const char *a1, const char *a2) {
  if (!homeNowcast) {
    logMsg("weather: off (no memory)");
    return;
  }
  if (a1 && !strcmp(a1, "demo")) {
    int mode = !a2 ? 0 : !strcmp(a2, "rain") ? 1 : !strcmp(a2, "typhoon") ? 2 : 0;
    loadDemo(mode);
    demoUntilMs = nowMs() + 5 * 60 * 1000;
    logMsg("weather: demo data loaded%s for 5 min (no Discord posts)",
           mode == 1 ? " (heavy shower in 25 min)" : mode == 2 ? " (typhoon here)" : "");
  } else if (a1 && !strcmp(a1, "clear")) {
    clearReq = true;   // the weather task does it (it owns the warning state too)
  } else if (a1 && !strcmp(a1, "home")) {
    if (!a2) {
      logMsg("weather: usage weather home <lat>,<lon> [name]");
      return;
    }
    char a2Buf[64];
    snprintf(a2Buf, sizeof(a2Buf), "%s", a2);
    char *c1 = strchr(a2Buf, ',');
    if (!c1) {
      logMsg("weather: invalid coordinates format (use <lat>,<lon>)");
      return;
    }
    *c1 = '\0';
    char *lonPart = c1 + 1;
    char name[48] = WEATHER_HOME_NAME;
    char *c2 = strchr(lonPart, ',');
    if (c2) {
      *c2 = '\0';
      snprintf(name, sizeof(name), "%s", c2 + 1);
    } else {
      char *a3 = strtok(nullptr, " \t");
      if (a3 && a3[0]) {
        snprintf(name, sizeof(name), "%s", a3);
      }
    }
    for (char *p = name; *p; p++) {
      if (*p == '_') *p = ' ';
    }
    double lat = strtod(a2Buf, nullptr);
    double lon = strtod(lonPart, nullptr);
    if (!(fabs(lat) <= 90.0 && fabs(lon) <= 180.0)) {   // "nan" parses too: it fails both
      logMsg("weather: coordinates out of range (-90..90, -180..180)");
      return;
    }
    homeReq.lat = lat;   // the weather task reads home's place at any moment: it sets it
    homeReq.lon = lon;
    snprintf(homeReq.name, sizeof homeReq.name, "%s", name);
    homeReq.set = true;
    logMsg("weather: home set to %s", name);   // never the coordinates: the log reaches Discord
  } else if (a1 && !strcmp(a1, "refresh")) {
    homeChanged = true;     // forecast, AQI and nowcast at once
    cycloneRefresh = true;  // and GDACS
    if (wxTaskHandle) xTaskNotifyGive(wxTaskHandle);
    logMsg("weather: refresh queued");
    return;
  } else if (a1 && !strcmp(a1, "end-reset")) {
    endResetReq = true;   // the weather task writes these stats: it clears them
    return;
  } else if (a1 && !strcmp(a1, "storms")) {
    cycloneRefresh = true;
    if (wxTaskHandle) xTaskNotifyGive(wxTaskHandle);
    logMsg("weather: cyclone refresh queued");
    return;
  } else if (a1 && !strcmp(a1, "owm-check")) {
    // the merge on a made-up hour (20 min of rain from minute N, 4 mm/h; "12L"
    // = 0.6 mm/h) for OpenWeather, Tomorrow.io ("12T") or both ("12B"); home's
    // Open-Meteo result, the other source's real hour and the poll counts as
    // they are, nothing posted: `weather owm-check 12`
    int from = a2 ? atoi(a2) : 10;
    float mmh = (a2 && strpbrk(a2, "Ll")) ? 0.6f : 4.0f;
    OwmMinutely m = {};
    m.valid = true;
    m.fetchedUnix = (uint32_t)time(nullptr);
    m.dt0 = m.fetchedUnix;
    m.n = 60;
    for (int i = 0; i < 60; i++) m.mm[i] = (i >= from && i < from + 20) ? mmh : 0.0f;
    bool toTio = a2 && strpbrk(a2, "TtBb"), toOwm = !a2 || !strpbrk(a2, "Tt");
    uint32_t nowU = m.fetchedUnix;
    MinuteSrc owm = {toOwm ? &m : owmFresh(false, nowU) ? &owmLast : nullptr, owmWet, true};
    MinuteSrc tio = {toTio ? &m : tioFresh(false, nowU) ? &tioLast : nullptr, tioWet, true};
    RainAlert r = omHome;
    mergeRain(&r, false, omHomeWet, owm, tio);
    fillEnd(&r, true);
    char st[16], en[16], src[80];
    fmtClock(st, sizeof st, r.startUnix, false);
    fmtClock(en, sizeof en, r.endUnix, false);
    rainSrcLine(src, sizeof src, r);
    logMsg("weather: owm-check rain from min %d at %.1f mm/h: %s, start %s end %s (%s, %s) %.1f mm/h | %s", from, mmh,
           r.raining ? "raining" : r.active ? "warning" : r.watch ? "watch" : "dry", st, en, rainEndSrcName(r.endSrc),
           r.kind == RAIN_KIND_THUNDER ? "thunderstorm" : r.kind == RAIN_KIND_SHOWER ? "shower" : "steady", r.mmh, src);
    return;
  } else if (a1 && !strcmp(a1, "test-alert")) {
    testAlertPending = true;
    if (wxTaskHandle) xTaskNotifyGive(wxTaskHandle);
    logMsg("weather: test-alert queued%s", netUp() ? "" : " (sends when Wi-Fi is up)");
  } else if (!a1 || !strcmp(a1, "show")) {
    if (now_.valid) {
      logMsg("weather: %s %.1f C (%d/%d) wind %.0f km/h from %u deg, AQI %d | rain %s",
             now_.place, now_.temp, now_.tmax, now_.tmin, now_.windKmh, now_.windFromDeg,
             now_.aqi, rainHome.active ? "incoming" : "none");
    } else {
      logMsg("weather: %s (no forecast data yet; %s)", homeConfigured ? homeName : WEATHER_HOME_NAME,
             !netUp() ? "needs Wi-Fi" : !homeConfigured ? "no home set" : "fetching");
    }
    if (loggedErrors) logMsg("weather: last error: %s [%s]", lastError, esp_err_to_name(lastHttpErr));

    // Home engine
    if (rainHome.active || rainHome.raining) {
      char s[16], e[16];
      fmtClock(s, sizeof s, rainHome.startUnix, false);
      fmtClock(e, sizeof e, rainHome.endUnix, false);
      logMsg("weather: home engine: %s %s (%s to %s, %.1f mm/h, from %s) | cadence %u min", wxTierName(rainHome.tier),
             rainHome.raining ? "now" : "soon", s, rainHome.endUnix ? e : "12 h+", rainHome.mmh,
             rainHome.from[0] ? rainHome.from : "--", (unsigned)(homeNowcast->cadenceMs() / 60000));
    } else if (rainHome.watch) {
      char s[16], src[80];
      fmtClock(s, sizeof s, rainHome.startUnix, false);
      rainSrcLine(src, sizeof src, rainHome);
      logMsg("weather: home engine: watch, %s possible from %s (%.1f mm/h, not warned) | %s | cadence %u min",
             wxTierName(rainHome.tier), s, rainHome.mmh, src, (unsigned)(homeNowcast->cadenceMs() / 60000));
    } else if (rainHome.dryKm > 0) {
      logMsg("weather: home engine: clear, radar dry within %u km | cadence %u min",
             (unsigned)rainHome.dryKm, (unsigned)(homeNowcast->cadenceMs() / 60000));
    } else {
      logMsg("weather: home engine: clear | cadence %u min",
             (unsigned)(homeNowcast->cadenceMs() / 60000));
    }

    // Phone engine
    if (!owntracksEnabled()) {
      logMsg("weather: phone engine: off (MQTT_URI empty)");
    } else if (!owntracksValid()) {
      uint32_t age = owntracksAgeSec();
      if (age == UINT32_MAX) {
        logMsg("weather: phone engine: waiting for location");
      } else {
        logMsg("weather: phone engine: location expired (age %u s)", (unsigned)age);
      }
    } else if (owntracksIsMerged(homeLat, homeLon)) {
      double dist = owntracksDistanceTo(homeLat, homeLon);
      logMsg("weather: phone engine: merged with home (dist %.2f km, age %u s)",
             dist, (unsigned)owntracksAgeSec());
    } else {
      double dist = owntracksDistanceTo(homeLat, homeLon);
      if (rainPhone.active) {
        logMsg("weather: phone engine: away (dist %.2f km, age %u s) | rain in ~%u min (%.1f mm/h, from %s), cadence %u min",
               dist, (unsigned)owntracksAgeSec(), (unsigned)rainPhone.etaMin, rainPhone.mmh,
               rainPhone.from[0] ? rainPhone.from : "--", (unsigned)(phoneNowcast->cadenceMs() / 60000));
      } else {
        logMsg("weather: phone engine: away (dist %.2f km, age %u s) | clear%s, cadence %u min",
               dist, (unsigned)owntracksAgeSec(),
               (rainPhone.dryKm > 0) ? " (dry 25 km)" : "",
               (unsigned)(phoneNowcast->cadenceMs() / 60000));
      }
    }

    // OpenWeather
    if (!owmEnabled()) {
      logMsg("weather: OpenWeather: off (OWM_API_KEY empty)");
    } else {
      int first = -1;
      float peak = 0;
      for (int i = 0; i < owmLast.n; i++) {
        if (owmLast.mm[i] >= OWM_RAIN_MMH && first < 0) first = i;
        if (owmLast.mm[i] > peak) peak = owmLast.mm[i];
      }
      char when[24] = "--";
      if (owmLast.valid) fmtClock(when, sizeof when, owmLast.fetchedUnix, false);
      logMsg("weather: OpenWeather: %s, last %s: %s, peak %.1f mm/h, %u alert(s) | %u/%u calls today%s%s",
             owmOnPhone ? "phone" : "home", when, !owmLast.valid ? "no data yet" : first < 0 ? "dry for 60 min" :
             first == 0 ? "raining" : "rain within the hour", peak, (unsigned)owmLast.nAlerts,
             (unsigned)owmCallsToday(), (unsigned)OWM_DAILY_CALLS, owmLastError()[0] ? " | " : "", owmLastError());
    }
    // Tomorrow.io
    if (!tioEnabled()) {
      logMsg("weather: Tomorrow.io: off (TOMORROW_API_KEY empty)");
    } else {
      OwmRain o;
      bool ok = owmRainSummary(tioLast, (uint32_t)time(nullptr), &o, TOMORROW_RAIN_MMH);
      float peak = 0;
      for (int i = 0; i < tioLast.n; i++)
        if (tioLast.mm[i] > peak) peak = tioLast.mm[i];
      char when[24] = "--";
      if (tioLast.valid) fmtClock(when, sizeof when, tioLast.fetchedUnix, false);
      logMsg("weather: Tomorrow.io: %s, last %s: %s, peak %.1f mm/h | %u/%u calls today, %u/%u this hour%s%s",
             tioOnPhone ? "phone" : "home", when, !tioLast.valid ? "no data yet" : !ok ? "hour run out" : !o.sees ? "dry for 60 min" :
             o.rainingNow ? "raining" : "rain within the hour", peak, (unsigned)tioCallsToday(), (unsigned)TIO_DAILY_CALLS,
             (unsigned)tioCallsThisHour(), (unsigned)TIO_HOURLY_CALLS, tioLastError()[0] ? " | " : "", tioLastError());
    }
    // Radar
    if (!RADAR_ENABLED) {
      logMsg("weather: radar: off (RADAR_ENABLED 0)");
    } else if (!radarLast.valid) {
      logMsg("weather: radar: no frame yet%s%s", radarLastError()[0] ? " | " : "", radarLastError());
    } else {
      char when[16], frame[16], nearS[24] = "none on the tile";
      fmtClock(when, sizeof when, radarLast.fetchedUnix, false);
      fmtClock(frame, sizeof frame, radarLast.frameUnix, false);
      if (radarLast.nearKm >= 0) snprintf(nearS, sizeof nearS, "%d km", radarLast.nearKm);
      logMsg("weather: radar: %s, last %s (frame %s): %s, here %d dBZ on %u px, nearest echo %s%s%s%s",
             radarOnPhone ? "phone" : "home", when, frame, radarRainingHere(radarLast) ? "raining" : "dry",
             radarLast.dbzHere < -100 ? 0 : radarLast.dbzHere, (unsigned)radarLast.pxHere, nearS,
             radarApproaching ? " (moving in)" : "",
             radarLastError()[0] ? " | " : "", radarLastError());
    }
    logMsg("weather: rain seen by: home %s, phone %s", rainSrcName(rainHome), rainSrcName(rainPhone));

    // Rain end: the estimates now, and how far off each source's first guess was
    if (rainHome.active || rainHome.raining || rainHome.watch) {
      char line[200], clk[16];
      int n = 0;
      for (int s = 1; s < RAIN_END_N; s++) {
        fmtClock(clk, sizeof clk, endEst[s], false);
        n += snprintf(line + n, sizeof line - n, "%s%s %s", s > 1 ? ", " : "", rainEndSrcName(s), endEst[s] ? clk : "--");
        if (n >= (int)sizeof line) break;
      }
      logMsg("weather: end estimates: %s | used: %s%s", line, rainEndSrcName(rainHome.endSrc),
             upwindBeyond && upwindFresh((uint32_t)time(nullptr)) ? " | upwind: rain 2 h+ upstream" : "");
    }
    bool anyStats = false;
    for (int s = 1; s < RAIN_END_N; s++) {
      const EndStat &st = endStats[s];
      if (!st.n) continue;
      anyStats = true;
      logMsg("weather: end accuracy %s: %u rain(s), off by ~%d min (bias %+d), guessed ~%d min ahead", rainEndSrcName(s),
             (unsigned)st.n, (int)(st.sumAbs / st.n), (int)(st.sumErr / st.n), (int)(st.sumLead / st.n));
    }
    if (!anyStats) logMsg("weather: end accuracy: no rain scored yet");
    if (lastRain.to) {
      char c1[16], c2[16], line[160];
      int n = 0;
      fmtClock(c1, sizeof c1, lastRain.from, false);
      fmtClock(c2, sizeof c2, lastRain.to, false);
      line[0] = 0;
      for (int s = 1; s < RAIN_END_N && n < (int)sizeof line; s++)
        if (lastRain.has[s]) n += snprintf(line + n, sizeof line - n, "%s%s %+d", n ? ", " : "", rainEndSrcName(s), lastRain.err[s]);
      logMsg("weather: last rain %s-%s, first guesses off by (min): %s", c1, c2, n ? line : "none");
    }

    // Cyclones (GDACS)
    int nTracks = 0;
    if (wxMutex) xSemaphoreTake(wxMutex, portMAX_DELAY);   // not while the weather task parses a track
    for (int i = 0; tracks_ && i < MAX_TRACKS; i++) {
      if (!tracks_[i].n) continue;
      nTracks++;
      Cyclone c;
      time_t now;
      if (!clockValid(&now)) break;
      cycloneJudge(tracks_[i], homeLat, homeLon, now, &c);
      char a[24];
      fmtClock(a, sizeof a, c.arriveUnix, true);
      logMsg("weather: cyclone %s%s: %u km now, closest %u km, peak %u km/h, %s", tracks_[i].name,
             i == trackShown ? " (shown)" : "", c.distKm, c.closestKm, c.windKmh,
             c.active ? "TYPHOON HERE" : c.tracked ? a : "not a typhoon threat");
    }
    if (wxMutex) xSemaphoreGive(wxMutex);
    if (!nTracks) logMsg("weather: cyclones: none within %.0f km", CYCLONE_WATCH_KM);

    // Budget
    logMsg("weather: budget: %u/9500 calls today (home: %u, phone: %u, forecast: %u)",
           (unsigned)budgetTotalCalls, (unsigned)budgetHomeCalls,
           (unsigned)budgetPhoneCalls, (unsigned)budgetFcCalls);
    return;
  } else {
    logMsg("weather: usage weather <show|refresh|demo [rain|typhoon]|clear|storms|home <lat>,<lon> [name]|test-alert>");
    return;
  }

  viewsMarkDirty(-1);
}
