lnminh1411/ESP32-PC-Control-System/firmware/main/night.cpp

#include "night.h"

#include <math.h>
#include <nvs.h>
#include <stdio.h>
#include <string.h>
#include <strings.h>
#include <time.h>

#include "board_time.h"
#include "discord.h"
#include "display.h"
#include "hwctl.h"
#include "log.h"
#include "monctl.h"
#include "owntracks.h"
#include "pc_state.h"
#include "pcstats.h"
#include "power.h"
#include "presence.h"
#include "screens.h"
#include "settings_or_example.h"
#include "sys.h"
#include "usb.h"
#include "views.h"
#include "weather.h"

static const int IDLE_ENGAGE_S = NIGHT_IDLE_ENGAGE_S;
static const int START_HOUR = NIGHT_START_HOUR, END_HOUR = NIGHT_END_HOUR;
static const uint8_t PANEL_PCT = NIGHT_PANEL_PCT, STATUS_LED_PCT = NIGHT_STATUS_LED_PCT, RGB_PCT = NIGHT_RGB_PCT;

static bool enabled;
static bool engaged;
// Low power mode (by hand, saved): the night's Process Lasso config, PC LEDs
// 10 %, panels 10 % (normal faces), status LED 20 %, at any hour, until
// turned off. No display off, no sleep, input doesn't end it.
static bool lowPower;
static bool lowPcOnly;                   // the desk rule's: Process Lasso only, LEDs, panels and status LED left alone (NVS)
static uint32_t lowPowerAtMin;           // minutes since midnight, for the status line
static bool lowRgbPending;               // PC LEDs to lower once PcHwCtl answers
static bool manual;                      // started by hand: no window, no idle needed
static uint32_t engagedAtMin;            // minutes since midnight, for the status line
static uint32_t engagedMs;               // input newer than this ends it
// Wake guard: input during the night only ends it if the next 10 s show a
// real return (mouse moved > 50 px, or 3 key / button presses, or the camera
// sees someone); otherwise the displays go off again and the night carries
// on. The camera seeing nobody overrules the input, once per
// NIGHT_GUARD_VETO_MS: a dim room can miss you, and you would be locked out
static const uint32_t GUARD_MS = NIGHT_GUARD_MS;
static const double GUARD_PX = NIGHT_GUARD_PX, GUARD_PRESSES = NIGHT_GUARD_PRESSES;
static uint32_t guardUntilMs;            // 0 = no wake being checked (night is off meanwhile)
static bool guardManual;                 // the night being checked was started by hand
static double guardPx0, guardPress0;     // pc.in_px / pc.in_press when the wake was seen
static uint32_t guardChecks;             // presenceChecks() when the wake was seen
static uint32_t vetoMs;                  // the camera last overruled input
static uint32_t falseWakes;              // this night, for the status line
// Past the idle timer the desk decides (presence.cpp): someone there holds the
// night off for NIGHT_DESK_HOLD_S, then it engages unless something blocks
// sleep; nobody (two checks) engages and sleeps at once (sleepCheck). The
// camera unable to tell (dark, busy) engages as before, sleep on the timer.
static const uint32_t DESK_HOLD_MS = NIGHT_DESK_HOLD_S * 1000UL;
static const uint32_t FIRST_CHECK_MS = 20000;   // a first check after the agent starts can take this long
static uint32_t dueMs;                   // idle timer ran out, night waiting for the desk
static uint32_t dueChecks;               // presenceChecks() then
static uint32_t deskSinceMs;             // someone seen since dueMs

// Sleep (in the night window, while engaged): NIGHT_SLEEP_S after the last
// real input on the PC, at once when nobody is at the desk (not in a night
// started by hand). False wakes don't move the clock. Held while an exe is heavy (pc.heavy),
// a power request keeps the PC up (pc.disp_req / sys_req / exec_req, minus
// NIGHT_REQ_IGNORE), or the network is busy (net_down / net_up over
// NIGHT_NET_HOLD_BPS, ~1 min average); the displays stay off meanwhile.
// Hibernate only when the phone leaves home (leaveCheck).
static const uint32_t SLEEP_MS = NIGHT_SLEEP_S * 1000UL;
static const uint32_t POWER_WAIT_MS = 3 * 60 * 1000;   // for the PC to go down, or to come up when woken
static uint32_t inputAtMs;               // last real input on the PC
static uint32_t sleepReqMs, hibReqMs;    // asked for, PC not down yet
static uint32_t sleptAtMs;               // asleep for night mode: hibernated if the phone leaves home
static uint32_t wokeMs;                  // woken by us to hibernate
static bool offByNight;                  // asleep or hibernating because of night mode
static uint32_t quietFromMs;             // night mode's last sleep / hibernate / wake request (nightPowerQuiet)
static uint32_t powerTryMs;              // last sleep / hibernate request
static float netAvg;                     // bytes/s, the busier of net_down / net_up, ~1 min average

// Process Lasso's night config on the PC (Night.cs), repeated every 30 s
static void lassoSend() { usbPcSendLine(engaged || lowPower ? "!night 1\n" : "!night 0\n"); }

// counters that wrap at 1e6
static double counted(const char *key, double from) {
  double d = pcStat(key) - from;
  return d < 0 ? d + 1000000.0 : d;
}
// PC displays: night mode turned them off and owes turning them on, until
// the PC service answers "ok" (a PC asleep or hibernated at 06:00, or one
// powered on mid-night before its user half is up, gets it when it is back)
static bool monOnOwed;                   // NVS
static uint32_t monOnId, monOnSentMs;    // the request in flight
static int8_t savedRgb = -1;             // PC LED brightness to put back, -1 = nothing owed (NVS)
static bool rgbLowered;                  // our 10 % is on the LEDs right now (NVS with savedRgb)

// #pc-announcement
static void announce(const char *what, uint32_t color) {
  if (presenceDry()) logMsg("night: dry, would post: %s", what);
  else discordPost(DC_PC, "Night mode", what, color);
}

static void saveNvs() {
  nvs_handle_t h;
  if (nvs_open("night", NVS_READWRITE, &h) != ESP_OK) return;
  nvs_set_u8(h, "on", enabled ? 1 : 0);
  nvs_set_i8(h, "rgb", savedRgb);
  nvs_set_u8(h, "monon", monOnOwed ? 1 : 0);
  nvs_set_u8(h, "low", lowPower ? 1 : 0);
  nvs_set_u8(h, "lowpc", lowPcOnly ? 1 : 0);
  nvs_commit(h);
  nvs_close(h);
}

void nightInit() {
  nvs_handle_t h;
  if (nvs_open("night", NVS_READONLY, &h) != ESP_OK) return;
  uint8_t on = 0;
  if (nvs_get_u8(h, "on", &on) == ESP_OK) enabled = on;
  nvs_get_i8(h, "rgb", &savedRgb);
  uint8_t mon = 0;
  if (nvs_get_u8(h, "monon", &mon) == ESP_OK) monOnOwed = mon;
  uint8_t low = 0;
  if (nvs_get_u8(h, "low", &low) == ESP_OK) lowPower = low;
  if (nvs_get_u8(h, "lowpc", &low) == ESP_OK) lowPcOnly = lowPower && low;
  nvs_close(h);
  lowRgbPending = lowPower && !lowPcOnly;
  rgbLowered = savedRgb >= 0;   // a restart while engaged: the LEDs are still at 10 %
}

void nightWindowText(char *buf, uint32_t size) {
  snprintf(buf, size, "%02d:00-%02d:00 after %d min", START_HOUR, END_HOUR, IDLE_ENGAGE_S / 60);
}

bool pcReachable() { return pcState() == PC_ON && pcStatsFresh() && pcStat("hw.ok") >= 1; }

// Low power mode that dims the LEDs, panels and status LED (not the desk rule's PC-only one)
static bool lowDims() { return lowPower && !lowPcOnly; }

// PC-off faces while engaged; panels and status LED dimmed while engaged or in low power mode
static void boardSide() {
  screensNight = engaged;
  bool dim = engaged || lowDims();
  backlightCap(dim ? PANEL_PCT : 100);
  ledCapSet(dim ? STATUS_LED_PCT : 100);
  viewsMarkDirty(-1);
}

// PC LEDs to 10 %, remembering the level once (a re-engage keeps the first one)
static uint32_t rgbRestoreId, rgbRestoreSentMs;
static void rgbLower() {
  if (rgbLowered && rgbRestoreSentMs) {   // a restore in flight may land: 10 % again, the saved level kept
    uint32_t id;
    if (!hwSend("rgb brightness 10", &id)) rgbRestoreId = rgbRestoreSentMs = 0;
    return;
  }
  float b = pcStat("hw.rgb.bright");
  if (rgbLowered || isnan(b) || b <= RGB_PCT || !pcReachable()) return;
  uint32_t id;
  if (hwSend("rgb brightness 10", &id)) return;
  savedRgb = (int8_t)lroundf(b);
  rgbLowered = true;
  saveNvs();
}

// PC LEDs back to what they were, done once PcHwCtl answers ok: again every
// 30 s until then. Sent the moment the PC is reachable, the helper can be up
// before PcHwCtl is ("err PcHwCtl not running"), and a sent-and-forgotten
// command left the LEDs at 10 %
static void rgbRestoreDone();
static bool rgbRestorePost;
static void rgbRestoreTry(bool post) {
  if (!rgbLowered || savedRgb < 0 || !pcReachable()) return;
  if (post) rgbRestorePost = true;
  uint32_t now = nowMs();
  if (rgbRestoreId) {
    char r[64];
    if (!hwReplyFor(rgbRestoreId, r, sizeof r)) {
      if (now - rgbRestoreSentMs < 30000) return;   // waiting for the answer
    } else if (strncmp(r, "ok", 2)) {
      rgbRestoreId = 0;
      logMsg("night: PC LEDs back: %s, again in 30 s", r);
    } else {
      rgbRestoreId = 0;
      rgbRestoreDone();
      return;
    }
  }
  if (rgbRestoreSentMs && now - rgbRestoreSentMs < 30000) return;
  rgbRestoreSentMs = now;
  char cmd[32];
  snprintf(cmd, sizeof cmd, "rgb brightness %d", savedRgb);
  if (hwSend(cmd, &rgbRestoreId)) rgbRestoreId = 0;   // not sent: again in 30 s
}

static void rgbRestoreDone() {
  logMsg("night: PC LEDs back to %d %%", savedRgb);
  if (rgbRestorePost) {
    char what[64];
    snprintf(what, sizeof what, "PC LEDs back to %d %%", savedRgb);
    announce(what, 0xF1C40F);
  }
  rgbLowered = false;
  savedRgb = -1;
  rgbRestorePost = false;
  rgbRestoreSentMs = 0;
  saveNvs();
}

static void disengage(const char *why, bool post = true);

// PC displays off; turning them on is owed from now on
const char *nightDisplaysOff() {
  monOnOwed = true;
  monOnId = 0;
  saveNvs();
  uint32_t id;
  return monSend("power all off", &id);
}

// Owed displays on: sent while the night is off and the PC service is there,
// again every 30 s until it answers ok
static void monOnTry(uint32_t now) {
  if (!monOnOwed || engaged || presenceDisplaysOff() || !pcReachable()) return;
  if (monOnId) {
    char r[64];
    if (monReplyFor(monOnId, r, sizeof r)) {
      monOnId = 0;
      if (!strncmp(r, "ok", 2)) {
        monOnOwed = false;
        saveNvs();
        logMsg("night: PC displays on");
        return;
      }
      logMsg("night: displays on: %s, again in 30 s", r);
    } else if (now - monOnSentMs < 30000) {
      return;   // waiting for the answer
    }
  }
  if (monOnSentMs && now - monOnSentMs < 30000) return;
  monOnSentMs = now;
  const char *err = monSend("power all on", &monOnId);
  if (err) {
    monOnId = 0;
    logMsg("night: displays on: %s, again in 30 s", err);
  }
}

void nightDisplaysOnNow() {
  monOnSentMs = 0;
  monOnTry(nowMs());
}

// "claude.exe" in NIGHT_REQ_IGNORE
static bool reqIgnored(const char *by) {
  if (!by || !*by) return false;
  const char *list = NIGHT_REQ_IGNORE;
  size_t n = strlen(by);
  for (const char *p = list; *p;) {
    while (*p == ' ' || *p == ',') p++;
    const char *e = p;
    while (*e && *e != ',') e++;
    const char *t = e;
    while (t > p && t[-1] == ' ') t--;
    if ((size_t)(t - p) == n && !strncasecmp(p, by, n)) return true;
    p = e;
  }
  return false;
}

// a power request that holds sleep: one from an ignored holder doesn't (the
// helper only names the first holder, so two or more always hold)
static bool reqHolds(const char *key, const char *byKey) {
  float n = pcStat(key);
  if (isnan(n) || n < 1) return false;
  char by[64];   // a copy: the bot task gets here too (nightStatus)
  pcTextCopy(byKey, by, sizeof by);
  return !(n < 2 && reqIgnored(by));
}

// "" when sleep and hibernate may go ahead, else why not. Into the caller's
// buffer: the bot task asks too (nightStatus for the panel)
static const char *sleepHold(char *holdWhy, size_t cap) {
  const char *byKey = nullptr, *what = nullptr;
  if (pcStat("pc.heavy") >= 1) byKey = "pc.heavy_by", what = "busy";
  else if (pcStat("pc.disp_req") >= 1) byKey = "pc.disp_req_by", what = "keeps the display on";
  else if (reqHolds("pc.sys_req", "pc.sys_req_by")) byKey = "pc.sys_req_by", what = "keeps the PC up";
  else if (reqHolds("pc.exec_req", "pc.exec_req_by")) byKey = "pc.exec_req_by", what = "keeps running";
  if (byKey) {
    char by[48];   // a copy: the bot task gets here too (nightStatus)
    pcTextCopy(byKey, by, sizeof by);
    snprintf(holdWhy, cap, "%.40s %s", by, what);
  }
  else if (netAvg > NIGHT_NET_HOLD_BPS) snprintf(holdWhy, cap, "network %.1f MB/s", netAvg / 1e6f);
  else holdWhy[0] = 0;
  return holdWhy;
}

static void netAverage() {
  if (!pcStatsFresh()) return;
  float d = pcStat("net_down"), u = pcStat("net_up");
  float v = isnan(d) ? 0 : d;
  if (!isnan(u) && u > v) v = u;
  netAvg += (v - netAvg) / 60;   // polled every second
}

// A hold reason without its numbers ("msedgewebview2.exe 1.0 busy" ->
// "msedgewebview2.exe  busy"): the log names a new holder, not each new load
static bool sameHold(const char *a, const char *b) {
  for (;;) {
    while (*a && ((*a >= '0' && *a <= '9') || *a == '.')) a++;
    while (*b && ((*b >= '0' && *b <= '9') || *b == '.')) b++;
    if (*a != *b) return false;
    if (!*a) return true;
    a++, b++;
  }
}

// While engaged, in the window, no wake being checked: sleep (never hibernate;
// that waits for the phone to leave home, leaveCheck)
static void sleepCheck(uint32_t now) {
  static char lastHold[64];
  if (sleepReqMs || hibReqMs || sleptAtMs || offByNight) return;
  if (pcState() != PC_ON || !pcStatsFresh()) return;
  uint32_t inactive = now - inputAtMs;
  bool nobody = !manual && presenceNobody();
  if (inactive < SLEEP_MS && !nobody) { lastHold[0] = 0; return; }
  char why[64];
  sleepHold(why, sizeof why);
  if (!sameHold(why, lastHold)) {
    if (*why) logMsg("night: sleep held, %s", why);
    else if (*lastHold) logMsg("night: sleep no longer held");
    snprintf(lastHold, sizeof lastHold, "%s", why);
  }
  if (*why || now - powerTryMs < 60000) return;
  powerTryMs = now;
  if (presenceDry()) { logMsg("night: dry, would sleep the PC"); return; }
  quietFromMs = now | 1;
  const char *err = powerRequest("sleep");
  if (err) { logMsg("night: sleep not sent (%s)", err); return; }
  sleepReqMs = now;
  logMsg("night: %lu min without input%s, putting the PC to sleep", (unsigned long)(inactive / 60000), nobody ? ", nobody at the desk" : "");
}

// Every second, engaged or not: did the PC go down, did a woken PC come up
// to hibernate, did someone power it on
static void powerFollow(uint32_t now) {
  bool on = pcState() == PC_ON;
  if (sleepReqMs) {
    if (!on) {
      sleepReqMs = 0;
      sleptAtMs = now;
      offByNight = true;
      const char *what = powerHibernateOn() == 0 ? "PC asleep" : "PC asleep; hibernated when you leave home";
      logMsg("night: %s", what);
      announce(what, 0x2C3E50);
    } else if (now - sleepReqMs > POWER_WAIT_MS) {
      sleepReqMs = 0;
      logMsg("night: the PC did not go to sleep");
    }
  }
  if (hibReqMs) {
    if (!on) {
      hibReqMs = 0;
      sleptAtMs = 0;
      wokeMs = 0;
      offByNight = true;
      logMsg("night: PC hibernating");
      announce("PC hibernating, until someone powers it on", 0x2C3E50);
    } else if (now - hibReqMs > POWER_WAIT_MS) {
      hibReqMs = 0;
      logMsg("night: the PC did not hibernate");
    }
  }
  if (wokeMs) {
    if (on && pcStatsFresh()) {
      if (now - powerTryMs >= 5000) {
        powerTryMs = now;
        quietFromMs = now | 1;
        const char *err = powerRequest("hibernate");
        if (!err) { hibReqMs = now; wokeMs = 0; logMsg("night: woken, hibernating"); }
      }
    } else if (now - wokeMs > POWER_WAIT_MS) {
      wokeMs = 0;
      sleptAtMs = 0;
      logMsg("night: the PC %s after the wake, hibernate dropped", on ? "came up without the PC service" : "did not come up");
    }
    return;
  }
  if (on && offByNight && !sleepReqMs && !hibReqMs) {
    // up again without us: someone powered it on
    offByNight = false;
    sleptAtMs = 0;
    logMsg("night: PC powered on");
    if (engaged) disengage("PC powered on");
  }
}

// Leaving home (the phone, OwnTracks, goes from within NIGHT_LEAVE_KM of home
// to beyond it, any hour): hibernate the PC. Asleep for night mode: woken
// first, then hibernated (powerFollow). On: only when nobody has used it for
// NIGHT_LEAVE_IDLE_S. Off for any other reason: left alone (a wake could boot
// a PC that was shut down). Needs a home (`weather home`) and a valid phone
// fix (OWNTRACKS_MAX_AGE_S); the phone reports leaving when it moves.
static void leaveCheck(uint32_t now) {
  static int8_t atHome = -1;   // -1: not known yet
  double hLat, hLon;
  if (!owntracksEnabled() || !owntracksValid() || !weatherHomeLocation(&hLat, &hLon)) return;
  double d = owntracksDistanceTo(hLat, hLon);
  if (d < 0) return;
  bool home = d <= NIGHT_LEAVE_KM;
  bool left = atHome == 1 && !home;
  atHome = home ? 1 : 0;
  if (!left) return;
  if (!enabled && !engaged && !sleptAtMs) {
    logMsg("night: left home, night mode off, PC left as it is");
    return;
  }
  if (wokeMs || hibReqMs) return;
  // hibernation off on the PC: waking it to hibernate would leave it on. Asleep
  // stays asleep; on and idle goes to sleep instead
  bool noHib = powerHibernateOn() == 0;
  if (noHib && pcState() != PC_ON) {
    logMsg("night: left home, hibernation is off on the PC: PC left as it is");
    return;
  }
  if (sleptAtMs && pcState() != PC_ON) {
    sleptAtMs = 0;
    wokeMs = now;
    quietFromMs = now | 1;
    const char *err = powerWake();
    logMsg("night: left home, waking the PC to hibernate it%s%s", err ? ": " : "", err ? err : "");
    announce(err ? "You left home; the PC could not be woken to hibernate" : "You left home: waking the PC to hibernate it",
             0x2C3E50);
    if (err) wokeMs = 0;
    return;
  }
  if (pcState() != PC_ON) {
    logMsg("night: left home, PC off (not by night mode), left as it is");
    return;
  }
  float idle = pcStat("pc.idle_s");
  if (!isnan(idle) && idle < NIGHT_LEAVE_IDLE_S) {
    char what[96];
    snprintf(what, sizeof what, "You left home, but the PC was used %.0f s ago: not %s", idle, noHib ? "put to sleep" : "hibernated");
    logMsg("night: %s", what);
    announce(what, 0xF1C40F);
    return;
  }
  powerTryMs = now;
  quietFromMs = now | 1;
  if (noHib) {
    const char *err = powerRequest("sleep");
    if (err) {
      logMsg("night: left home, sleep not sent (%s)", err);
      return;
    }
    sleepReqMs = now;
    logMsg("night: left home, hibernation off: putting the PC to sleep");
    announce("You left home: putting the PC to sleep (hibernation is off)", 0x2C3E50);
    return;
  }
  const char *err = powerRequest("hibernate");
  if (err) {
    logMsg("night: left home, hibernate not sent (%s)", err);
    return;
  }
  hibReqMs = now;
  logMsg("night: left home, hibernating the PC");
  announce("You left home: hibernating the PC", 0x2C3E50);
}

bool nightPowerQuiet() { return quietFromMs && nowMs() - quietFromMs < POWER_WAIT_MS + 30000; }

static void engage(bool byHand) {
  engaged = true;
  manual = byHand;
  engagedMs = nowMs();
  guardUntilMs = 0;
  falseWakes = 0;
  dueMs = deskSinceMs = 0;
  float idle = pcStat("pc.idle_s");
  inputAtMs = engagedMs - (!isnan(idle) && idle > 0 && idle < 86400 ? (uint32_t)(idle * 1000) : 0);
  struct tm t;
  engagedAtMin = boardLocalTime(&t) ? t.tm_hour * 60 + t.tm_min : 0;
  boardSide();
  rgbLower();
  const char *err = nightDisplaysOff();
  char rgbPct[8];
  snprintf(rgbPct, sizeof rgbPct, "%d %%", RGB_PCT);
  logMsg("night: engaged%s (PC LEDs %s, displays %s)", byHand ? " by hand" : "",
         rgbLowered ? rgbPct : "left alone", err ? err : "off");
  char what[160];
  snprintf(what, sizeof what, "Engaged%s: PC LEDs %s, board panels %d %% on the PC-off screens, status LED %d %%, PC displays %s",
           byHand ? " by hand" : "", rgbLowered ? rgbPct : "unchanged", PANEL_PCT, STATUS_LED_PCT, err ? "not reached" : "off");
  announce(what, 0x2C3E50);
  lassoSend();
}

// Everything back, PC displays on. post = false: a wake being checked, whose
// outcome is posted when known (backToNormal or a quiet re-engage).
static void backToNormal(const char *why) {
  if (lowDims()) {
    logMsg("night: off again (%s), low power mode stays on", why);
    char what[160];
    snprintf(what, sizeof what, "Over (%s); low power mode stays on (PC LEDs, panels and status LED stay dimmed)", why);
    announce(what, 0xF1C40F);
    return;
  }
  logMsg("night: off again (%s)%s", why, rgbLowered ? ", PC LEDs go back when PcHwCtl answers" : "");
  char what[160];
  snprintf(what, sizeof what, "Back to normal (%s)%s", why, rgbLowered ? "; PC LEDs go back once the PC is on" : "");
  announce(what, 0xF1C40F);
}

static void disengage(const char *why, bool post) {
  engaged = false;
  manual = false;
  guardUntilMs = 0;
  boardSide();
  lassoSend();
  monOnSentMs = 0;   // now, not in 30 s
  monOnTry(nowMs());
  if (!lowDims()) rgbRestoreTry(false);   // the "back to normal" post covers it
  if (post) backToNormal(why);
}

// A false wake: night again at once, as it was. The sleep clock (inputAtMs),
// the start time and the false-wake count carry on.
static void reengage() {
  engaged = true;
  manual = guardManual;
  engagedMs = nowMs();   // the next input is a new wake
  boardSide();
  rgbLower();
  const char *err = nightDisplaysOff();
  lassoSend();
  logMsg("night: back on after a false wake (displays %s)", err ? err : "off");
}

// PC monitors in the evening: from MON_DIM_START_HOUR to the night's end,
// each monitor that is on goes MON_DIM_STEP_PCT down every minute from what it
// reports, to 0 (raised by hand, it goes down again from there). After an
// evening that dimmed them, at the night's end all go to MON_MORNING_PCT: owed
// (NVS "night"/"mowed") until the PC answers ok, so a PC off at 06:00 gets it
// when it is back, and a board restart later in the day changes nothing.
static void saveMornOwed(uint8_t owed) {
  nvs_handle_t h;
  if (nvs_open("night", NVS_READWRITE, &h) != ESP_OK) return;
  nvs_set_u8(h, "mowed", owed);
  nvs_commit(h);
  nvs_close(h);
}

static void eveningDim(uint32_t now) {
  if (!MON_DIM_ENABLED) return;
  static uint32_t stepMs, mornId, mornSentMs;
  static int8_t owed = -1;   // -1: NVS not read yet
  if (owed < 0) {
    uint8_t v = 0;
    nvs_handle_t h;
    if (nvs_open("night", NVS_READONLY, &h) == ESP_OK) {
      nvs_get_u8(h, "mowed", &v);
      nvs_close(h);
    }
    owed = v ? 1 : 0;
  }
  struct tm t;
  if (!boardLocalTime(&t) || !pcReachable()) return;
  bool evening = t.tm_hour >= MON_DIM_START_HOUR || t.tm_hour < END_HOUR;
  if (evening) {
    if (!owed) {
      owed = 1;
      saveMornOwed(1);
      logMsg("night: evening, PC monitors dim %d %% a minute", MON_DIM_STEP_PCT);
    }
    if (stepMs && now - stepMs < 60000) return;
    stepMs = now | 1;
    int n = (int)pcStat("mon.count");
    for (int i = 1; i <= n && i <= 8; i++) {
      char key[20];
      snprintf(key, sizeof key, "mon.%d.power", i);
      if (pcStat(key) < 1) continue;
      snprintf(key, sizeof key, "mon.%d.bright", i);
      float b = pcStat(key);
      if (isnan(b) || b <= 0) continue;
      int to = (int)lroundf(b) - MON_DIM_STEP_PCT;
      char cmd[24];
      uint32_t id;
      snprintf(cmd, sizeof cmd, "bright %d %d", i, to < 0 ? 0 : to);
      const char *err = monSend(cmd, &id);
      if (err) logMsg("night: evening dim, %s: %s", cmd, err);
    }
    return;
  }
  if (!owed) return;
  if (mornId) {
    char r[48];
    if (monReplyFor(mornId, r, sizeof r)) {
      mornId = 0;
      if (!strncmp(r, "ok", 2)) {
        owed = 0;
        saveMornOwed(0);
        logMsg("night: morning, PC monitors at %d %%", MON_MORNING_PCT);
        return;
      }
      logMsg("night: morning brightness: %s, again in 30 s", r);
    } else if (now - mornSentMs < 30000) {
      return;   // waiting for the answer
    }
  }
  if (mornSentMs && now - mornSentMs < 30000) return;
  mornSentMs = now | 1;
  char cmd[24];
  snprintf(cmd, sizeof cmd, "bright all %d", MON_MORNING_PCT);
  if (monSend(cmd, &mornId)) mornId = 0;
}

void nightPoll() {
  static uint32_t lastMs;
  uint32_t now = nowMs();
  if (now - lastMs < 1000) return;
  lastMs = now;

  // the PC (back) on: the night state at once, so `!night 0` gives a PC
  // that slept or hibernated through the morning its day config back
  static uint32_t lassoMs;
  static bool wasFresh;
  bool fresh = pcStatsFresh();
  if ((fresh && !wasFresh) || now - lassoMs >= NIGHT_LASSO_REPEAT_MS) { lassoMs = now; lassoSend(); }
  wasFresh = fresh;
  netAverage();
  powerFollow(now);
  leaveCheck(now);
  static bool lowApplied;
  if (lowPower && !lowApplied) boardSide();   // after a restart in low power mode
  lowApplied = true;
  if (lowRgbPending && pcReachable()) {
    lowRgbPending = false;
    rgbLower();
  }
  if (!engaged && !lowDims()) rgbRestoreTry(true);   // owed from a morning or a restart
  monOnTry(now);
  eveningDim(now);
  presenceWatch(engaged || guardUntilMs || dueMs);

  // Wake check: the night went off at the first input; a real return
  // (> GUARD_PX of mouse travel or GUARD_PRESSES presses in GUARD_MS, or
  // someone at the desk) keeps it off, anything less brings it back. Real
  // input waits for the camera, which can overrule it (vetoMs); no answer
  // in time, or one that can't tell, leaves it to the input
  if (guardUntilMs) {
    double px = counted("pc.in_px", guardPx0), presses = counted("pc.in_press", guardPress0);
    bool moved = px > GUARD_PX || presses >= GUARD_PRESSES;
    bool up = (int32_t)(now - guardUntilMs) >= 0;
    bool checked = presenceChecks() != guardChecks;
    bool someone = checked && presenceSeen() == PRES_SOMEONE;
    bool veto = checked && presenceSeen() == PRES_NOBODY && moved && (!vetoMs || now - vetoMs >= NIGHT_GUARD_VETO_MS);
    if (someone || (moved && !veto && (checked || up))) {
      guardUntilMs = 0;
      backToNormal(someone ? "someone at the desk" : "input on the PC");
    } else if (veto || up) {
      guardUntilMs = 0;
      falseWakes++;
      if (veto) vetoMs = now | 1;
      logMsg("night: false wake (%.0f px, %.0f presses in %lu s%s)", px, presses, (unsigned long)(GUARD_MS / 1000),
             checked && presenceSeen() == PRES_NOBODY ? ", nobody at the desk" : "");
      reengage();
    }
    return;
  }
  if (!enabled && !engaged) { dueMs = deskSinceMs = 0; return; }
  struct tm t;
  bool haveTime = boardLocalTime(&t);
  bool inWindow = haveTime && (t.tm_hour >= START_HOUR || t.tm_hour < END_HOUR);
  float idle = pcStat("pc.idle_s");
  bool idleKnown = pcStatsFresh() && pcStat("idle.ok") >= 1 && !isnan(idle);

  if (engaged) {
    // input after engaging: idle shorter than the time since (3 s for the
    // feed's lag), so a start by hand right after using the PC still holds.
    // Not while a sleep or hibernate is under way: Windows resets its idle
    // time going down, which read as input (lights up, then a false wake)
    float since = (now - engagedMs) / 1000.0f;
    if (!enabled && !manual) disengage("turned off");
    else if (!inWindow && !manual) disengage("06:00");
    else if (idleKnown && idle + 3 < since && !wokeMs && !hibReqMs && !sleepReqMs) {
      guardPx0 = pcStat("pc.in_px");
      guardPress0 = pcStat("pc.in_press");
      guardChecks = presenceChecks();
      presenceCheckNow();
      if (isnan(guardPx0) || isnan(guardPress0)) {
        disengage("input on the PC");   // a helper without the counters: no guard
      } else {
        guardManual = manual;
        disengage("input on the PC", false);
        guardUntilMs = now + GUARD_MS;
        logMsg("night: input on the PC, off at once, checking for %lu s", (unsigned long)(GUARD_MS / 1000));
      }
    } else if (inWindow) {
      sleepCheck(now);
    }
    return;
  }
  // video guard: no automatic start while something keeps the display on
  bool videoHold = pcStat("pc.disp_req") >= 1;
  if (!inWindow || pcState() != PC_ON || !idleKnown || idle < IDLE_ENGAGE_S || videoHold) {
    dueMs = deskSinceMs = 0;
    return;
  }
  if (!dueMs) {
    dueMs = now ? now : 1;
    dueChecks = presenceChecks();
  }
  bool checked = presenceChecks() != dueChecks;
  if (!checked && now - dueMs < FIRST_CHECK_MS) return;
  int seen = checked ? presenceSeen() : PRES_UNKNOWN;
  if (seen == PRES_SOMEONE && !deskSinceMs) {
    deskSinceMs = now ? now : 1;
    logMsg("night: idle, but someone at the desk: held for %d min", NIGHT_DESK_HOLD_S / 60);
  }
  if (seen == PRES_NOBODY && !presenceNobody()) return;   // one more check first
  if (deskSinceMs && seen != PRES_NOBODY) {
    char why[64];
    if (now - deskSinceMs < DESK_HOLD_MS || *sleepHold(why, sizeof why)) return;
  }
  engage(false);
}

void nightSetEnabled(bool on) {
  enabled = on;
  saveNvs();
  logMsg("night: mode %s", on ? "on" : "off");
  char win[40], what[96];
  nightWindowText(win, sizeof win);
  snprintf(what, sizeof what, "Turned on: engages %s without input on the PC", win);
  announce(on ? what : "Turned off", 0x95A5A6);
  if (!on && guardUntilMs && !guardManual) {
    guardUntilMs = 0;   // the wake being checked can't bring an automatic night back now
    backToNormal("turned off");
  }
  if (!on && engaged) disengage("turned off");
}

void nightManual(bool on) {
  if (guardUntilMs) {
    guardUntilMs = 0;   // a wake being checked: decided by hand
    if (!on) backToNormal("ended by hand");
  }
  if (on && !engaged) engage(true);
  else if (!on && engaged) disengage("ended by hand");
}

void nightSleepHold(char *buf, uint32_t size) { sleepHold(buf, size); }

void nightLowPower(bool on, const char *why, bool pcOnly) {
  // on by hand over the desk rule's PC-only one: the full mode, kept until turned off
  if (on == lowPower && !(on && lowPcOnly && !pcOnly)) return;
  bool upgrade = on && lowPower, wasPcOnly = lowPcOnly;
  lowPower = on;
  lowPcOnly = on && pcOnly;
  saveNvs();
  boardSide();
  lassoSend();
  char rgbPct[8], what[240];
  snprintf(rgbPct, sizeof rgbPct, "%d %%", RGB_PCT);
  if (on && lowPcOnly) {
    struct tm t;
    lowPowerAtMin = boardLocalTime(&t) ? t.tm_hour * 60 + t.tm_min : 0;
    logMsg("night: low power mode on %s, PC only", why);
    snprintf(what, sizeof what, "On %s: Process Lasso night config (E-cores, efficiency mode) on the PC only; PC LEDs, board panels and status LED unchanged", why);
    discordPost(DC_PC, "Low power mode", what, 0x2C3E50);
    return;
  }
  if (on) {
    struct tm t;
    if (!upgrade) lowPowerAtMin = boardLocalTime(&t) ? t.tm_hour * 60 + t.tm_min : 0;
    rgbLower();
    lowRgbPending = !rgbLowered && !pcReachable();   // PC off or PcHwCtl not up: lower when it is
    logMsg("night: low power mode on %s (PC LEDs %s)", why, rgbLowered ? rgbPct : "unchanged");
    snprintf(what, sizeof what, "On %s: Process Lasso night config (E-cores, efficiency mode), PC LEDs %s, board panels %d %%, status LED %d %%",
             why, rgbLowered ? rgbPct : lowRgbPending ? "10 % once PcHwCtl answers" : "unchanged", PANEL_PCT, STATUS_LED_PCT);
    discordPost(DC_PC, "Low power mode", what, 0x2C3E50);
    return;
  }
  lowRgbPending = false;
  if (engaged) {
    logMsg("night: low power mode off %s, night mode still engaged", why);
    snprintf(what, sizeof what, "Off %s; night mode is still engaged", why);
    discordPost(DC_PC, "Low power mode", what, 0xF1C40F);
    return;
  }
  rgbRestoreTry(false);
  logMsg("night: low power mode off %s%s", why, rgbLowered ? ", PC LEDs go back when PcHwCtl answers" : "");
  snprintf(what, sizeof what, "Off %s: Process Lasso day config%s%s", why,
           wasPcOnly ? "" : ", panels and status LED back to normal", rgbLowered ? "; PC LEDs go back once the PC is on" : "");
  discordPost(DC_PC, "Low power mode", what, 0xF1C40F);
}

bool nightLowPowerOn() { return lowPower; }
bool nightLowPowerPcOnly() { return lowPower && lowPcOnly; }

void nightLowPowerStatus(char *buf, uint32_t size) {
  if (lowPower && lowPcOnly)
    snprintf(buf, size, "on since %02lu:%02lu, PC only (Lasso night config; nobody at the desk)",
             (unsigned long)(lowPowerAtMin / 60), (unsigned long)(lowPowerAtMin % 60));
  else if (lowPower)
    snprintf(buf, size, "on since %02lu:%02lu (Lasso night config, LEDs %d %%, panels %d %%, status LED %d %%)",
             (unsigned long)(lowPowerAtMin / 60), (unsigned long)(lowPowerAtMin % 60), RGB_PCT, PANEL_PCT, STATUS_LED_PCT);
  else
    snprintf(buf, size, "off");
}

bool nightEnabled() { return enabled; }

bool nightCovers() {
  struct tm t;
  return enabled && boardLocalTime(&t) && (t.tm_hour >= START_HOUR || t.tm_hour < END_HOUR);
}
bool nightEngaged() { return engaged; }

void nightStatus(char *buf, uint32_t size) {
  uint32_t now = nowMs();
  if (sleptAtMs || wokeMs)
    snprintf(buf, size, wokeMs ? "PC woken to hibernate (you left home)"
                        : powerHibernateOn() == 0 ? "PC asleep (hibernation off on the PC)"
                                                  : "PC asleep, hibernated when you leave home");
  else if (guardUntilMs)
    snprintf(buf, size, "off for input on the PC, back on in %lu s unless it is used",
             (unsigned long)((int32_t)(guardUntilMs - now) > 0 ? (guardUntilMs - now) / 1000 + 1 : 0));
  else if (engaged) {
    char sleep[48] = "", why[64];
    uint32_t inactive = now - inputAtMs;
    bool nobody = !manual && presenceNobody();
    if (*sleepHold(why, sizeof why) && (inactive >= SLEEP_MS || nobody)) snprintf(sleep, sizeof sleep, ", sleep held: %.28s", why);
    else if (nobody) snprintf(sleep, sizeof sleep, ", nobody at the desk: sleeping");
    else if (inactive < SLEEP_MS) snprintf(sleep, sizeof sleep, ", sleep in %lu min", (unsigned long)((SLEEP_MS - inactive) / 60000 + 1));
    snprintf(buf, size, "engaged since %02lu:%02lu%s%s%s", (unsigned long)(engagedAtMin / 60),
             (unsigned long)(engagedAtMin % 60), manual ? ", by hand" : "",
             falseWakes ? ", false wakes ignored" : "", sleep);
  }
  else if (enabled && deskSinceMs) {
    uint32_t held = now - deskSinceMs;
    if (held < DESK_HOLD_MS) snprintf(buf, size, "on, held off: someone at the desk (%lu min left)", (unsigned long)((DESK_HOLD_MS - held) / 60000 + 1));
    else snprintf(buf, size, "on, held off: someone at the desk, sleep blocked");
  }
  else if (enabled && pcStat("pc.disp_req") >= 1) {
    char by[48];
    pcTextCopy("pc.disp_req_by", by, sizeof by);
    snprintf(buf, size, "on, held off: %.20s keeps the display on", by);
  }
  else if (enabled) {
    char win[40];
    nightWindowText(win, sizeof win);
    snprintf(buf, size, "on: %s idle%s", win, rgbLowered ? ", LED restore owed" : "");
  }
  else
    snprintf(buf, size, "off%s", rgbLowered ? ", LED restore owed" : "");
}

void nightConsole(const char *args) {
  while (args && *args == ' ') args++;
  char st[128], why[64];
  if (args && !strcmp(args, "on")) nightSetEnabled(true);
  else if (args && !strcmp(args, "off")) nightSetEnabled(false);
  else if (args && (!strcmp(args, "start") || !strcmp(args, "test"))) nightManual(true);
  else if (args && !strcmp(args, "end")) nightManual(false);
  else if (args && !strcmp(args, "low on")) nightLowPower(true);
  else if (args && !strcmp(args, "low off")) nightLowPower(false);
  else if (args && *args && strcmp(args, "status")) {
    logMsg("night: usage night [on|off|start|end|low on|low off|status]");
    return;
  }
  nightStatus(st, sizeof st);
  float idle = pcStat("pc.idle_s");
  char low[112];
  nightLowPowerStatus(low, sizeof low);
  logMsg("night: low power %s", low);
  logMsg("night: %s | PC idle %s%.0f s, input %.0f px / %.0f presses, requests display %.0f system %.0f execution %.0f, heavy %.0f, net %.2f MB/s | %s",
         st, pcStat("idle.ok") >= 1 ? "" : "(stale) ", isnan(idle) ? -1.0f : idle, pcStat("pc.in_px"),
         pcStat("pc.in_press"), pcStat("pc.disp_req"), pcStat("pc.sys_req"), pcStat("pc.exec_req"), pcStat("pc.heavy"),
         netAvg / 1e6f, *sleepHold(why, sizeof why) ? why : "sleep not held");
}
