lnminh1411/ESP32-PC-Control-System/firmware/main/power.cpp

#include "power.h"

#include <esp_random.h>
#include <math.h>
#include <nvs.h>
#include <stdio.h>
#include <string.h>
#include <strings.h>

#include "config.h"
#include "discord.h"
#include "display.h"
#include "log.h"
#include "net.h"
#include "night.h"
#include "pc_state.h"
#include "pcstats.h"
#include "sys.h"
#include "usb.h"
#include "views.h"
#include "settings_or_example.h"
#include "wol.h"

static const char *powerWakeSend();

// Motherboard quirk: the PC's power-on drags the USB 5 V rail down and the
// board browns out. Every wake turns the backlights off while it goes out and
// for this long after (always on since 2026-10-27, after it came back).
static const uint32_t WAKE_DIM_MS = POWER_WAKE_DIM_MS;

static bool s_pending = false;
static bool s_quiet;                     // this request posts nothing when accepted
static char s_action[16] = "";
static char s_nonce[16] = "";
static uint32_t s_reqTimeMs = 0;

// Hibernation on the PC (pc.hib from the helper: S4 and a hiberfile), kept in
// NVS so it is known while the PC is off. -1 = never heard
static int8_t s_hib = -2;   // -2: NVS not read yet

static void hibFollow() {
  if (s_hib == -2) {
    s_hib = -1;
    nvs_handle_t h;
    if (nvs_open("power", NVS_READONLY, &h) == ESP_OK) {
      nvs_get_i8(h, "hib", &s_hib);
      nvs_close(h);
    }
  }
  double v = pcStat("pc.hib");
  if (isnan(v)) return;
  int8_t hib = v >= 0.5 ? 1 : 0;
  static bool dirty;
  static uint32_t savedMs;
  if (hib != s_hib) {
    logMsg("power: hibernation on the PC is %s", hib ? "on" : "off");
    s_hib = hib;
    dirty = true;
  }
  // at most one flash write a minute (a flipping value can't wear NVS out)
  if (!dirty || (savedMs && nowMs() - savedMs < 60000)) return;
  dirty = false;
  savedMs = nowMs() | 1;
  nvs_handle_t h;
  if (nvs_open("power", NVS_READWRITE, &h) == ESP_OK) {
    nvs_set_i8(h, "hib", s_hib);
    nvs_commit(h);
    nvs_close(h);
  }
}

int powerHibernateOn() { return s_hib < 0 ? -1 : s_hib; }   // read by other tasks: hibFollow stays in powerPoll's

const char *powerLockQuiet() {
  const char *err = powerRequest("lock");
  if (!err) s_quiet = true;
  return err;
}

const char *powerRequest(const char *action) {
  if (!action || !*action) return "action required";

  bool isSleep = !strcmp(action, "sleep");
  bool isHibernate = !strcmp(action, "hibernate");
  bool isRestart = !strcmp(action, "restart");
  bool isShutdown = !strcmp(action, "shutdown");
  bool isLock = !strcmp(action, "lock");   // service only: locks the signed-in session

  if (!isSleep && !isHibernate && !isRestart && !isShutdown && !isLock) {
    return "unknown action (must be sleep, hibernate, restart, shutdown, lock)";
  }
  if (isHibernate && powerHibernateOn() == 0) return "hibernation is off on the PC (powercfg /h on)";

  if (pcState() != PC_ON && !pcStatsFresh()) {
    return "PC not on";
  }

  if (s_pending) {
    return "another request pending";
  }

  if (pcStatsFresh()) {
    uint32_t r = esp_random();
    snprintf(s_nonce, sizeof(s_nonce), "%lx", (unsigned long)r);
    strncpy(s_action, action, sizeof(s_action) - 1);
    s_action[sizeof(s_action) - 1] = '\0';

    char line[64];
    snprintf(line, sizeof(line), "!power %s %s\n", action, s_nonce);
    if (!usbPcSendLine(line)) {
      s_pending = false;
      s_nonce[0] = '\0';
      return "USB send failed";
    }

    s_pending = true;
    s_quiet = false;
    s_reqTimeMs = nowMs();
    logMsg("power: requesting %s (nonce %s)", action, s_nonce);
    return nullptr;
  }

  // Fallback without the service
  if (isSleep) {
    logMsg("power: sending sleep key (Windows applies power/sleep button settings)");
    if (!usbSystemControl(2)) {
      return "USB System Control sleep failed";
    }
    viewsNoteAction("PC sleep (key)");
    discordNotify("PC sleep (key)");
    return nullptr;
  } else if (isShutdown) {
    logMsg("power: sending power down key (Windows applies power/sleep button settings)");
    if (!usbSystemControl(1)) {
      return "USB System Control power down failed";
    }
    viewsNoteAction("PC shutdown (key)");
    discordNotify("PC shutdown (key)");
    return nullptr;
  } else {
    return "needs the PC stats service";
  }
}

void powerPoll() {
  hibFollow();
  if (!s_pending) return;

  const char *ack = pcText("power.ack");
  if (ack && *ack) {
    char w1[32], w2[32];
    if (sscanf(ack, "%31s %31s", w1, w2) == 2) {
      if (!strcmp(w1, s_action) && !strcasecmp(w2, s_nonce)) {
        logMsg("power: PC accepted %s", s_action);
        char note[48];
        snprintf(note, sizeof(note), "PC accepted %s", s_action);
        viewsNoteAction(note);
        if (!nightPowerQuiet() && !s_quiet) discordNotify(note);   // night mode and presence post their own
        s_pending = false;
        s_nonce[0] = '\0';
        return;
      } else if (!strcmp(w1, "error") && !strcasecmp(w2, s_nonce)) {
        const char *reason = strstr(ack, s_nonce);
        if (reason) {
          reason += strlen(s_nonce);
          while (*reason == ' ') reason++;
        }
        if (!reason || !*reason) reason = "refused";
        logMsg("power: PC refused %s (%s)", s_action, reason);
        char note[48];
        snprintf(note, sizeof(note), "PC refused %s", s_action);
        viewsNoteAction(note);
        char msg[160];   // with PcHwCtl's reason: "Hibernation is off.", "PcHwCtl offline, use Reset", ...
        snprintf(msg, sizeof msg, "PC refused %s: %.120s", s_action, reason);
        discordNotify(msg);
        s_pending = false;
        s_nonce[0] = '\0';
        return;
      }
    }
  }

  if (nowMs() - s_reqTimeMs >= POWER_ACK_TIMEOUT_MS) {
    if (!strcmp(s_action, "sleep")) {
      logMsg("power: no answer from PC service, falling back to sleep key (Windows applies power/sleep button settings)");
      if (usbSystemControl(2)) {
        viewsNoteAction("PC sleep (key)");
        discordNotify("PC sleep (key)");
      } else {
        logMsg("power: fallback sleep key failed");
        viewsNoteAction("PC sleep failed");
        discordNotify("PC sleep failed");
      }
    } else if (!strcmp(s_action, "shutdown")) {
      logMsg("power: no answer from PC service, falling back to power down key (Windows applies power/sleep button settings)");
      if (usbSystemControl(1)) {
        viewsNoteAction("PC shutdown (key)");
        discordNotify("PC shutdown (key)");
      } else {
        logMsg("power: fallback power down key failed");
        viewsNoteAction("PC shutdown failed");
        discordNotify("PC shutdown failed");
      }
    } else {
      logMsg("power: no answer from the PC service");
      char note[48];
      snprintf(note, sizeof(note), "power %s timed out", s_action);
      viewsNoteAction(note);
      discordNotify(note);
    }
    s_pending = false;
    s_nonce[0] = '\0';
  }
}

// Ask the PC stats service for a one-off screenshot to #logging. Fire and
// forget over HID; the service (and its user-session helper) does the rest,
// and auto-deletes the post after 5 minutes. No ack/retry here.
const char *screenshotRequest() {
  if (!DISCORD_SHOT_WEBHOOK[0]) return "no screenshot webhook in settings.h";
  if (!pcStatsFresh()) return "PC offline (service not connected)";
  uint32_t r = esp_random();
  char nonce[16];
  snprintf(nonce, sizeof nonce, "%lx", (unsigned long)r);
  // !shot <nonce>: the helper has the webhook (compiled in from settings.h), so
  // it never crosses USB, where another PC process could read it off HID.
  // PcHwCtl captures, posts and auto-deletes after 5 min
  char line[32];
  snprintf(line, sizeof line, "!shot %s\n", nonce);
  if (!usbPcSendLine(line)) return "USB send failed";
  logMsg("shot: screenshot requested (nonce %s)", nonce);
  return nullptr;
}

const char *powerWake() {
  bool wasIdle = backlightIsIdle();
  backlightIdle(true);
  logMsg("wake: backlights off for the wake");
  const char *err = powerWakeSend();
  sleepMs(WAKE_DIM_MS);
  backlightIdle(wasIdle);
  logMsg("wake: backlights restored");
  return err;
}

static const char *powerWakeSend() {
  bool usbAttempted = false;
  bool usbOk = false;
  if (usbSuspended()) {
    usbAttempted = true;
    usbOk = usbRemoteWakeup();
    logMsg("wake: usb remote wakeup %s", usbOk ? "sent" : "failed");
  }

  bool wolAttempted = false;
  const char *wolErr = nullptr;
  if (netUp()) {
    wolAttempted = true;
    wolErr = wolSend();
  }

  if ((usbAttempted && usbOk) || (wolAttempted && !wolErr)) {
    viewsNoteAction("wake PC");
    if (!nightPowerQuiet()) discordNotify("wake PC");   // night mode posts its own
    return nullptr;
  }

  static char errBuf[128];
  const char *mac = wolMacStr();
  bool hasMac = (mac && *mac);

  if (!usbAttempted && !wolAttempted) {
    if (!netUp() && !hasMac) {
      snprintf(errBuf, sizeof(errBuf), "no MAC known, network down and USB not suspended");
    } else if (!hasMac) {
      snprintf(errBuf, sizeof(errBuf), "no MAC known and USB not suspended");
    } else {
      snprintf(errBuf, sizeof(errBuf), "network down and USB not suspended");
    }
  } else if (!usbAttempted) {
    snprintf(errBuf, sizeof(errBuf), "USB not suspended, WoL: %s", wolErr ? wolErr : "failed");
  } else if (!wolAttempted) {
    if (!netUp()) {
      snprintf(errBuf, sizeof(errBuf), "USB remote wakeup %s, network down", usbOk ? "sent" : "failed");
    } else {
      snprintf(errBuf, sizeof(errBuf), "USB remote wakeup %s, no MAC known", usbOk ? "sent" : "failed");
    }
  } else {
    snprintf(errBuf, sizeof(errBuf), "USB remote wakeup %s, WoL: %s", usbOk ? "sent" : "failed", wolErr ? wolErr : "failed");
  }
  return errBuf;
}
