lnminh1411/ESP32-PC-Control-System/firmware/main/layout.cpp

// Dashboard layout engine implementation.
// Parses JSON layouts, manages page/widget structs in PSRAM, and executes differential redraws.
#include "layout.h"

#include <cJSON.h>
#include <esp_heap_caps.h>
#include <freertos/FreeRTOS.h>
#include <freertos/semphr.h>
#include <math.h>
#include <mbedtls/base64.h>
#include <stdio.h>
#include <stdlib.h>
#include <string.h>

#include <LovyanGFX.hpp>

#include "config.h"
#include "fonts.h"
#include "log.h"
#include "pcstats.h"
#include "sys.h"
#include "views.h"

#define MAX_PAGES 6
#define MAX_WIDGETS_PER_PAGE 32
#define UPLOAD_BUF_SIZE 24576

enum WidgetType : uint8_t {
  WIDGET_LABEL,
  WIDGET_VALUE,
  WIDGET_TEXT,
  WIDGET_BAR,
  WIDGET_SPARK,
  WIDGET_LINE,
};

enum WidgetFont : uint8_t {
  FONT_SMALL,
  FONT_BODY,
  FONT_HEAD,
  FONT_BIG,
};

enum WidgetAlign : uint8_t {
  ALIGN_LEFT,
  ALIGN_CENTER,
  ALIGN_RIGHT,
};

struct Widget {
  WidgetType type;
  WidgetFont font;
  WidgetAlign align;
  int16_t x, y;
  int16_t w, h;
  uint16_t color;
  uint16_t bg;
  bool has_bg;
  uint16_t warn_color;
  uint16_t bad_color;
  double min_val, max_val;
  double warn_val, bad_val;
  double scale;
  char key[24];
  char text[44];
  char fmt[24];
  char unit[12];

  // Sparkline history ring buffer
  uint16_t spark_samples;
  uint16_t spark_count;
  uint16_t spark_head;
  float *spark_ring;
  uint32_t spark_last_seq;

  // Diff cache
  char last_text[64];
  int16_t last_fill_w;
  uint16_t last_color;
  uint32_t last_drawn_seq;
};

struct Page {
  uint16_t bg;
  uint8_t widget_count;
  Widget widgets[MAX_WIDGETS_PER_PAGE];
};

struct Layout {
  uint8_t page_count;
  bool is_default;
  bool page_drawn[MAX_PAGES];
  Page pages[MAX_PAGES];
};

static void freeLayout(struct Layout *l);
static Layout *activeLayout = nullptr;
// PUT /layout runs in the HTTP task: the swap must not free a layout core 1 is drawing
static SemaphoreHandle_t layoutLock;

static void lock() {
  if (!layoutLock) layoutLock = xSemaphoreCreateMutex();
  xSemaphoreTake(layoutLock, portMAX_DELAY);
}
static void unlock() { xSemaphoreGive(layoutLock); }

// One apply at a time (PUT /layout in the HTTP task, the console upload on
// core 1): both write /ffat/layout.tmp. Separate from layoutLock so the file
// write never holds up drawing.
static SemaphoreHandle_t applyLock;

static void swapLayout(Layout *l) {
  lock();
  Layout *old = activeLayout;
  activeLayout = l;
  unlock();
  freeLayout(old);
  viewsMarkDirty(-1);
}

// fmt is handed a double: allow exactly one floating conversion (plus %%), nothing else
static bool fmtValid(const char *f) {
  int conv = 0;
  for (; *f; f++) {
    if (*f != '%') continue;
    if (*++f == '%') continue;
    while (*f && strchr("-+ #0", *f)) f++;
    while (*f >= '0' && *f <= '9') f++;
    if (*f == '.') for (f++; *f >= '0' && *f <= '9'; f++) {}
    if (!*f || !strchr("fFeEgG", *f)) return false;
    conv++;
  }
  return conv == 1;
}
static char *uploadBuf = nullptr;
static size_t uploadLen = 0;

static const char BUILTIN_LAYOUT_JSON[] = R"json({
  "pages": [
    {
      "bg": "#000000",
      "widgets": [
        {"type":"label", "x":8, "y":6, "font":"head", "color":"#58A6FF", "text":"SYSTEM"},
        {"type":"line",  "x":8, "y":30, "w":224, "color":"#333333"},
        {"type":"label", "x":8, "y":36, "font":"small", "color":"#888888", "text":"CPU"},
        {"type":"value", "x":8, "y":50, "font":"big", "key":"cpu_temp", "fmt":"%.0f\u00b0C", "color":"#FFFFFF", "warn":75, "bad":90, "warn_color":"#FFA500", "bad_color":"#FF3030", "w":100, "align":"left"},
        {"type":"value", "x":120, "y":50, "font":"big", "key":"cpu_load", "fmt":"%.0f%%", "color":"#FFFFFF", "warn":80, "bad":95, "warn_color":"#FFA500", "bad_color":"#FF3030", "w":112, "align":"right"},
        {"type":"bar",   "x":8, "y":82, "w":224, "h":8, "key":"cpu_load", "min":0, "max":100, "color":"#3FB950", "bg":"#222222", "warn":80, "bad":95},
        {"type":"spark", "x":8, "y":94, "w":224, "h":30, "key":"cpu_load", "min":0, "max":100, "samples":60, "color":"#58A6FF"},
        {"type":"label", "x":8, "y":128, "font":"small", "color":"#888888", "text":"Clock"},
        {"type":"value", "x":50, "y":128, "font":"small", "key":"cpu_clock", "fmt":"%.0f MHz", "color":"#CCCCCC", "w":70, "align":"left"},
        {"type":"label", "x":130, "y":128, "font":"small", "color":"#888888", "text":"Fan"},
        {"type":"value", "x":160, "y":128, "font":"small", "key":"cpu_fan", "fmt":"%.0f RPM", "color":"#CCCCCC", "w":72, "align":"right"},
        {"type":"line",  "x":8, "y":144, "w":224, "color":"#333333"},
        {"type":"label", "x":8, "y":150, "font":"small", "color":"#888888", "text":"RAM"},
        {"type":"value", "x":8, "y":164, "font":"body", "key":"ram_used", "fmt":"%.1f GB", "color":"#FFFFFF", "w":100, "align":"left"},
        {"type":"value", "x":120, "y":164, "font":"body", "key":"ram_load", "fmt":"%.0f%%", "color":"#FFFFFF", "warn":80, "bad":90, "warn_color":"#FFA500", "bad_color":"#FF3030", "w":112, "align":"right"},
        {"type":"bar",   "x":8, "y":184, "w":224, "h":8, "key":"ram_load", "min":0, "max":100, "color":"#3FB950", "bg":"#222222", "warn":80, "bad":90},
        {"type":"line",  "x":8, "y":198, "w":224, "color":"#333333"},
        {"type":"label", "x":8, "y":204, "font":"small", "color":"#888888", "text":"DISK C:"},
        {"type":"value", "x":8, "y":218, "font":"body", "key":"c_used", "fmt":"%.0f GB", "color":"#FFFFFF", "w":100, "align":"left"},
        {"type":"label", "x":112, "y":218, "font":"body", "color":"#666666", "text":"/ "},
        {"type":"value", "x":124, "y":218, "font":"body", "key":"c_total", "fmt":"%.0f GB", "color":"#888888", "w":108, "align":"right"},
        {"type":"line",  "x":8, "y":240, "w":224, "color":"#333333"},
        {"type":"label", "x":8, "y":246, "font":"small", "color":"#888888", "text":"UPTIME"},
        {"type":"value", "x":60, "y":246, "font":"small", "key":"uptime", "fmt":"%.1f h", "scale":0.000277777778, "color":"#CCCCCC", "w":172, "align":"right"},
        {"type":"label", "x":8, "y":266, "font":"small", "color":"#888888", "text":"PLAN"},
        {"type":"text",  "x":8, "y":282, "font":"small", "key":"claude.plan", "w":224, "color":"#58A6FF"}
      ]
    },
    {
      "bg": "#000000",
      "widgets": [
        {"type":"label", "x":8, "y":6, "font":"head", "color":"#58A6FF", "text":"GRAPHICS & NET"},
        {"type":"line",  "x":8, "y":30, "w":224, "color":"#333333"},
        {"type":"label", "x":8, "y":36, "font":"small", "color":"#888888", "text":"GPU 1"},
        {"type":"value", "x":8, "y":48, "font":"big", "key":"gpu1_temp", "fmt":"%.0f\u00b0C", "color":"#FFFFFF", "warn":75, "bad":85, "warn_color":"#FFA500", "bad_color":"#FF3030", "w":100, "align":"left"},
        {"type":"value", "x":120, "y":48, "font":"big", "key":"gpu1_load", "fmt":"%.0f%%", "color":"#FFFFFF", "warn":85, "bad":95, "warn_color":"#FFA500", "bad_color":"#FF3030", "w":112, "align":"right"},
        {"type":"bar",   "x":8, "y":78, "w":224, "h":8, "key":"gpu1_load", "min":0, "max":100, "color":"#3FB950", "bg":"#222222", "warn":85, "bad":95},
        {"type":"spark", "x":8, "y":90, "w":224, "h":28, "key":"gpu1_load", "min":0, "max":100, "samples":60, "color":"#58A6FF"},
        {"type":"label", "x":8, "y":122, "font":"small", "color":"#888888", "text":"VRAM"},
        {"type":"value", "x":48, "y":122, "font":"small", "key":"gpu1_vram", "fmt":"%.0f MB", "color":"#CCCCCC", "w":70, "align":"left"},
        {"type":"label", "x":128, "y":122, "font":"small", "color":"#888888", "text":"Clk"},
        {"type":"value", "x":156, "y":122, "font":"small", "key":"gpu1_clock", "fmt":"%.0f MHz", "color":"#CCCCCC", "w":76, "align":"right"},
        {"type":"line",  "x":8, "y":138, "w":224, "color":"#333333"},
        {"type":"label", "x":8, "y":144, "font":"small", "color":"#888888", "text":"GPU 2"},
        {"type":"value", "x":50, "y":144, "font":"small", "key":"gpu2_temp", "fmt":"%.0f\u00b0C", "color":"#FFFFFF", "w":50, "align":"left"},
        {"type":"value", "x":104, "y":144, "font":"small", "key":"gpu2_load", "fmt":"%.0f%%", "color":"#FFFFFF", "w":50, "align":"left"},
        {"type":"value", "x":160, "y":144, "font":"small", "key":"gpu2_vram", "fmt":"%.0fMB", "color":"#CCCCCC", "w":72, "align":"right"},
        {"type":"bar",   "x":8, "y":158, "w":224, "h":5, "key":"gpu2_load", "min":0, "max":100, "color":"#3FB950", "bg":"#222222"},
        {"type":"label", "x":8, "y":168, "font":"small", "color":"#888888", "text":"iGPU Load"},
        {"type":"value", "x":140, "y":168, "font":"small", "key":"igpu_load", "fmt":"%.0f%%", "color":"#FFFFFF", "w":92, "align":"right"},
        {"type":"bar",   "x":8, "y":182, "w":224, "h":5, "key":"igpu_load", "min":0, "max":100, "color":"#3FB950", "bg":"#222222"},
        {"type":"line",  "x":8, "y":192, "w":224, "color":"#333333"},
        {"type":"label", "x":8, "y":198, "font":"small", "color":"#888888", "text":"NET DOWN"},
        {"type":"value", "x":90, "y":198, "font":"small", "key":"net_down", "fmt":"%.1f KB/s", "scale":0.0009765625, "color":"#3FB950", "w":142, "align":"right"},
        {"type":"spark", "x":8, "y":212, "w":224, "h":36, "key":"net_down", "scale":0.0009765625, "min":0, "max":5000, "samples":60, "color":"#3FB950"},
        {"type":"label", "x":8, "y":254, "font":"small", "color":"#888888", "text":"NET UP"},
        {"type":"value", "x":90, "y":254, "font":"small", "key":"net_up", "fmt":"%.1f KB/s", "scale":0.0009765625, "color":"#58A6FF", "w":142, "align":"right"},
        {"type":"spark", "x":8, "y":268, "w":224, "h":36, "key":"net_up", "scale":0.0009765625, "min":0, "max":2000, "samples":60, "color":"#58A6FF"}
      ]
    },
    {
      "bg": "#000000",
      "widgets": [
        {"type":"label", "x":8, "y":6, "font":"head", "color":"#D29922", "text":"AI STATUS"},
        {"type":"line",  "x":8, "y":30, "w":224, "color":"#333333"},
        {"type":"label", "x":8, "y":36, "font":"small", "color":"#888888", "text":"Claude Session"},
        {"type":"value", "x":140, "y":36, "font":"body", "key":"claude.s_pct", "fmt":"%.0f%%", "color":"#FFFFFF", "warn":75, "bad":90, "warn_color":"#FFA500", "bad_color":"#FF3030", "w":92, "align":"right"},
        {"type":"bar",   "x":8, "y":54, "w":224, "h":8, "key":"claude.s_pct", "min":0, "max":100, "color":"#58A6FF", "bg":"#222222", "warn":75, "bad":90},
        {"type":"label", "x":8, "y":66, "font":"small", "color":"#666666", "text":"Reset:"},
        {"type":"text",  "x":52, "y":66, "font":"small", "key":"claude.s_reset_at", "w":180, "color":"#AAAAAA"},
        {"type":"label", "x":8, "y":84, "font":"small", "color":"#888888", "text":"Claude Weekly"},
        {"type":"value", "x":140, "y":84, "font":"body", "key":"claude.w_pct", "fmt":"%.0f%%", "color":"#FFFFFF", "warn":80, "bad":95, "warn_color":"#FFA500", "bad_color":"#FF3030", "w":92, "align":"right"},
        {"type":"bar",   "x":8, "y":102, "w":224, "h":8, "key":"claude.w_pct", "min":0, "max":100, "color":"#3FB950", "bg":"#222222", "warn":80, "bad":95},
        {"type":"label", "x":8, "y":114, "font":"small", "color":"#666666", "text":"Reset:"},
        {"type":"text",  "x":52, "y":114, "font":"small", "key":"claude.w_reset_at", "w":180, "color":"#AAAAAA"},
        {"type":"line",  "x":8, "y":132, "w":224, "color":"#333333"},
        {"type":"label", "x":8, "y":138, "font":"small", "color":"#888888", "text":"AGY Flash Quota"},
        {"type":"value", "x":140, "y":138, "font":"body", "key":"agy2.flash_pct", "fmt":"%.0f%%", "color":"#FFFFFF", "warn":80, "bad":95, "warn_color":"#FFA500", "bad_color":"#FF3030", "w":92, "align":"right"},
        {"type":"bar",   "x":8, "y":156, "w":224, "h":8, "key":"agy2.flash_pct", "min":0, "max":100, "color":"#BC8CFF", "bg":"#222222", "warn":80, "bad":95},
        {"type":"label", "x":8, "y":168, "font":"small", "color":"#666666", "text":"Reset:"},
        {"type":"text",  "x":52, "y":168, "font":"small", "key":"agy2.flash_reset_at", "w":180, "color":"#AAAAAA"},
        {"type":"line",  "x":8, "y":186, "w":224, "color":"#333333"},
        {"type":"label", "x":8, "y":192, "font":"small", "color":"#888888", "text":"AGY ACCOUNT"},
        {"type":"text",  "x":8, "y":208, "font":"body", "key":"agy.active", "w":224, "color":"#58A6FF"},
        {"type":"label", "x":8, "y":230, "font":"small", "color":"#888888", "text":"CLAUDE PLAN"},
        {"type":"text",  "x":8, "y":246, "font":"small", "key":"claude.plan", "w":224, "color":"#E6EDF3"},
        {"type":"label", "x":8, "y":264, "font":"small", "color":"#888888", "text":"LOCAL AGENT / GUARD"},
        {"type":"text",  "x":8, "y":280, "font":"small", "key":"ai.phase_name", "w":224, "color":"#8B949E"},
        {"type":"text",  "x":8, "y":296, "font":"small", "key":"ai.guard_name", "w":224, "color":"#FFA500"}
      ]
    }
  ]
})json";

static uint16_t parseColor(const char *str, uint16_t def) {
  if (!str) return def;
  if (*str == '#') str++;
  if (strlen(str) != 6) return def;
  unsigned int r = 0, g = 0, b = 0;
  if (sscanf(str, "%02x%02x%02x", &r, &g, &b) == 3) {
    return (uint16_t)(((r & 0xF8) << 8) | ((g & 0xFC) << 3) | (b >> 3));
  }
  return def;
}

static const lgfx::IFont *getFont(WidgetFont wf) {
  switch (wf) {
    case FONT_SMALL: return fontSmall();
    case FONT_BODY:  return fontBody();
    case FONT_HEAD:  return fontHead();
    case FONT_BIG:   return fontBig();
    default:         return fontSmall();
  }
}
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
