lnminh1411/ESP32-PC-Control-System/(commit log)

2026-09-29 Initial commit: ESP32 PC Control System
    Parametric CAD (OpenSCAD), atopile carrier PCB, hand-drawn circuit
    reference, and firmware test sketch for a dual-ESP32 (SuperMini S3 +
    DevKit V1) PC controller: USB HID/WoL wake, hardware reset via
    optocoupler, SPI status display, rolling-door remote via RF fob
    emulation.
2026-10-02 feat(pcb): rev 3.3 board layout with scripted build chain
    - Rotate module 180deg (USB-C on top edge), L-shaped 66.6x122.2mm board
    - Displays plug in directly at 47mm pitch down the east edge
    - Display bus hand-routed on F.Cu as a true daisy chain, no vias/stubs
    - THT 33R series resistors on SCK/MOSI, 10k pull-downs on all opto GPIOs
    - Boost module on male pins under the DevKit (4.5mm clearance)
    - All 90deg track corners chamfered to 45deg
    - Assembly silkscreen: values, PC817 pin-1 dots, module orientation
    - Scripts: blank -> sync -> layout -> pours -> route_spi -> Freerouting
    -> chamfer -> topology check -> renders; DRC 0 violations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
2026-10-02 feat(firmware): add S3 bench sketches for GIF display and USB power state
    - s3_gif_player / s3_gif_player_lovyan: flash-embedded RLE GIF playback
    - s3_gif_wifi_player: RGB565 frames streamed over WiFi (diagnostic)
    - s3_usb_state_test: PC power-state detection via the S3 USB PHY
    - WiFi credentials moved to gitignored secrets.h (secrets.example.h template)
2026-10-02 docs: add GIF bring-up, USB power-detection notes and idea log
2026-10-02 chore(diagrams): remove old circuit image superseded by pcb/main.ato
2026-10-03 feat(pcb): rev 2.3 - shrink board to 56.2x114.2mm, per-display RST
    - Drop the 1x16 spare-GPIO header; move the keyfob socket to the west
    edge under the RST pair so the west strip is one RA socket deep.
    - Pull the display column in from XR+11 to XR+6.25 (8 bus lanes at
    0.5mm). Both 33R stay flat: MOSI's on the top row, bus pads east of
    the right lanes.
    - Display pitch 47 -> 43mm (37mm panel confirmed, 6mm gap).
    - Per-display RST: RST1=GPIO10, RST2=GPIO16, RST3=GPIO15 (was shared
    GPIO10). RST1 hand-routed, RST2/3 Freerouted.
    - Board refs derived from atopile instance names (J1-J7, PS1, U1-U5,
    R1-R13, D1) so removing a part no longer renumbers the rest.
    - Scripts resolve paths from th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
2026-10-03 feat(pcb): rev 2.4 - GMT024 2.4" panels, per-display backlight
    - Display sockets 1x7 -> 1x8 for the GMT024-08-SPI8P (pad 1..8 = GND
    VCC SCL SDA RST DC CS BL); silkscreen adds BLn labels.
    - Per-display backlight: BL1=GPIO7, BL2=GPIO6, BL3=GPIO5 -> pad 8,
    Freerouted on B.Cu (on/off or LEDC PWM per panel).
    - Display pitch 43 -> 51.9mm (46.9mm panel + 5mm gap); board grows
    to 56.2 x 138.2mm. Display 1 centre moves to Y=23.45.
    - Title block rev 2.4; README/Scripts.md updated.
    DRC 0/0, SPI topology check passes, no 90-degree corners.
2026-10-03 feat(pcb): rev 2.4b - 2-layer cost-down, F.Cu routing over B.Cu GND pour
    - Scripts/board_config.py: COPPER_LAYERS (2 = rev 2.4b, 4 = rev 2.4),
    revision/date/title and Power net class values shared by the chain
    - all routing on F.Cu; B.Cu is one unbroken GND pour carrying only 5
    short jumpers (3.8-8.0 mm, 27 mm total, 6 vias); pour 81.3% of raw
    board area, 99.3% of the no-jumper ideal; display bus still F.Cu, 0 vias
    - 5V routed as a Power-class track (J1 -> west of J1 -> trunk under the
    display sockets, boost tee + one jumper); Power class in .kicad_pro
    - optos turned 180deg and reordered U5,U1-U4 so outputs face the
    keyfob/RST sockets; R2/R3 swapped for planar anode lanes
    - status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
2026-10-03 feat(pcb): rev 3.0 - 45.7mm wide, RST/keyfob sockets below the module
    - west strip removed: board 56.2 -> 45.7 x 138.2 mm; main body extends
    past the antenna end to Y=88 (inside the bounding box the strip
    already sets) holding J6 (RST pair, west edge), J7 (keyfob, turned
    90deg to face the bottom edge), D1 + R6 and a bottom-left hole;
    mounting holes now top-right, bottom-left + the two in the strip
    - antenna keepout extended to Y=67.5 (DevKit ends at 66.3), all layers
    - opto drive GPIOs remapped to J2's pin order: B1-B4 = GPIO39/40/41/42,
    motherboard RST = GPIO1 (was GPIO1/42/41/40 + GPIO39); opto slots back
    to U1-U5, resistor bank re-arranged for planar drive/pull-down/anode
    - ro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
2026-10-03 feat: rev 3 firmware pins + board measurements on renders
    - firmware: all 5 sketches use display 1's rev 3 pins (CS 8, DC 9,
    RST 10, MOSI 11, SCK 12, BL 13); boardPinsInit() keeps displays 2/3
    deselected (CS2/CS3 HIGH) and dark (BL2/BL3 LOW), BL1 on; old bench
    wiring (GPIO3-7) noted in each sketch. All compile for esp32s3 (GIF
    players need the 16MB / 3MB-app partition for their embedded frames)
    - render_board: overall size caption plus dimension lines for main
    body width/length, strip width and strip length below the main body,
    each in mm / cm / in; caption box on the 3D overview
    - README / Scripts.md updated
2026-10-03 feat(pcb): rev 3.1 - BL1 on GPIO3, no B.Cu jumper under SCK/MOSI
    - BL1 moves from GPIO13 (J1 pin 19, inside the SCK/MOSI riser loop) to
    GPIO3 (pin 13, below the bus); its one B.Cu jumper now crosses only
    DC + CS1, so the GND pour under both fast lines is unbroken
    - Firmware: TFT_BL = 3 in every sketch
    - "USB-C END" marker moved off the 12V bus
    - render_board.py draws silkscreen on top of copper, as fabbed
    - DRC 0/0, netlist parity OK, bus still F.Cu-only daisy chain
2026-10-03 docs(pcb): confirm GMT024 header pinout and hang-down panel orientation
    - Header centred on the 46.9mm edge and pin order GND VCC SCL SDA RST DC
    CS BL = socket pads 1-8, checked against the GMT024-08-SPI8P drawing
    - Panels hang down below the board, screen out, header edge up; flipped
    reverses all 8 pins (5V onto CS)
    - Backlight transistor is Q2 (Q1 + C1-C3 = onboard LDO)
2026-10-05 feat(firmware): GIF stream test - raw RGB565 DMA push + backlight sweep
    New-panel bring-up sketch (s3_gif_stream_test) plus PC streamer
    (Scripts/gif_stream.py). The original GIF goes over the USB-UART once as
    raw big-endian RGB565 (checksummed), lands in PSRAM, is saved to the FAT
    partition and loops on every boot without the PC.
    - Pixels pushed via esp_lcd SPI + DMA (ping-pong internal buffers), no
    GFX layer: 14.9 ms/frame at 80 MHz vs 33 ms with Adafruit_GFX, so the
    GIF plays at its native 29.7 fps instead of stuttering at 27.
    - Absolute-deadline frame pacing; margins left black, no test bars.
    - BL PWM sweep test: 100% -> 0% over 2 s, back over 1 s, repeating.
    - Bench pins BL 4, CS 5,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
2026-10-05 chore(pcb): rename title to "ESP32 PC Control System"
    Title block (board_config.py TITLE + kicad_pcb) and main.ato header.
2026-10-05 docs: root README with rev 3.1 silkscreen render
    Project overview, rev 3.1 pin map, assembly notes, repo layout, firmware
    sketches and build pointers. The silkscreen render is copied to
    docs/images/ since pcb/build/ is gitignored.
    Also notes the module's IN-OUT jumper (pcb/README + root README): 5VIN is
    input-only by default on these N16R8 boards, and it is the carrier's only
    5V source, so it must be bridged.
2026-10-11 chore: Gerber export script + mark GIF frame headers as generated
    - Scripts/export_gerbers.py: fab package (Gerbers, PTH/NPTH drills with
    X2 maps, .gbrjob) to K:\artifacts\<TITLE>_rev<REVISION>_gerbers + zip,
    files renamed default-* -> ESP32_PC_Control_System-*, gbrjob list and
    X2 project id rewritten to match; plots the DRC-checked stored zone fill.
    - .gitattributes: firmware/**/gif_frames_rle.h linguist-generated, so the
    7 MB frame tables stay out of GitHub diffs and language stats.
2026-10-22 chore: remove superseded CAD, bench sketches and stale docs
    The OpenSCAD enclosures and their fit research were drawn for the old
    SuperMini + GMT020 bench parts. The six s3_* sketches (and their two 7 MB
    generated frame headers) were bring-up experiments whose results now live
    in carrier_main. gif-display.md documented that bench rig.
    Claude-Session: https://claude.ai/code/session_01M8wSDWJoREeXFcZwMUvEZf
2026-10-22 refactor(firmware): split carrier_main into modules
    config.h holds the pin map and build switches; display, views, optos,
    pc_state, gif_store, commands and console each own their state behind a
    small header, replacing one 750-line sketch with file-level globals.
    Commands are now a table, separate from the serial transport.
    Behaviour is unchanged, apart from:
    - MOBO_RST_HOLD_TEST=1 now fails the build unless
    BENCH_NO_MOTHERBOARD=1 is also set;
    - the stats view shows SPI_HZ rather than a hard-coded 40 MHz.
    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
2026-10-22 refactor(scripts): rename to scripts/, drop 4-layer paths, add pin check
    - Remove the COPPER_LAYERS=4 branches: rev 3 is 2-layer only and its hand
    routes assume it.
    - Tool and work paths (KiCad, Freerouting, scratch, artifacts) move to
    board_config.py with environment overrides, instead of hard-coded
    Windows drive letters in each script.
    - check_pins.py checks firmware/carrier_main/config.h against
    pcb/main.ato (it would have caught the stale BL1=GPIO13 note).
    - gif_stream.py now targets carrier_main.
    - main.ato: header rewritten for rev 3.1, revision-history comments
    dropped. Netlist unchanged.
    Claude-Session: https://claude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
2026-10-22 docs: rewrite READMEs for the current board, add CI
    Root, pcb/ and scripts/ READMEs describe rev 3.1 as it is, without
    revision history (that is in git). Adds a power-control section (WoL,
    USB, RST, AC-loss restore) and the PC settings it needs. CI builds
    carrier_main, runs the pin check and lints the scripts.
    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
2026-10-22 fix(firmware): clear the two compiler warnings CI reported
    - PSRAM free size is uint32_t (long) on the ESP32 core; cast for %u.
    - ++ on a volatile is deprecated in C++20.
    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
2026-10-23 feat: networking, Discord bot, two-core display pipeline, PC stats bridge
    Firmware (carrier_main):
    - Wi-Fi + mDNS + OTA, optional Home Assistant MQTT, Discord bot with an
    owner-only /actions ephemeral control panel and channel notifications.
    All off until secrets.h is filled in (secrets.example.h is the template).
    - Display pipeline: flush task on core 0, GIF pre-packed as RGB444 with
    per-frame dirty rects, no 10 fps cap. One GIF runs at its native 29.7 fps
    with the bus at 47%; three GIFs at 20 fps each with the bus at 95%.
    - Status LED on PWM with perceptual brightness, capped at 35% duty.
    - perf command (per-core CPU, wire load), pcstats store + command.
    - Vendor HID interface next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
2026-10-24 feat(host): Antigravity quota helper (per-user), active account keys
    esp32-agyquota.exe polls the local Antigravity language server once a
    minute and writes agy.* keys (active account, per-account plan, Flash/Pro
    remaining %, reset) that the service forwards with @source file:///.
    Model families come from label regexes, so renames need no change.
    Assisted by Claude Code
2026-10-24 chore(firmware): ESP-IDF 5.5 project skeleton (carrier_idf)
    CMake project, sdkconfig.defaults matching the Arduino build (N16R8,
    same partition table and FAT sector size), LovyanGFX 1.2.34 as a
    submodule with a quoted-path wrapper component, platform helpers in
    sys.h. Sources copied unchanged from carrier_main, still to be ported.
    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
2026-10-24 feat(firmware/idf): drop Home Assistant; audit fixes
    - remove ha.cpp/h, MQTT secrets/deps, logSetHook (Discord replaces HA)
    - usb: hand the pads back to USB-Serial-JTAG before the ROM download
    reboot (as Arduino does), serialise CDC writes from several tasks
    - display: apply MADCTL and RAM offsets from display_config.h
    - discord: 12 KB websocket task stack (handlers make TLS REST calls)
    - -Werror fixes (strncpy truncation, missing initializers)
    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
2026-10-24 feat(host): keep the Claude Code token fresh from the per-user helper
    When the OAuth access token has <10 min left, esp32-agyquota runs
    `claude auth status`, which makes the CLI refresh and rotate its own
    token. Only expiry times are read; tokens are never read, logged or
    written by us. Warns in the log when the refresh token nears expiry.
    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
2026-10-24 feat: exact integer stats up to 12 digits; hands-off IDF flash script
    Host sends whole numbers exactly (uptime, token counts) instead of G7;
    the firmware stores stats as double and prints integers in full.
    scripts/idf_flash.py: stop service, 1200-baud touch, flash, restart.
    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
2026-10-24 fix: print whole-number stats exactly up to 2^53 (token counters)
    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
2026-10-24 feat(host): power requests over HID, WoL target MAC
    Reads HID input reports; executes only !power sleep|hibernate|restart|
    shutdown with a nonce and acks via power.ack. Publishes pc.mac/pc.mac_if.
    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
2026-10-24 feat(firmware): Wake-on-LAN, USB remote wakeup, power control
    wake: WoL magic packet (MAC learned from the PC's pc.mac, kept in NVS)
    plus USB remote wakeup when suspended. power <sleep|hibernate|restart|
    shutdown>: request over HID input reports, acked by the service; HID
    System Control keys as fallback for sleep/shutdown. Discord buttons
    with confirmation.
    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
2026-10-24 fix(firmware): bus-budget admission, default layout keys, CDC connected follows DTR
    - a frame larger than the bucket (full GIF push at budget<23%) starved forever
    - default dash: uptime in hours, ai.phase_name / ai.guard_name text keys
    - CDC: RTS-then-DTR opens parked the reset state machine, dropping every
    other serial session's output
    - Scripts.md: layout_upload.py
    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
2026-10-24 feat(host): announce restart/update/shutdown/sleep to the board
    Watches System event 1074 live, classifies update restarts (Windows
    Update processes, OS upgrade/servicing reason codes, pending reboot),
    falls back to OnShutdown/OnPowerEvent, and reports how the PC last went
    down. --going prints the classification of past events.
    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
2026-10-25 feat(host): media session + cover art, E-core load, CPU power, LLM RAM, PC clock
    The per-user helper reads Windows media sessions (Spotify, browsers, ...)
    into media.txt and a 144x144 RGB565 cover; the service streams it as
    @a lines, resends on !art, and adds @ecore_load / @proc_mb rules plus
    pc.epoch / pc.tz_min for the board clock.
    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
2026-10-25 feat(firmware): three desk screens (pc / media / ai views)
    Faces follow the PC state: stats or GIF (+ restart/update box in an
    overlay band the GIF skips), media with cover art or weather, AI usage /
    local AI or a stacked clock. Adds 56/128 px digit and Nerd Font icon
    fonts, the @a cover-art receiver, a board clock from pc.epoch, and a
    weather stub with 'weather demo [rain]'.
    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
2026-10-25 feat(pc_stats): render non-ASCII text on the PC for the board (!txt / @x)
    UTF-8 on the HID link, texts up to 120 bytes, GDI rendering with Comic
    Shanns + Windows font fallback into 4-bit alpha, --render-text test mode.
    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
2026-10-25 fix(media): helper never polled media in its background loop
    The media thread only started in --once mode, so the board showed whatever
    the last manual run saw. Now: media polled every 250 ms, cover re-read for 8 s
    after a track change (Windows swaps the thumbnail late), 12 KB of art per tick
    (board HID buffer 24 KB), and a 'face <n> <name>' command to pin faces for
    screenshots (shot also captures GIF faces).
    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
2026-10-25 fix: clock face stack overflow, reset countdowns, overlay text fit
    - main task stack 8 KB -> 16 KB: drawing the 128 px clock digits overflowed it and rebooted the board
    - AI cards: "Resets in hh:mm:ss | hh:mm" (session) and "dd:hh:mm:ss | Oct 28" (weekly), counted down on the board from Unix reset times the PC now sends (claude.*_reset_ts, agy*.flash_*_reset_ts)
    - updating overlay subtitle fits its box; Local AI chip says Not Active instead of asleep
    - idf_flash.py --idf <action> runs any idf.py action on the ROM port (e.g. coredump-info)
    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
2026-10-25 feat(pc_stats): Antigravity weekly Gemini quota from agy /usage
    Google's quota endpoints reachable with agy's login only report the
    Claude/GPT group and one Flash value; agy's /usage panel shows both Gemini
    windows. The helper now runs agy in a pseudo console every 10 minutes,
    types /usage, parses the Gemini group, and removes the /usage and /exit
    lines it added to agy's prompt history (only lines from its own workspace
    folder, %LOCALAPPDATA%\ESP32PcStats\agy-usage).
    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
2026-10-25 feat(screens): two-line clock date, compact net rates; README capture script
    - clock: "Sunday" / "October 25th 2026", both centred
    - net rates drop the decimal from 100 up so a 2-digit-day uptime fits
    - scripts/readme_shots.py: stops the stats service, feeds a made-up frame,
    captures every face with `shot` and tiles them; panel_shot.shot_on()
    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
2026-10-25 docs: README for the ESP-IDF firmware, screens image, eFuse note
    - PCB image shrunk to 200 px on the left with the intro beside it
    - screens image captured from the board (made-up stats) and the face table
    - keyfob presses during flashing: ROM download mode drove GPIO38-40; fixed
    by burning DIS_USB_OTG_DOWNLOAD_MODE
    - firmware section rewritten for carrier_idf (modules, pipeline, commands,
    flashing, screenshots); PC side; findings and status updated
    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
2026-10-25 docs: README intro as a two-column table so the text stays beside the PCB image
    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
2026-10-25 perf(display): DMA wait blocks on a task notification instead of spinning
    The esp_lcd transfer-done ISR notifies the flush task; waitTx sleeps in ulTaskNotifyTake (20 ms timeout as a lost-interrupt guard), so core 0 is free while the panels take data.
    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
2026-10-25 feat(led): new status LED patterns
    - board booting: 100 ms pulses (until setup is done, plus up to 5 s waiting for the USB host)
    - PC on: solid
    - PC restarting / updating: 200 ms pulses
    - PC asleep / off: smooth 3 s breathing instead of a hard blink
    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
2026-10-25 feat(commands): pcsim <on|off|auto> test hook for the PC power state
    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
2026-10-25 feat(gif): fill the screen height, overlay box on top, full frame rate
    - frames are scaled once at load (same factor both ways, bilinear) to the
    screen height and centre-cropped: 240x291 -> 240x320
    - the restart/update box is mixed over the GIF (canvas key colour shows the
    GIF through) instead of blanking a full-width band
    - GIF faces were held by the default 20 fps panel cap and slowed to 2/3
    speed (stretch 1.55); they now follow their own frame times (29.8 fps)
    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
2026-10-25 feat(led,screens): LED shows loading until PC stats arrive; drop the Claude pace marker
    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
2026-10-25 docs: recapture screens (full-height GIF, overlay box, no pace marker); LED table and pcsim in README
    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
2026-10-25 feat(enclosure): 3D-printed block, lid and screen mask
    CadQuery model of the carrier enclosure: a plinth block with pin-tail
    wells and M2.5 pilots, a closed lid with end-to-end airflow and an LED
    window, and a black screen mask that closes the space behind the panels.
    Lid pegs into the block and the mask pegs into the lid (round peg and
    socket, 0.15 mm clearance). Print-ready STL/STEP in out/print need no
    supports. Includes the fit report, three.js viewer and renders; the
    earlier multi-part case is kept in archive/.
    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
2026-10-25 fix(pc_going): keep restart/update until the PC's stats are back
    An update restart came back on USB while Windows was still on "Updates are
    underway" (before any service runs), so the latch cleared and the panels
    showed empty PC faces. Now a restart / update restart stays latched until a
    fresh stats sample arrives after the PC was off, through any extra restarts.
    Windows: 60 min allowed before an update restart goes off, 2 h to come back
    (10 min for a plain restart). An update shutdown ends once the PC is off.
    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
2026-10-25 feat(going): service reports Windows installing updates (pc.update)
    The service sends pc.update=1 while a servicing worker (TiWorker, poqexec,
    SetupHost) runs with nobody signed in -- the "Working on updates" and
    "Updates are underway" screens, during which the service is already up
    after the first restart. The board latches an update restart on it (even
    without an announcement), never times out or clears it while it is 1, and
    clears once it is 0 and fresh stats arrive. `--going` prints both checks.
    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
2026-10-25 fix(weather): TLS buffers in PSRAM, UTF-8 place name kept as a PC-rendered image
    - WEATHER_HOME parser: name after the 2nd comma, trimmed, quotes stripped
    - mbedtls allocs in PSRAM (ssl_setup failed with ALLOC_FAILED)
    - forecast retried after 1 min on failure; weather show prints last error
    - textimg pinned keys: request carries the text, image saved to /ffat
    - agy quota: logins without id_token resolve the account (userinfo, else the live client)
    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
2026-10-25 feat(discord): four channels: pc, weather, logging, standing control panel
    - DISCORD_CH_PC/WEATHER/LOG/CONTROL in secrets.h, each optional
    - #weather: rain alerts (home and phone), morning forecast once a day
    - #logging: board log lines batched into code blocks every 10 s
    - #control: one /actions-style panel message, edited in place, refreshed
    every 10 min and on PC state changes
    - REST responses captured in PSRAM; notify queue in PSRAM
    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
2026-10-25 fix(discord): answer button presses at once, then edit the panel
    Buttons are acked with a deferred update (type 6) and the panel is edited
    through the interaction webhook afterwards, so slow actions or a busy
    connection no longer hit Discord's 3 s deadline. Button presses get their
    own HTTPS connection instead of queueing behind log posts.
    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
2026-10-25 fix(discord): room for interaction tokens in REST URLs
    Interaction tokens run past 200 characters, so the 256-byte URL and path
    buffers cut off /callback and /messages/@original and Discord answered 404.
    Logs no longer carry the tokens and report click-to-answer latency.
    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
2026-10-25 fix(net): sockets for WoL, Discord header buffers, RSSI off the Wi-Fi driver path
    - LWIP_MAX_SOCKETS 24, HTTP server limited to 3 open sockets (WoL hit
    'socket failed' once Discord had a second HTTPS client)
    - Discord REST header buffers sized for interaction-token URLs
    - RSSI read on the main loop every 5 s and cached
    - WOL_MAC (fallback until the PC reports its MAC) and WOL_TARGET in secrets.h
    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
2026-10-25 style(enclosure): show block, lid and mask in black
    Viewer colours and renders now match the black print; README prints all three parts in black. Geometry unchanged.
    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
2026-10-25 fix: internal RAM for sockets/TLS; Local AI speed and step labels
    - Wi-Fi IRAM opts off, 8 static RX buffers, BA window 8: internal heap
    free 8.8 KB -> 38 KB (socket creation was failing, Discord and WoL with it)
    - socks console command: open sockets and internal RAM
    - Local AI: tok/s dimmed as 'last' unless generating, '--' while the
    prompt is read; 'no agent job' instead of Step 0 / 0
    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
2026-10-25 fix(boot): start Wi-Fi after the GIF loads; small TLS allocs internal; log reset reason
    Core dump of the crash on wake-from-shutdown: interrupt watchdog on CPU0 in
    the Wi-Fi task (WPA3 SAE bignum alloc from PSRAM) while app_main read the
    140 KB GIF from flash. Wi-Fi now starts after the GIF load, mbedtls uses
    plain malloc (small allocations internal, record buffers PSRAM), and the
    board logs why it last restarted (posted to Discord unless a normal one).
    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
2026-10-25 fix(discord): REST response copy used sizeof on a pointer
    When a Discord response passed the 8 KB buffer, the clamp computed
    sizeof(char *) - 1 - len, a negative length, and memcpy ran across PSRAM,
    corrupting the heap (crash found later in cJSON_Delete in the weather task).
    Truncated responses are now logged.
    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
2026-10-25 test(power): backlights off for 500 ms around the wake (brownout at PC power-on)
    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
2026-10-25 feat(power): WAKE_DIM_BACKLIGHTS toggle for the PC power-on brownout quirk
    Backlights off for 500 ms around a wake, configurable in secrets.h
    (example: false). Fixed the brownout restart on the author's motherboard.
    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
2026-10-25 docs: power-on brownout: treated as fixed, battery + boost option for the power button case
    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
2026-10-25 feat(discord): Hibernate button with confirm step
    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
2026-10-25 feat(bench): board benchmark (console bench, GET /bench) and first results
    CPU, SRAM, PSRAM, flash (raw, mapped, FAT), display SPI full frames, USB CDC,
    Wi-Fi download. Results in docs/benchmark.md.
    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
2026-10-26 fix(usb): drop a log line that would re-take the CDC TX lock
    TinyUSB logs "Flush failed" from inside usbCdcWriteAll; the log went back
    into usbCdcWrite, which took the same non-recursive mutex from the same task
    and tripped a FreeRTOS assert (board restart during bench usb).
    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
2026-10-26 feat(power): WAKE_DIM_MS setting; brownout marked not reproducible
    Backlight-off time around a wake is now WAKE_DIM_MS (default 100 ms).
    The PC power-on brownout no longer happens with the setting on or off;
    the README says so and keeps the settings as a safety measure.
    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
2026-10-26 feat(weather): tiered rain warnings, live countdowns, GDACS typhoon tracking
    - Rain ETA counts from the clock (slot timestamps) instead of the 15-min
    slot, so it no longer sits still and jumps; rain end estimated from the
    nowcast, past 105 min from the hourly forecast.
    - Tiers: Light Rain, Heavy Shower (7.6+ mm/h), Storm (thunder or 62+ km/h
    gusts), Typhoon, Super Typhoon (peak wind 184+ km/h).
    - Discord: post on every 5-min ETA change, raining post with the end time,
    "Weather Warning Cleared" in green; yellow over 20 min, red under.
    - Typhoons from GDACS: list every 30 min, a nearby storm's track per advisory
    (text-scanned, 1 MB PSRAM buffer); one post per advisory, every minute i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
2026-10-26 fix(host): agy token refresh falls back to every OAuth client pair
    The helper cached the first {client id, secret} pair that renewed agy's
    token and retried only that one. After the quota failover switched the
    stored login to the other Google account, that login needed another pair,
    so every refresh failed ("no usable token") and the Antigravity quota went
    stale until agy itself renewed the token. Now the cached pair goes first,
    then the rest (agy.exe is still scanned once per run), and the failure
    reason is logged once.
    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
2026-10-26 feat(discord): panel tabs (Door, PC Control, Board, Display) and Lock
    - Tab row on the #control and /actions panels; each tab has its own
    embed fields and buttons.
    - PC Control: Lock (new `power lock`; the PC service starts LockWorkStation
    in the signed-in session, the board has no keyboard for Win+L).
    - Board: Restart board (asks first; new `reboot` command, `reset` stays the
    PC's reset line), Refresh weather (`weather refresh`), Reconnect Discord;
    RAM, PSRAM and the last restart reason in the embed.
    - Display: a screen picker per panel (the `face` override, not saved),
    Dimmer / Brighter in 20 % steps, Displays off / on (`display <on|off>`,
    not saved), All auto.
    - Weather reques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
2026-10-26 perf(mem): 30 KB of internal SRAM back (stats and GIF tables in PSRAM, stacks)
    - pcstats tables (14 KB) and the GIF per-frame tables (6 KB) move to PSRAM;
    GIF playback unchanged (29.7 -> 29.6 fps, SPI 55 %).
    - Stacks to measured high-water use + margin: main 16 -> 10 KB, httpd
    8 -> 6 KB, esp_timer 3.5 -> 2.5 KB, mdns 4 -> 3.5 KB (weather and Discord
    in the previous commit).
    - Internal heap free 20 -> 50 KB, largest block 5 -> 22 KB, lowest free
    since boot 0 -> 17 KB; the boot-time "wifi: mem fail" is gone.
    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
2026-10-26 feat(discord): dropdown panel + secret PC screenshot to a webhook
    Panel: the four categories (Door, PC Control, Board, Display) are now a
    dropdown instead of a button row. Display gains a per-panel screen dropdown
    (each with an Auto option) and one brightness dropdown for all panels (5 %
    steps + Off, saved); its five rows are all selects, so Refresh there is an
    entry in the category dropdown.
    Screenshot (PC Control button / `screenshot` command): the board sends
    `!shot <nonce> <webhook>` over HID with DISCORD_SHOT_WEBHOOK from secrets.h.
    The SYSTEM service cannot see the desktop, so it hands the request to the
    user-session helper, which captures the whole virtual desktop (all monitors),
    pos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
2026-10-26 refactor(firmware): drop the Arduino carrier_main, move carrier_idf up to firmware/
    The ESP-IDF project is now firmware/ directly (was firmware/carrier_idf/);
    the old Arduino sketch firmware/carrier_main/ is removed. Updates the
    LovyanGFX submodule path, every script and doc path (idf_flash, layout/ota
    upload, check_pins now reads firmware/main/config.h), the README repo layout
    and build command, and drops the dead Arduino build job from CI (the IDF
    firmware is not built in CI yet). Verified: check_pins and pyflakes pass and
    the firmware builds from firmware/.
    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
2026-10-26 refactor(host): merge the service and its user helper into ESP32-Helper.exe
    One exe instead of esp32-pcstats.exe + esp32-agyquota.exe. The SYSTEM
    service now starts its own user-session half (--user) in the console
    session with the signed-in user's token, restarts it if it dies, and moves
    it on a user switch. The scheduled task is gone.
    The halves talk over two anonymous pipes instead of files in ProgramData:
    feeds (agy, media), cover art and log lines up, screenshot requests down.
    @source gains a helper:<feed> scheme; old file:/// lines in an installed
    stats.ini are read as the matching feed. The user half exits when the pipe
    breaks, so it never outlives the service.
    install.ps1 points th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
2026-10-26 refactor(host): port ESP32-Helper to .NET 10, self-contained single file
    ESP32-Helper.csproj replaces the csc.exe build; build.cmd runs dotnet
    publish and leaves one ~58 MB exe with the runtime inside. nuget.config
    points at nuget.org because this machine has no global package source.
    - Sensors: LibreHardwareMonitorLib 0.9.6 (PawnIO driver) replaces the OpenRGB
    lhwm-wrapper.dll; UpdateVisitor now lives in PcStats.cs. Upstream has no
    Intel iGPU "GPU Core" load, so igpu_load reads the busiest D3D engine.
    - JSON: Net.cs parses with System.Text.Json into the shapes
    JavaScriptSerializer returned, so the code walking results is unchanged.
    - HTTP: one HttpClient in Net.cs; failures throw Htt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
2026-10-26 fix(firmware): keep Wi-Fi and lwIP in internal RAM
    The board panicked with a CacheError in the lwIP thread: sys_timeout_abs
    walked the timer list into t->next = 0x3d6dda68, a PSRAM pointer
    (0x3c6dda68) with one bit flipped. With SPIRAM_TRY_ALLOCATE_WIFI_LWIP those
    lists lived in PSRAM; earlier crashes (CacheError in the PSRAM heap, bad
    free() in tiT) hit the same kind of structures. Pointer-heavy network state
    goes back to internal RAM; bulk data stays in PSRAM.
    Soak (3 load rounds + 10 min idle): PASS. Internal free 49.5 -> ~40 KB
    (low 39,991), largest block 14.3 -> 8.7 KB, Wi-Fi 0.6-0.88 MB/s, 0% ping
    loss.
    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
2026-10-26 feat(rgb): PC Case RGB LEDs tab driving PcHwCtl
    The board sends `!hw <id> <command>` over USB HID; ESP32-Helper forwards it
    to PcHwCtl's named pipe (only `ping` and `rgb ...` pass) and answers with the
    text stat hw.reply. PcHwCtl's state.txt comes in as `@source hw`.
    Firmware: hwctl module, `hw` console command, and a Discord tab with mode,
    color and brightness pickers plus All/Motherboard/RAM target buttons. The
    panel waits for the new state to reach the board before redrawing.
    install.ps1 keeps the service on Automatic (not delayed) on reinstall.
    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
2026-10-26 feat: Discord fan control and Local Agent Control tabs
    PC Case Fan Control: the !hw relay now also passes PcHwCtl's fan
    set/curve/release. The tab picks a target, a speed held 5/15/60 min, a curve,
    or Auto (release); the embed shows each fan's %, rpm, temperature and held
    overrides.
    Local Agent Control: new `!ai <id> <command>` relay to the LocalAIHost
    service pipe (reply in aictl.reply, requests queued, status squeezed into
    key=value words). Firmware aictl module, `ai` console command, and a tab to
    load/unload/reload the model, set context, auto-unload and keep-awake,
    restart the stack's services and run the guard check (risky ones confirm).
    ESP32-Helper --agy-usage prints agy's /usage pa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
2026-10-26 perf(firmware): internal SRAM 40 -> 73 KB free, Discord interaction queue
    Internal RAM fell to ~3 KB at boot and idled near 40 KB with an 8.7 KB
    largest block. Now 73 KB free, 31.7 KB largest, 34 KB lowest ever, with the
    same Wi-Fi and USB speed (docs/benchmark.md):
    - Wi-Fi static TX buffers 16 -> 8 (static is the PSRAM default, ~1.6 KB each
    of internal RAM for good)
    - mbedTLS dynamic buffers, config and CA chain freed after the handshake,
    peer certificate not kept
    - Discord interactions go through a queue to the bot task: acknowledged at
    once, handled there with its one REST TLS client (the second one is gone),
    websocket stack 12 -> 8 KB, and a slow PC command no longer holds the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
2026-10-26 perf(firmware): USB buffers in PSRAM, faster face draws, watchdog back
    - USB HID/CDC receive stream buffers keep their 28 KB of bytes in PSRAM
    (control blocks stay internal). Internal free 133 -> 163 KB, largest
    block 58 -> 88 KB, lowest ever 93 -> 120 KB (A/B, Wi-Fi down).
    - Data cache lines 32 -> 64 bytes: faces draw into PSRAM canvases and got
    15-25% faster (AI 29.7 -> 25.1 ms, media 19.3 -> 14.8 ms); PSRAM write
    35 -> 48 MB/s, full SPI frame 29.7 -> 28 ms; random PSRAM read 503 -> 697 ns.
    - viewsService draws one canvas per pass: three faces due at once used to
    hold the main loop for 74 ms, now one face (27 ms at most). GIF frames
    still go in the same pass.
    - Restore the watc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
2026-10-26 feat(firmware): PC usage warnings on the Media and PC faces
    2 s averages of the PC's samples: RAM over 80 % (yellow) / 90 % (red), CPU,
    GPU1, GPU2 load and RX 6600 VRAM over 90 % (yellow), CPU and RX 6600 over
    80 C, RTX 3050, hottest DIMM and VRM over 75 C (red). The Media face shows
    every active one in one box in place of the weather warning: one line for a
    single warning, else a count over a load line and a heat line, red when
    any is red. The PC face tints the CPU, RAM, RX 6600 and RTX 3050 cards and
    their temperatures with the worst level of their own metrics.
    Thresholds and the window are configurable and saved in NVS:
    `pcwarn set <metric> <high|crit> <value|off|default>`, `pcwarn avg <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
2026-10-26 fix(firmware): keep text stats up to 120 bytes
    The @t parser copied values into an 80-byte buffer while the slot and the
    PC both allow 120. A longer title (Vietnamese, with 2-3 bytes per accented
    letter) was cut, its CRC no longer matched the PC's, the PC refused the
    bitmap request and the board drew '?' for every non-ASCII letter. The cut
    came in with the ESP-IDF port.
    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
2026-10-26 feat: PC usage warnings in the README screens
    - readme_shots.py: a "PC usage warnings" row (PC face with warnings, one
    warning, all ten at once), fed as real stats so the board's 2s averages
    trip them. It also sends its own cover art and title bitmap (same GDI
    rendering as the service, paced for the 4 KB CDC buffer), so the sheet
    no longer shows the PC's current track or '?' for the Japanese title.
    - panel_shot.py: retry a capture that lost a data line.
    - Warning box subtitle reads "2s average".
    - README: PC usage warnings feature and pcwarn module.
    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
2026-10-26 feat(usb): WinUSB bulk pipe for the PC service, receive backpressure
    - Board: a vendor interface with two bulk endpoints (interface 3, EP 4).
    MS OS 2.0 descriptors (bcdUSB 2.1, BOS) make Windows bind WinUSB with no
    driver install. Board-to-PC lines go out on it while the service sends
    there, else on HID (usbHidSendLine is now usbPcSendLine).
    - Service: WinUsbLink, tried before HID and serial (--transport winusb).
    Lines read in the first 500 ms after opening are dropped, so an old
    request left in the board's buffer never runs.
    - CDC and vendor receive no longer drop bytes when the stream buffer is
    full: they stay in TinyUSB's FIFO and the PC waits (NAK). An unpaced
    43 KB send to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
2026-10-26 feat: PC Monitor Control, dGPU fans, wifi scan, SYS_FAN2
    - PC Monitor Control (Discord tab, console `mon`): brightness in 10 %
    steps and screen on/off for each monitor or all of them, over DDC/CI.
    The service's user-session half does the DDC work (Monitors.cs, dxva2):
    the monitors are numbered from the left and reported as mon.* every 5 s.
    The board's `!mon` goes over the user-half pipe (M/R lines), and the
    answer comes back as monctl.reply.
    - PC Fan Control (was PC Case Fan Control): RX 6600 and RTX 3050 targets
    with a Zero RPM menu in place of the curve, a "Case fans" target, and
    the GPUs in the readout. The service passes `fan zerorpm` to PcHwCtl.
    - Wi-Fi: console `wifi scan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
2026-10-26 feat: night mode, Windows display off, ESP32 board/display tabs
    - Night mode (PC Control: "Night auto" + "Start/End night now", console
    `night`): 22:00-06:00 after 15 min without PC input, dims PC RGB and the
    board panels to 10 %, shows the PC-off screens, caps the status LED at
    20 %, turns the PC displays off; input restores everything, 06:00 restores
    the board side and owes the LEDs until PcHwCtl answers. Posts to
    #pc-announcement.
    - Helper user half sends pc.idle_s (GetLastInputInfo) as the "idle" feed.
    - Monitor power uses Windows' display off instead of DDC standby (a
    DisplayPort monitor in standby dropped out of Windows); brightness sets are
    reported as set for 15 s, the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
2026-10-27 feat: night mode guards and Process Lasso E-cores, power card, wake dim always on
    - Night mode wake guard: input only ends the night if the next 10 s show a
    real return (> 50 px of mouse travel or 3 key/button presses, new
    pc.in_px / pc.in_press counters from the user half); otherwise the displays
    go off again.
    - Video guard: no automatic start while a process holds a display-required
    power request (powercfg /requests in the service, pc.disp_req[_by]).
    - Process Lasso: while engaged the service swaps prolasso.ini for a copy that
    pins non-critical background processes to E-cores 12-17 and pins the
    running ones; the original goes back on disengage (or after 5 min without
    the boar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
2026-10-27 perf(owntracks): leaner MQTT client, exact topic
    - keepalive 120 s, task stack 5120 B (was 6144), rx buffer 512 B, tx 256 B
    - messages larger than the buffer are joined across MQTT_EVENT_DATA pieces
    - hint in the log when OWNTRACKS_TOPIC is a wildcard
    - MQTT WebSocket transports off (TLS over TCP only)
    - docs: exact topic, Retain on, client footprint
    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
2026-10-27 fix(build): sdkconfig.defaults reproduces the board's Wi-Fi TX and lwIP settings
    Static Wi-Fi TX buffers and OOSEQ_MAX_PBUFS=0 were defaults only while
    SPIRAM_TRY_ALLOCATE_WIFI_LWIP was on. A fresh build from sdkconfig.defaults
    got 32 dynamic TX buffers and OOSEQ 4, unlike the board.
    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
2026-10-27 build: MINIMAL_BUILD, only the ESP-IDF components main needs
    espcoredump is named in main's PRIV_REQUIRES because esp_system only
    optionally requires it. Same sdkconfig: flash -1 KB (mDNS loses the
    Ethernet netif; the board has none), D/IRAM -8 B; dropped components'
    Kconfig keys vanish.
    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
2026-10-27 build(lovyangfx): require the drivers it uses, drop the touch sources
    No touch panel; the touch objects were never linked.
    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
2026-10-27 feat(monitors): DDC/CI power for the two DELL E1715S next to Windows' display off
    - off: DPM off (VCP 0xD6 = 4) on the models in DdcPowerModels, then Windows'
    display off for every monitor; on: Windows wakes them, then DDC power on
    - power <n> limits DDC to monitor n; DDC failures are appended to the ok reply
    - the mon feed reports a power set for 15 s, like brightness
    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
2026-10-27 fix(tls): mbedTLS dynamic buffers off; they corrupted the heap
    With CONFIG_MBEDTLS_DYNAMIC_BUFFER on, closing the GDACS cyclone download
    (200-350 KB over TLS) freed an mbedTLS buffer block whose tail had been
    overwritten by 2 bytes. That tripped the multi_heap_free assert in the weather
    task, and the board crash-looped about 50 s after every boot. With it off, the
    board stays up through the same fetches and the lowest-ever internal free goes
    from 22 KB to 34 KB. docs/benchmark.md has the before/after numbers for the
    build changes and this fix.
    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
2026-10-27 feat(net): Wi-Fi watchdogs and Discord gateway retry
    - IP_EVENT_STA_LOST_IP: rejoin (a lease lost without a disconnect used to
    leave netUp() true with no address behind it)
    - down with no driver events for 60 s: connect again; down for 10 min:
    restart the Wi-Fi driver
    - up but no network answers for 5 min (no Discord heartbeat ACK, no HTTP
    reply): rejoin. netNoteTraffic() is fed by the heartbeat ACK, weather
    httpGet and OpenWeather
    - Discord gateway client creation is retried every 30 s when it failed at
    boot (low internal RAM), instead of never
    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
2026-10-27 fix(host): Claude token refresh waits for the network and retries at once
    The refresh token rotates, so a refresh lost halfway leaves only a dead
    token (04:48 on 2026-10-27: IOException, then 400 on every later try).
    - no attempt while platform.claude.com:443 is unreachable
    - a network failure (no answer, connection cut) is retried after 3, 10 and
    20 s instead of 5 min, re-reading .credentials.json each time
    - a refreshed token that can't be written (file locked) is kept in memory
    and written on the next ticks instead of being lost
    - Http.Reachable(host, ms): TCP connect probe
    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
2026-10-27 feat(settings): one settings.h for secrets and setup values
    settings.h (gitignored) replaces secrets.h: the secrets first, unchanged,
    then 143 settings that used to be hardcoded: board pins and panels, LED,
    door/reset pulses, power and Wake-on-LAN, PC stats freshness, pcwarn
    thresholds, GPU/drive labels, PcHwCtl fan and RGB names, quota colours,
    frame-rate caps, night mode hours and levels, weather/nowcast/OWM/cyclone
    thresholds and polls, OwnTracks, and 24 HOST_* keys for the PC helper
    (Process Lasso path, night E-cores and keep list, pipes, NIC skip list,
    LibreHardwareMonitor groups, fonts, screenshot timing, monitor poll).
    settings_or_example.h holds every default (today's value, #ifndef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
2026-10-27 feat(settings): DDC/CI power monitor list in settings.h
    DdcPowerModels and DdcPowerOff (7d3ad39) become HOST_MON_DDC_POWER_MODELS
    ("DELL E1715S", comma list of DDC model names) and HOST_MON_DDC_POWER_OFF
    (4, DPM off). Same values, so no behaviour change.
    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
2026-10-27 fix(net): no chained assignments to volatile watchdog times (-Wvolatile)
    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
2026-10-27 feat(weather): Open-Meteo and OpenWeather agree before a rain warning
    Rain one source alone sees is a warning only when it is heavy, close, or
    has held for a couple of polls, and never while the other source is fresh
    and dry over that time (unless it is already raining for 3 polls). Anything
    less is a quiet watch: on the weather face, in `weather show` and the
    "Currently" update, never posted.
    - Re-post on the first warning, the 20-min heads-up, a tier rise, a start
    or end moving 10+ min; a plain countdown no longer posts
    - No made-up length: the hourly forecast fills in the end only when it has
    the rain; otherwise "length unknown"
    - Posts say who disagrees: "Seen by OpenWeather only (O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
2026-10-27 feat(weather): rain end from four sources, scored against the real end
    - OpenWeather's end counts once two of its hours agree within 5 min; with
    the nowcast's end too, the later one
    - Upwind probe (home): 8 Open-Meteo points along the motion vector, where
    the rain reaching home in 10-120 min is now; every 10 min while rain is
    coming or falling, end = halfway between last wet and first dry point
    - No end anywhere: the usual length by kind of rain from the hourly codes,
    shower 20-60 min, thunderstorm 30-90, steady "no end in the 12 h forecast"
    - Tracker: each source's first end guess against when the rain was seen to
    stop; per-source error, bias and lead in NVS, shown by `weather sho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
2026-10-27 feat(discord): PC Control panel shows the PC's components, refreshed every 5 s
    - PC Control tab: CPU (load, clock, temperature, power), RAM, both GPUs
    (load, temperature, VRAM), drive C:, fans and network, from the stats
    service; one "no data" line while the PC is asleep or the service is down
    - #control panel edited every CONTROL_PANEL_REFRESH_MS (5 s) whatever tab it
    shows; skipped when only the footer clock would change, forced every
    10 min, paused 30 s after a 429
    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
2026-10-27 fix(discord): #control panel edits every 5 s only for 3 min after an interaction
    Discord caps edits to messages older than an hour (429, code 30046), and
    the standing panel is old, so constant 5 s edits were refused all day.
    Any button, menu or slash command now opens a CONTROL_PANEL_LIVE_MS
    (3 min) window of 5 s refreshes (still skipped when nothing changed);
    outside it the panel is edited every 10 min and on PC state changes.
    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
2026-10-27 feat(night): helper reads PcHwCtl, night mode pins with efficiency mode and sleeps the PC
    ESP32-Helper drops its own hardware access for PcHwCtl's protocols:
    - Sensors come from PcHwCtl's sensor feed (subscribe sensors, Feed.cs);
    stats.ini uses @feed, plus @ram and @net for the keys the feed lacks.
    LibreHardwareMonitorLib and --bench are gone; --list prints the feed.
    - !mon goes to PcHwCtl's display commands; hw.mon.* reach the board as mon.*,
    hw.*_req* as pc.*_req*. The user half's DDC/CI code is gone (Idle.cs).
    - install.ps1 replaces an installed stats.ini that still has LHM rules.
    Night mode:
    - !night 1 saves the day config, then pins every included exe to E-cores
    14-17 in effici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
2026-10-27 feat(night): Low Power mode on the PC Control tab
    A "Low power" button (console `night low on|off`) applies the night's power
    side by hand, at any hour, until turned off: Process Lasso's night config
    (`!night 1`: E-cores in efficiency mode), PC LEDs 10 %, board panels 10 %
    with their normal faces, status LED capped at 20 %. Displays stay on, no
    sleep, input does not end it; saved in NVS. On and off post to
    #pc-announcement and Pushover. A night that ends while it is on leaves it on.
    The console now passes both words of `night` to nightConsole.
    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
2026-10-27 feat(night): PcHwCtl Night power plan for night and Low Power, helper at High priority
    Night mode and Low Power mode (both `!night 1`) now also switch Windows to
    PcHwCtl's "PcHwCtl Night" plan (`power plan night`: 5 % processor cap, half
    the cores parked); `!night 0` switches to PcHwCtl's day plan, High
    performance (`power plan day`). The PC Control tab shows the active plan
    (hw.plan). The ESP32PcStats service process runs at High CPU priority so the
    board's frames and replies stay on time while the PC is busy; the user-session
    half stays Normal.
    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
2026-10-28 feat(night): wake guard ends the night at once, sleep only, hibernate on leaving home
    - Wake check: the first input ends the night at once (everything back, PC
    displays on). No real return in the next 10 s (> 50 px or 3 presses) brings
    it straight back with its sleep clock and start time, without a post; a
    real return posts "Back to normal". End / Night auto off settle a pending
    check.
    - Every end of the night turns all PC displays on (`!mon power all on`).
    - No timed hibernate: the night sleeps the PC after NIGHT_SLEEP_S (1 h) only.
    When the phone (OwnTracks) goes from within NIGHT_LEAVE_KM (1 km) of home
    to beyond it, any hour, with Night auto on, the PC is hibernated: woken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
2026-10-28 fix(night): PC displays turned on once the PC is back, leave-home on any valid fix
    Night mode owes a "displays on" from the moment it turns them off, saved in
    NVS, and sends it when the night ends or is interrupted, or as soon as a PC
    that was asleep or hibernated at 06:00 is back; again every 30 s until the
    PC service answers ok (monReplyFor). The leave-home hibernate takes any
    valid OwnTracks fix (under 2 h) instead of one under 30 min: phones report
    less often.
    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
2026-10-28 feat(weather): alerts at Pushover high priority, 2-hourly update where you are
    - Rain warnings at every tier, "Rain soon where you are", typhoon posts and
    OpenWeather alerts go out at WEATHER_ALERT_PRIO (1, high); all-clears at 0.
    `weather test-alert` uses it too; the Pushover log names the priority.
    - The 2-hourly "Currently" update follows the phone: while it is away from
    home with a valid OwnTracks fix, one Open-Meteo call gets the weather at its
    location ("Currently where you are (N km from home)", with the phone
    engine's rain); else home. parseNow is split out of fetchForecast.
    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
2026-10-28 feat(owntracks): a fix lasts 12 h, the board asks a quiet phone for its location
    OwnTracks publishes on movement, so a phone sitting at school for hours
    went stale after 2 h and the weather fell back to home. OWNTRACKS_MAX_AGE_S
    is now 12 h (silence = same place), and the OpenWeather phone choice no
    longer wants a fix under 30 min. After OWNTRACKS_ASK_AFTER_S (30 min)
    without a fix the board publishes OwnTracks' reportLocation command to the
    device's /cmd topic (learned from its location messages), again every 30
    min until one arrives; the app answers when remote commands are on.
    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
2026-10-28 fix(firmware): PSRAM corruption hardening, two bug-sweep rounds, panel confirm hold
    PSRAM data went bad 2026-10-26..28 (bit flips at the PC's power-on
    brownout, corrupted heap blocks and socket-VFS pointers, interrupt
    watchdog resets).
    Hardening:
    - PSRAM at 40 MHz (no MSPI timing tuning at boot), PSRAM ECC on, and
    VFS select tables in internal RAM
    - a brownout boot waits 3 s, then restarts on a steady supply
    - PSRAM ECC corrections are logged every 10 s with the PC state
    - every boot after a panic or watchdog reset logs the core dump summary
    (task, PC, cause, backtrace)
    - Wi-Fi TX power capped (NET_WIFI_TX_DBM, 8 dBm): the router is close,
    less current on the shared 5 V
    Bug sweeps (t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
2026-10-28 refactor(helper): power actions and going detection belong to PcHwCtl
    PcHwCtl is the only thing that sleeps, hibernates, restarts, shuts down
    or locks the PC (power do, docs/ipc.md#power-actions-and-events there).
    Helper:
    - !power keeps the 60 s nonce dedupe and sends `power do <action> 1500`.
    PcHwCtl accepts or declines at once and acts 1.5 s later, so the ack
    reaches the board first. Accepted: power.ack "<action> <nonce>".
    Declined: "error <nonce> <PcHwCtl's reason>". PcHwCtl not running:
    "error <nonce> PcHwCtl offline, use Reset". There is no local fallback.
    - Deleted SetSuspendState, InitiateShutdown, GetPwrCapabilities, the
    shutdown privilege and lock code, the 1074 watcher,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
2026-10-29 fix(night): svchost and msmpeng no longer hold the board's night sleep
    Summed over dozens of instances, svchost idles around 0.4-1.6 cores, so
    once it turned heavy it never fell under the 0.3-core calm line and held
    sleep all night (00:38-05:44 on 10-29). HOST_NIGHT_HEAVY_IGNORE leaves
    those exes out of pc.heavy; they still count as heavy for pinning. Real
    work keeps the PC up through a power request, which the board checks
    on its own.
    Also in settings: weather summary and 3-day forecast from 04:00, the
    phone asked for its location at most every 2 h, and the drizzle
    thresholds below (shared settings file).
    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
2026-10-29 feat(weather): drizzle tier, warnings follow the phone, OpenWeather budget fix
    - Drizzle: a tier under Light Rain (WEATHER_LIGHT_RAIN_MMH 0.5). Rain
    counts from 0.3 mm/h (Open-Meteo's smallest step is 0.4 mm/h) and ends
    under 0.1, so night drizzle like 10-26 02:00-07:00 gets warned.
    - While you are away the full warning set (tier, ETA, start, end,
    cleared) runs for the phone's place and rings; home's go to Discord
    quietly (Pushover -1) until you are back. The one-shot "Rain soon
    where you are" notice is gone.
    - OpenWeather: a failed fetch at a new place forced another counted call
    every pass, using the 960-call day up by noon and leaving nights
    without it. The place last tried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
2026-10-29 docs(readme): match the code as of f4115ec
    - power actions go through PcHwCtl (lock, refusals, offline reason);
    HID keys remain the fallback for sleep and shutdown only
    - weather: Drizzle and Super Typhoon tiers, watches, warnings that follow
    the phone, 04:00-20:00 updates, Pushover priorities, 12 h OwnTracks fix
    - PSRAM at 40 MHz with ECC, brownout settle restart, heapguard, bench
    - Discord panel: which buttons ask first, the 60 s confirm hold, refresh
    cadence, Local Agent controls
    - full console command list, OTA and flash details, sdkconfig and
    partition summary, 195 settings keys, HOST_NIGHT_HEAVY_IGNORE
    - restart/update detection now PcHwCtl's; main task stack 10 KB; status
    Ass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
2026-10-29 docs: short README, reference material moves to docs/
    The README is an introduction now: what the board is, the screens image,
    the main features, the parts, a quick start and an index of docs/.
    Everything in depth moved, one page per topic:
    - hardware.md: the board, pin map, assembly, eFuse fix, bring-up, PCB build
    - screens.md, console.md, firmware.md (modules, pipeline, tasks, ESP-IDF
    options, PSRAM hardening)
    - power-and-night.md, discord.md, helper.md (install steps added)
    - build-and-flash.md (OTA, uploads, screenshots, CI)
    - settings.md (secret key names only) and settings-reference.md, generated
    from settings_or_example.h by the new scripts/settings_doc.py
    weather.md: Drizzle ti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
2026-10-31 feat(weather): RainViewer radar source, weather engine review fixes, hibernate follows the PC
    Weather:
    - radar.cpp: newest RainViewer frame, 256 px tile centred on the place
    (home, or the phone while away), decoded with pngle; rain on 3+ px at
    15 dBZ within 2.5 km counts as raining now, whatever the models say
    - warnings: time-based clear (20 min quiet), quiet follow-ups (night -1),
    home re-rings on return, state kept in NVS for 3 h
    - OpenWeather: paced over the UTC day, one retry and a 15 min grace on
    empty answers
    - home/away margin (1.0 / 1.5 km) with an accuracy check; tropical storms
    tracked; weather posts reach Pushover without a Discord token
    - Open-Meteo forecast every 15 m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
2026-10-31 feat(screens): uptime in the CPU card, VPN status on the media face
    - PC stats: the PC's uptime in the CPU card's header ("up 12d 07:41:00")
    - media face: the bottom card keeps its old layout; where the uptime was
    it shows PcHwCtl's VPN check: exit country over the tunnel stack
    (WARP, VPN, WARP+VPN, Off). Green when the exit is abroad, amber when
    it is the home country (learned with no tunnel, kept in NVS)
    - helper: hw.vpn*, hw.exit_* forwarded as pc.vpn*, pc.exit_*; the board
    keeps 80 texts (was 64)
    - readme_shots.py --real-media: the playing track and its cover art;
    README image re-captured
    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
2026-10-31 feat(gifs): GIFs built into the firmware, both at 20 fps
    The GIFs are no longer uploaded to FAT and decoded at boot. scripts/gif_pack.py
    packs firmware/gifs (listed in gifs.json) into firmware/main/gifs.bin, which is
    embedded in the app image. Each GIF has its own palette of up to 256 RGB444
    colours; frame 0 is stored whole and later frames as their dirty rects, all
    zlib-compressed and inflated into PSRAM at boot. Several GIFs take turns,
    GIF_SWITCH_S (15 s) each.
    Neuro and Evil Neuro are interpolated to 20 fps with RIFE (FluidFrame models),
    42 frames in all. PSRAM used drops from 5179 KB to 4374 KB, the lowest free
    rises from 1438 KB to 2456 KB, and FAT goes from 4.5 MB to 4 KB. The app im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
2026-10-31 feat(flash): 5 MB app slots, FAT shrunk to 5.9 MB
    The GIF pack lives in the app image, which filled 79% of a 3 MB slot. FAT
    held only 4 KB, so it gives 4 MB to the two OTA slots. The image now fills
    48% of its slot. A partition table change only reaches the board over USB
    (idf_flash.py), and moving /ffat reformats it.
    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
2026-10-31 feat(gifs): inflate frames as they play, March 7th as a third GIF
    GIF frames stay compressed in flash instead of being inflated into PSRAM at
    boot. A new gifdec task on core 1, at the main task's priority, inflates each
    frame into the panel's buffer and then hands it to flush. At priority 0 it
    shared only the idle time with IDLE1 and 20 fps fell to 9.8. Each frame costs
    15-16 ms of CPU, about 30% of core 1 for a 20 fps GIF. The tinfl state sits in
    PSRAM: internal RAM was no faster and cut SRAM lowest-free to 14 KB.
    PSRAM used drops from 4374 KB to 1585 KB. The cap rises from 64 frames and
    4 GIFs to 512 frames and 8; the 5 MB app slot is now the limit. perf reports
    inflate time per frame.
    M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
2026-10-31 feat(memory): drop OTA, free internal RAM
    OTA is gone: one 10 MB factory app slot at the old FAT boundary (FAT keeps
    its offset, so no reformat), bootloader rollback off, the /ota endpoint and
    scripts/ota_upload.py removed. Firmware goes over USB with idf_flash.py.
    OTA_PASS keeps its name for PUT /layout.
    Internal RAM pass:
    - heapguard (task, buffers, cache-error wrap) removed; the hunt ended 10-28
    - heap and ringbuf functions and the SPI master ISR run from flash
    - Wi-Fi static RX/TX buffers and BA window 8 -> 6
    - own .bss buffers to PSRAM through psramCalloc(): perf history, Discord
    command reply, console line buffers, nowcast engines, queue slots
    Static internal RAM 173 -> 145 KB, int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
2026-11-01 fix(firmware): crash and hang sweep of the network and weather half
    discord: a missed heartbeat ACK fired every 20 ms, filling the TCP
    buffer until the close call blocked the bot task. One close per
    interval now, and a second silent round replaces the client: a close
    frame ends the client's own pings, so a quiet server left it connected
    for good. HELLO sets heartbeatMs last.
    Null psramCalloc results: the notify and Pushover slots were references
    written through by xQueueReceive, the nowcast engines were built with
    placement new at boot. All checked now; weather stays off without them.
    weather: cyclone tracks parse outside wxMutex, so the scan no longer
    holds up the main loop, and a failed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
2026-11-01 fix(firmware): SPI ISR on the flush core, crash and hang sweep
    - display: SPI ISR on core 0 with the flush task. On core 1 it raced
    spi_bus_lock's bg_exit_core: a polling RASET ending between its reads of
    acquiring_dev made it load NULL->semphr (LoadProhibited, vaddr 0).
    - pcstats: values no float holds become NaN. net_down=Infinity turned into
    INT_MAX in drawSparkline and drawLine walked 2^31 steps past the watchdog.
    - layout: refuse JSON deeper than 8 levels; cJSON's recursion to 1000 overruns
    the httpd and main stacks. Spark pixel clamps NaN from infinite min/max.
    - display: gifdec skips frames with no pack loaded, and sleeps a tick when
    panels are queued back to back so IDLE1 c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
2026-11-01 feat(helper): monitors on before the PC sleeps
    A monitor that night mode powered off over DDC/CI stayed off after the wake
    until PcHwCtl's user-session agent came back, 20-30 s into the sign-in
    screen. When any monitor is off, a sleep or hibernate now goes to PcHwCtl
    with an 8 s delay instead of 1.5 s, and the helper runs display wake and
    display power all on meanwhile, so the monitors come back with the signal.
    A declined request leaves them as they were.
    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
2026-11-01 fix(spi): ESP-IDF bus lock race patched, SPI ISR back in flash
    The 2026-11-01 crash (task main, spi_bus_lock_bg_exit, load from 0) is
    ESP-IDF issue 18527: bg_exit_core read lock->acquiring_dev twice and the
    other core cleared it in between. Upstream commit a16c003 is on master,
    not in v5.5.6, so ESP-IDF is patched locally; the diffs now live in
    firmware/idf_patches with the older ldgen patch, to reapply after a
    reinstall. With the patch and the ISR pinned to the flush core, the SPI
    master ISR and the heap functions run from flash again (16 KB of IRAM).
    A 3.6 min stress (GIFs on all three panels, bench spi every 25 s) ran clean.
    Also: discord.cpp's path copy uses strlcpy (a fresh build faile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
2026-11-01 fix(usb): TinyUSB RX_PENDING and Xtensa LCOUNT upstream patches
    From an upstream sweep of the board's past bugs:
    - TinyUSB PR 3937 (issue 1292): an OUT endpoint was freed before the class
    copied its buffer, so a reader on the other core could re-arm a transfer
    into it. esp_tinyusb 3.0.0 lacks it and managed_components can't be
    patched, so a copy lives in firmware/vendor/esp_tinyusb with the patch,
    pulled in by override_path. Art resend requests: 14 in the hour before,
    none in the first 35 min after.
    - ESP-IDF a00bb2d1cb: interrupt entry zeroes LCOUNT so handler code can't
    loop back into an interrupted zero-overhead loop (hardening).
    Both patches are in firmware/idf_patches. Comme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
2026-11-01 feat(screens): pinned faces survive a restart
    A screen picked per panel in the Discord Display tab (the face command)
    was lost on every reboot. screensForce is now saved in NVS
    ("screens"/"force", one byte per panel) on each change and loaded at boot,
    so a pin stays until the panel is set back to auto.
    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
2026-11-01 perf(gif): LZ4 pack, optimal rects, RGB444 packed on the way out
    - gif_pack.py: the dirty rects are the cheapest cover of a frame's changed
    8-row bands by at most 8 rects (64-70% of the screen, was 86-95%); frames
    are LZ4-HC blocks, pack format 2 (1407 KB, was 1199 KB with zlib). Needs
    the lz4 pip package.
    - gif_store: a bounds-checked LZ4 block decoder replaces tinfl. Frames decode
    into a per-panel buffer, and the panel's frame is kept only on the overlay
    band's rows; key frames, band moves and segment switches rebuild it whole.
    - display: flush packs the indices to RGB444, 8 px per word triplet, into
    the internal DMA chunks, each while the previous one is on the wire.
    - shot re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
2026-11-01 chore(display): SPI bus budget default 95%
    The 85% budget never deferred a frame with GIFs on all three panels; 95%
    gives the token bucket headroom. settings.h keeps its own value.
    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
2026-11-01 feat(gifs): six GIFs in their own partition, shuffled turns
    Firefly, Miku and Filian join at 20 fps (140 frames, 3.7 MB pack). The pack
    moves out of the app image into a 5 MB gifs partition, memory-mapped at boot;
    the app slot is 9.9 MB and FAT shrinks to 1 MB. GIFs now take turns in shuffled
    rounds, none twice in a row.
    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
2026-11-01 feat(gifs): Kita, Teto and Herta, gifs partition 6 MB
    Nine GIFs, 220 frames, pack 5645 KB: app 8.9 MB, FAT 1 MB, GIFs 6 MB,
    up to 12 GIFs. One panel 20 fps on every GIF.
    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
2026-11-01 feat(gifs): replace Herta with an even 8-frame turn
    16 frames over 0.8 s with RIFE midpoints. Pack 5707 KB, 222 frames.
    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
2026-11-01 feat(gifs): predicted frames, flat backdrops, twelve GIFs
    Pack v3: each 8x8 block shifts into the frame before and a pixel within
    one colour level of it costs one symbol. The packer also flattens
    backdrops. The same nine GIFs went from 5707 KB to 3730 KB, which made
    room for Bocchi, Miku player and PPPP Teto: 472 frames, 6071 KB.
    gifCur now holds the whole frame. gifdec runs above main: one panel
    19.9 fps, two 19.6, three 14.9.
    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
2026-11-01 feat(pcwarn): no RTX 3050 warnings while the local model runs
    The local model runs on the RTX 3050, so its load and heat are expected
    while the model loads or works. GPU2 load and temperature warnings stay
    off then and for 60 s after, while the card cools; pcwarn says so.
    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
2026-11-01 refactor(helper): hand screenshots to PcHwCtl
    PcHwCtl's agent now captures, shows the border, uploads and deletes. The
    helper only relays !shot as `screenshot <nonce> <webhook>`, so the user
    half's capture, border, upload and pending-delete code goes, along with
    the service-to-user-half line and the HOST_SHOT_* settings.
    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
2026-11-01 feat(presence): desk presence for night mode, away and day rules
    The helper runs PcHwCtl's camera check at the pace the board sets with
    !pres and reports it as pc.present; presence.cpp and night.cpp hold the
    rules.
    Night: past the idle timer someone at the desk holds the night off for
    30 min, nobody engages and sleeps at once, or only turns the displays
    off while sleep is blocked. The wake guard counts the camera, which can
    overrule real input once per 2 min.
    Away (phone beyond 200 m): displays off, on again when back. Someone at
    the desk on two checks locks the PC and sends a red post and a Pushover
    emergency, after asking the phone for a fresh fix if the last one is
    old. Pushover priorit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
2026-11-02 feat(presence): by day, Windows display off and low power mode after 5 min
    Checks run every minute at home outside the night window. Nobody seen and
    no input for 5 min (PRESENCE_DAY_OFF_S, replaces PRESENCE_DAY_IDLE_S),
    nothing keeping the display on: Windows' own display off (new !mon
    power all sleep|wake, no DDC/CI) and low power mode on unless something
    holds sleep, tried again at each check. Someone seen, input, the PC off
    or the phone home: displays back, low power mode off if this turned it
    on. Low power posts now say what turned it on or off.
    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
2026-11-02 feat(presence): detection on/off, saved in NVS
    Console `presence on|off`. Off: no camera checks and no answer counts, so
    night mode goes by input alone and the desk and intruder rules rest; the
    phone-away displays-off stays.
    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
2026-11-02 fix(security): fixes from the 2026-11-02 audit
    - Board-helper link: shared LINK_KEY challenge (@auth / !auth HMAC); the
    helper sends no stats and takes no board line until it checks
    - Helper: named pipes only to the real PcHwCtl / LocalAIHost service
    process; install folder and ProgramData data dir SYSTEM + Admins only;
    night.on and the Lasso backup must be admin-owned files, not links; fonts
    only from Windows\Fonts and the install folder; screenshot webhook kept
    in the helper, the board sends !shot <nonce> only; board lines filtered
    - OwnTracks: payloads encrypted end to end (libsodium secretbox,
    OWNTRACKS_SECRET); depth-guarded JSON, stale fixes rejected
    - Board: /bench needs X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
2026-11-02 feat(presence): PC-only low power by day, away alert needs the PC in use
    - Nobody at the desk by day: low power mode is PC only (Process Lasso night
    config); PC LEDs, board panels and status LED stay as they are. Saved in
    NVS, so a board restart no longer leaves it on; the button shows "PC only"
    and turns it into the full mode by hand
    - Away: someone seen on two checks in a row alerts only with input on the
    PC in the last PRESENCE_USE_S (30 s); someone in the room who leaves the PC
    alone is logged once. Repeats need only the camera. The second check is the
    next regular one (PcHwCtl replays a check asked for within 10 s)
    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
2026-11-02 feat(flash): write only the regions that changed
    idf_flash.py compares the board's MD5 of each image (verify_flash, which
    patches the bootloader header as write_flash does) and writes the ones that
    differ over the same stub: an app change writes 1.7 MB in ~20 s and leaves
    the 6 MB GIF pack alone. --full, or a failed check, flashes everything.
    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
2026-11-02 feat(screens): AFK while away from the PC
    Nobody at the desk for 5 min by day, or the phone away without input: the
    board panels show their PC-off faces (pins ignored, as in night mode) and
    the clock chip reads "AFK".
    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
2026-11-02 feat(presence): displays off the moment the chair is empty
    By day at home: a check every 10 s (was 60); the first one that sees nobody,
    with no input for 10 s and no video wake lock, turns the displays off and
    shows the AFK faces (was 5 min). While they are off, a check every 2 s gives
    them back (needs PcHwCtl presence.minIntervalS <= 2). Low power mode (PC
    only) still waits 5 min of nobody: each switch moves every process.
    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
2026-11-02 fix(helper): Claude plan is Pro, Max or Ultra
    The plan name comes from subscriptionType; rateLimitTier only stands in
    without it, its usage multiplier (5x, 20x) dropped. The board shows
    "Claude Max" (chip "Max") instead of "Claude Max 5x".
    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
2026-11-02 docs: match docs to the code; add documentations summary
    Helper README: no service-to-user S line, RGB444 cover art and per-tick
    chunk limits, power do 1500/8000 ms, own Claude token refresh, agy keys,
    !mon/!night/!auth lines. Settings: key counts, HOST_* notes. Scripts
    README gaps, no OTA, TinyUSB events, firmware task and view details.
    New docs/documentations_summary.md points to the cross-repo design doc.
    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
2026-11-02 docs(readme): companion projects table
    PcHwCtl, the Local LLM stack and the new ESP32 Human Presence Radar, as in
    the Radar repo's README; the radar link is in development.
    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
2026-11-03 fix(night): pchwctl and WebView2 don't hold sleep; log each holder once
    - HOST_NIGHT_HEAVY_IGNORE adds pchwctl (its camera checks keep it near a
    core) and msedgewebview2 (always busy), next to svchost and msmpeng
    - "sleep held" compares the reason without its numbers, so a load moving
    from 1.0 to 0.3 cores no longer logs every 10 s
    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
2026-11-03 docs: point to renamed system architecture docs (ESP32 PC Control System)
    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
2026-11-03 feat(presence): PcHwCtl's zone; someone in the room is not at the desk
    The helper adds PcHwCtl's distance zone (desk, near, room, -) to
    pc.present as a fifth field. Someone seen only in "room" (beyond ~1.6 m)
    counts as nobody at the desk for every rule: walking past or lying in bed
    doesn't keep the displays on, hold the night off or start the intruder
    rule. desk, near and "-" (too dim to judge) stay someone. Four-field
    answers still parse. `presence seen room` fakes one.
    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
2026-11-04 feat(gifs): second Firefly dance in for Evil Neuro; 8 MB GIF partition
    The app slot goes from 8.9 MB to 6.9 MB and the gifs partition from 6 MB to
    8 MB, with FAT moved below it (it reformats on first boot). Caps go to 16 GIFs
    and 768 frames. Twelve GIFs, 6040 KB, 2.1 MB free.
    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
2026-11-06 fix(enclosure): unmirror model, fill lid with block, add screen backplate
    First print run came back mirrored: the model used KiCad board coordinates
    (Y down) with Z up. Everything is now mirrored back once, and a build guard
    checks handedness against the top silkscreen (USB-C top, screens right,
    keyfob notch bottom-left).
    The block was 4.4 mm short at the USB-C end; it now fills the lid with
    0.2 mm per side, and a second guard fails the build on nesting gaps.
    New backplate clamps the screens against the mask so they cannot slip out:
    2.54 mm plate behind the panels with rear-part windows and header slots,
    7 pegs into the mask. Adds a 1:1 paper template to check the model against
    the real PC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
2026-11-08 fix(discord): one retry when Discord's proxy fails before the API
    Plain-text 502-504 from envoy ("envoy overloaded", "upstream connect error
    ... before headers") never reached Discord, so a second try on a fresh
    connection is safe. Lost button acks showed "This interaction failed".
    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
2026-11-13 feat(discord): per-monitor power buttons; equal-width button grid
    - Monitor tab: one on/off button per monitor (mon_pw_N), All on / All off;
    Target on / off when more than 4 monitors
    - Buttons three to a row (Door two), labels padded with U+2800 to the
    widest so every button has the same width
    - Refresh and Close moved into the category dropdown
    - Toggles show a check and turn blurple when on; Context is one toggle
    - Dropdown Refresh re-reads AI status; unknown monitor power presses on;
    RGB group row width adapts to stay within 5 rows
    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
